h4ck3rm1k3/Cold-Saw/components/90/ReadyforBending.jpg

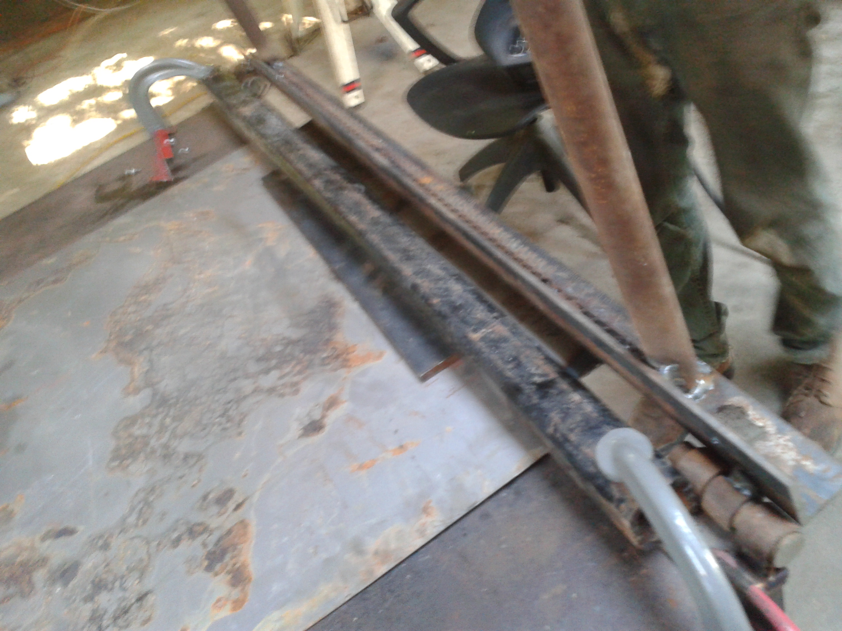
components/90/ReadyforBending.jpg
