h4ck3rm1k3/Cold-Saw/components/29/fabpics/BGSupportMark.JPG

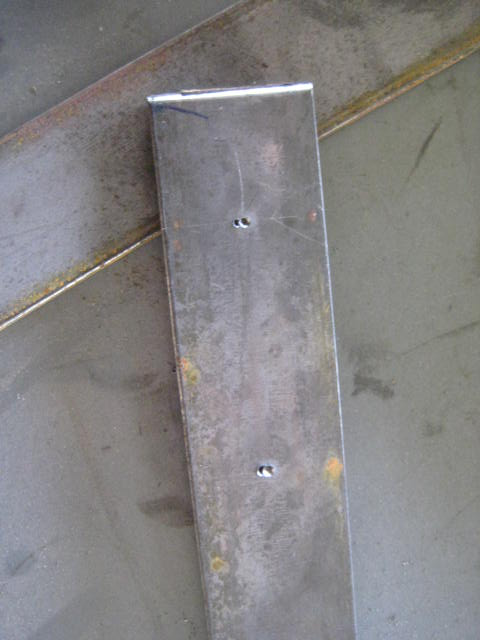
components/29/fabpics/BGSupportMark.JPG
