h4ck3rm1k3/Cold-Saw/components/90/NOTE.txt

the bend tool pictured is wrongly built, it should bend the piece
as the tool is raised upwards, not as it descends.
