h4ck3rm1k3/Cold-Saw/CalculationRationale/ViseElevationPartRationale.odt

The vise-supporting platform is large. The vise is fastened by 4 bolts. Reason: for irregular-shaped materials, the vise can be removed and the platform can be used as the work surface. Of course, elevating materials must be placed as to create a blade slot.
