h4ck3rm1k3/Cold-Saw/specs.ods

Weight | <135kg (<300lb)
Drive Type | Hydraulic
Transmission | Direct drive, key-keyway-holdingsetscrew coupling to pins-pinholes-holdingcollar
Speed | Adjustable, minimum range 30-90rpm
Torque | >5800kg-cm (>5000in-lbs)
Blade Mounting | Axial-radial shaft collar
Blade Pinhole Pattern | 2x8x45 (2 pinholes, each 8mm diameter, 45mm center-to-center from each other)
Stopper Type | Mechanical, Collar-based
Cut Angle Mechanism | Acme threaded rod and nut
Horizontal Cut Angle | +-45 degrees
Vise Max Opening | 100mm (4") with 2" deep clamp jaws
Vise Type | Autocentering
Submersible Pump Type/Flow | Brushless DC/Adjustable, approx. 4L/min (1Gal/min) at 12V
Automation Sensor/Processing/Relay | Infrared proximity/Arduino Uno Microcontroller/Opto 22 Relay
Coolant Transmission | Silicone Rubber Tube
