h4ck3rm1k3/Cold-Saw/CalculationRationale/SwivelMountDimensions/ColdSawSwivelAngle.png

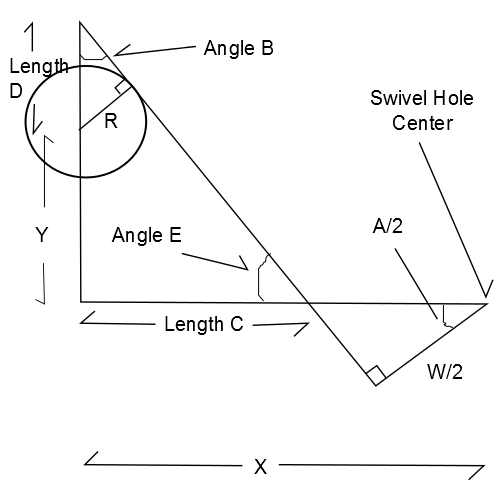
CalculationRationale/SwivelMountDimensions/ColdSawSwivelAngle.png
