h4ck3rm1k3/Cold-Saw/devtemp/Base/AngleIndicator/AngleIndicator.JPG

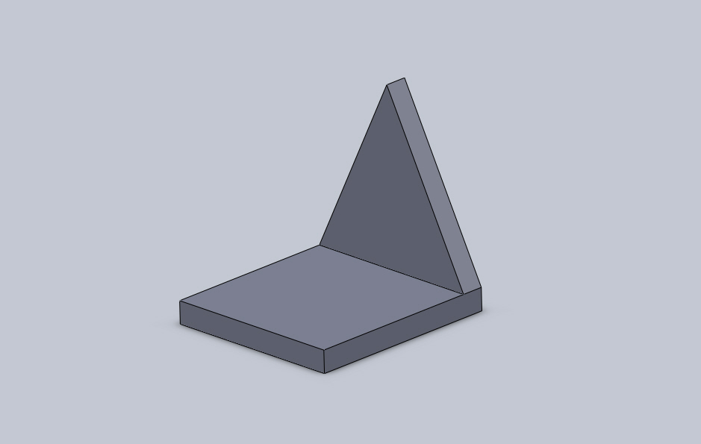
devtemp/Base/AngleIndicator/AngleIndicator.JPG
