h4ck3rm1k3/Cold-Saw/devtemp/Base/AngleIndicator/AngleIndicatorD.JPG

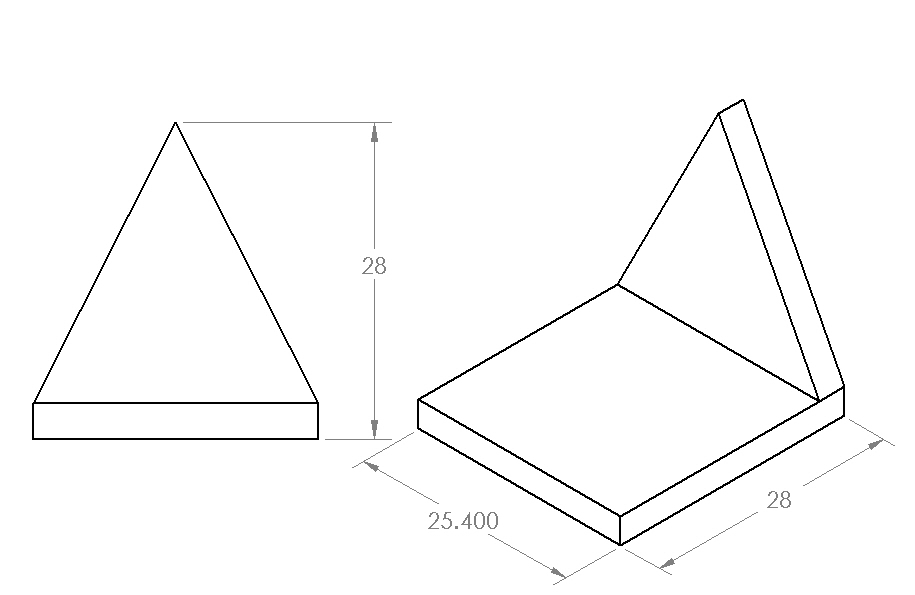
devtemp/Base/AngleIndicator/AngleIndicatorD.JPG
