h4ck3rm1k3/Cold-Saw/devtemp/Base/BaseFlat/BaseFlat.JPG

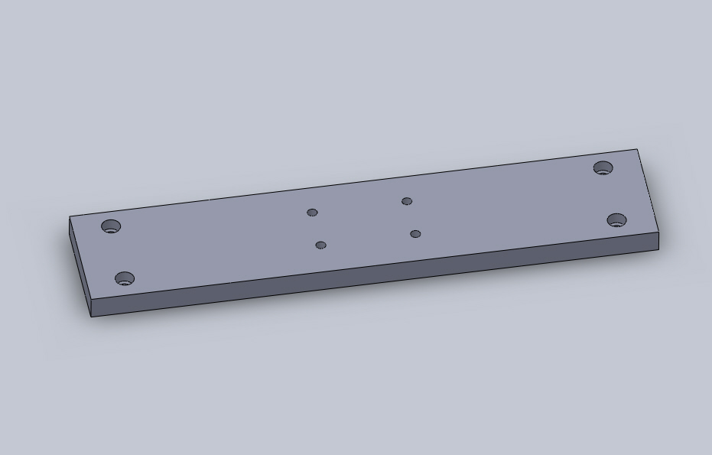
devtemp/Base/BaseFlat/BaseFlat.JPG
