h4ck3rm1k3/Cold-Saw/devtemp/Base/BaseFlat/BaseFlatD.JPG

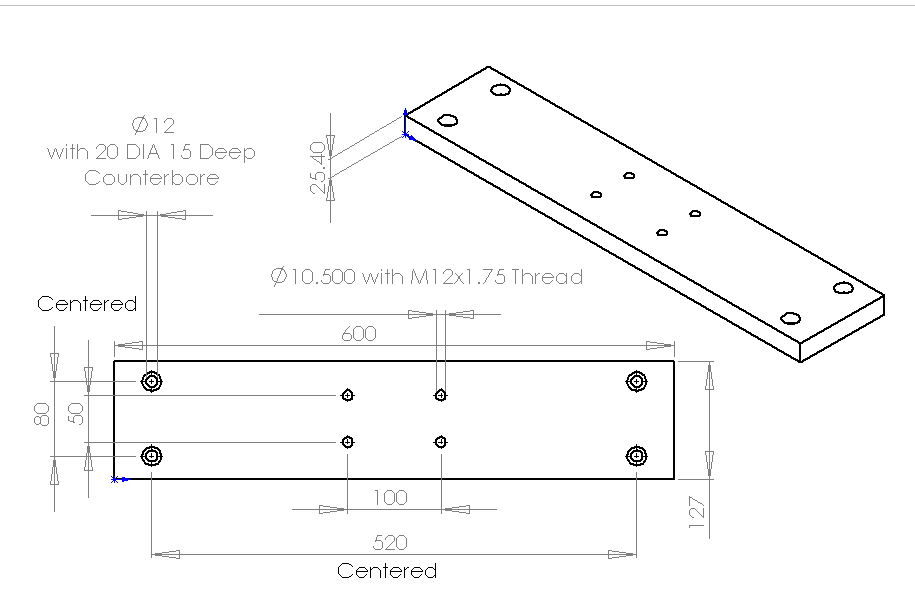
devtemp/Base/BaseFlat/BaseFlatD.JPG
