h4ck3rm1k3/Cold-Saw/devtemp/Base/BaseFlat/BaseFlatFab.JPG

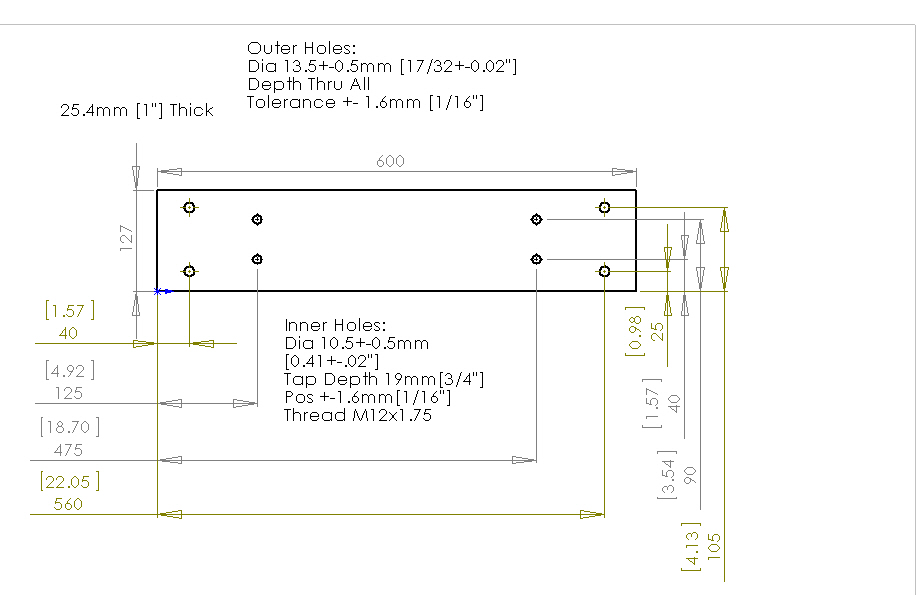
devtemp/Base/BaseFlat/BaseFlatFab.JPG
