h4ck3rm1k3/Cold-Saw/devtemp/Base/IndicatorFlat/IndicatorFlat.JPG

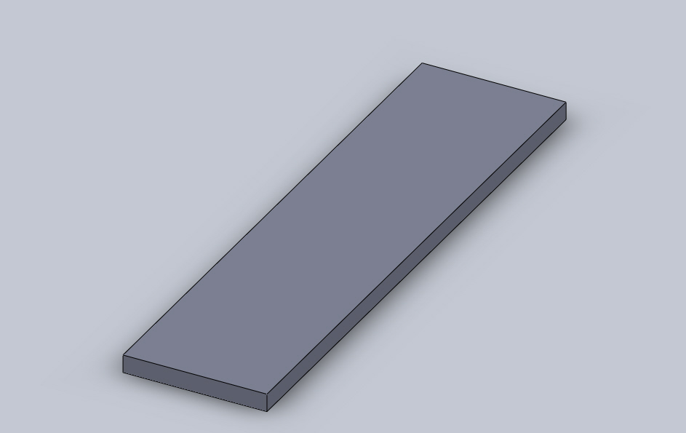
devtemp/Base/IndicatorFlat/IndicatorFlat.JPG
