h4ck3rm1k3/Cold-Saw/devtemp/Base/IndicatorFlat/IndicatorFlatD.JPG

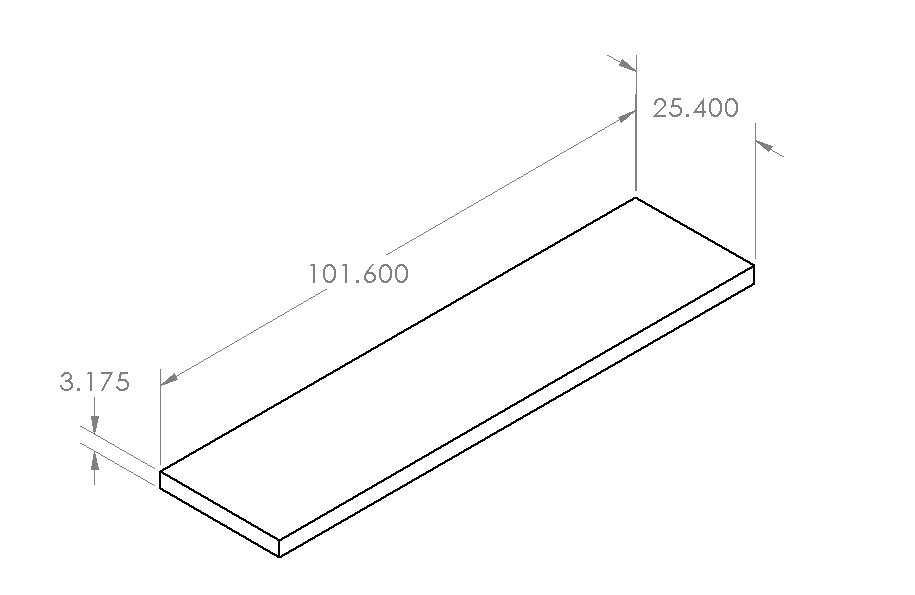
devtemp/Base/IndicatorFlat/IndicatorFlatD.JPG
