h4ck3rm1k3/Cold-Saw/devtemp/Base/ShortSpacer/ShortSpacer.JPG

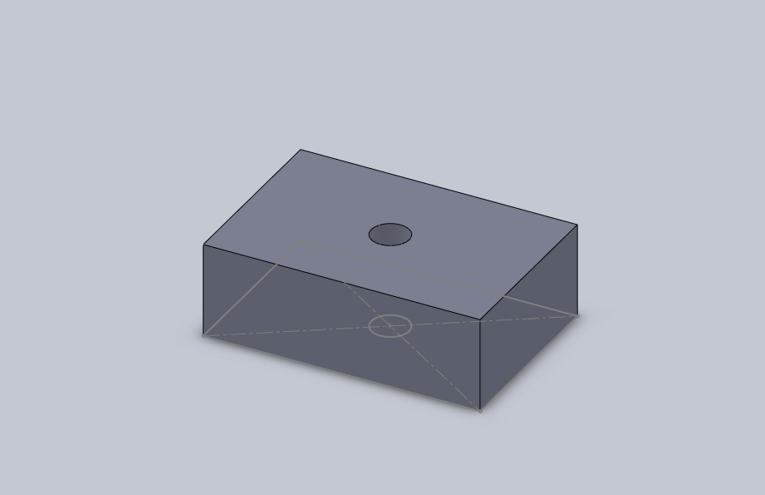
devtemp/Base/ShortSpacer/ShortSpacer.JPG
