h4ck3rm1k3/Cold-Saw/devtemp/Base/ShortSpacer/ShortSpacerD.JPG

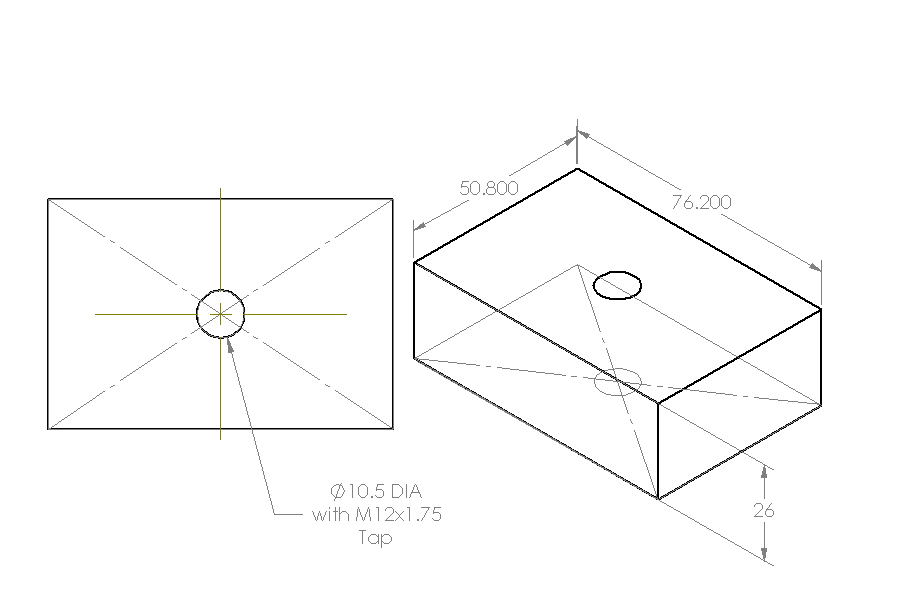
devtemp/Base/ShortSpacer/ShortSpacerD.JPG
