h4ck3rm1k3/Cold-Saw/devtemp/BladeGuard/GuardFlat/GuardFlat.JPG

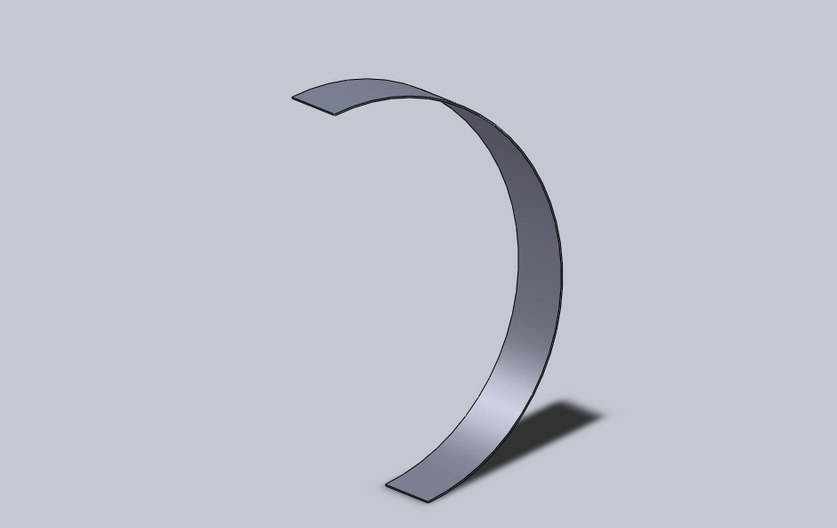
devtemp/BladeGuard/GuardFlat/GuardFlat.JPG
