h4ck3rm1k3/Cold-Saw/devtemp/Fasteners/CollarSetscrew/CollarSetscrew.JPG

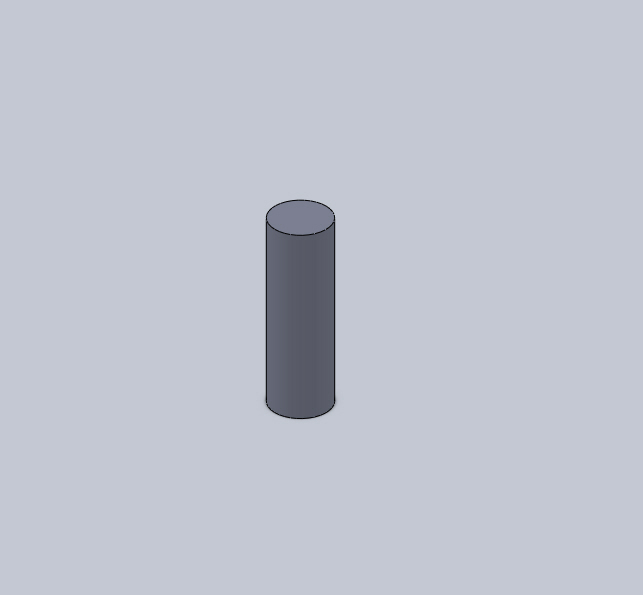
devtemp/Fasteners/CollarSetscrew/CollarSetscrew.JPG
