h4ck3rm1k3/Cold-Saw/devtemp/Fasteners/CouplingSetscrew/CouplingSetscrew.JPG

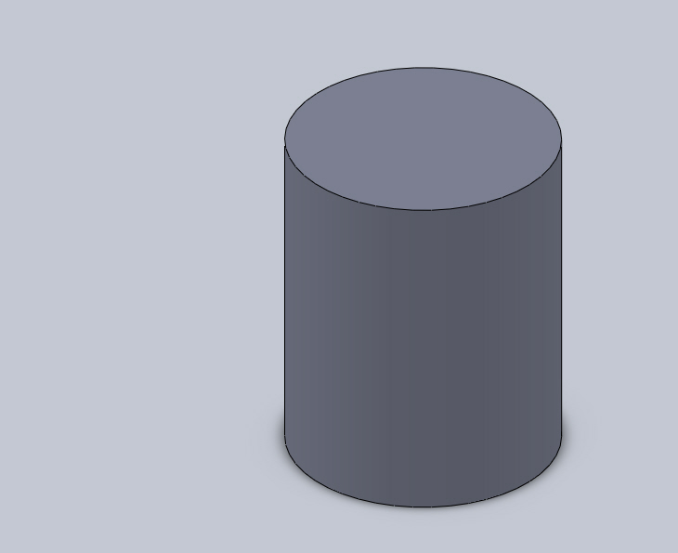
devtemp/Fasteners/CouplingSetscrew/CouplingSetscrew.JPG
