h4ck3rm1k3/Cold-Saw/devtemp/Fasteners/CouplingSetscrew/CouplingSetscrewD.JPG

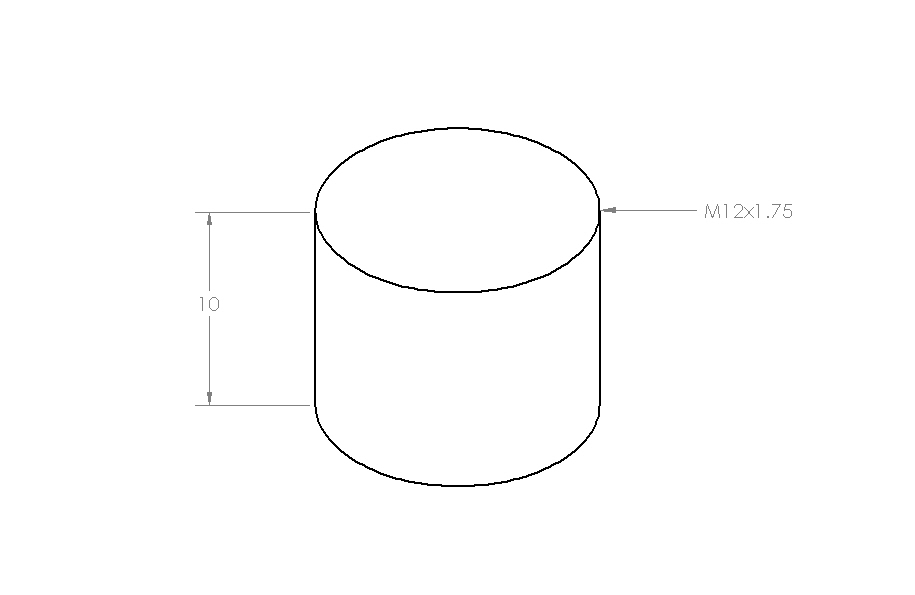
devtemp/Fasteners/CouplingSetscrew/CouplingSetscrewD.JPG
