h4ck3rm1k3/Cold-Saw/devtemp/Fasteners/ShortThreadedRod/ShortThreadedRod.JPG

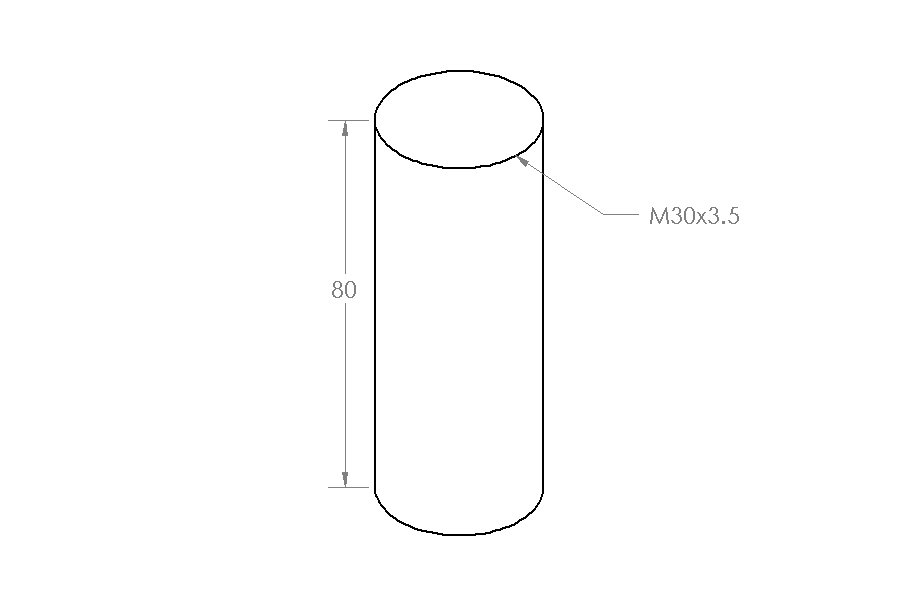
devtemp/Fasteners/ShortThreadedRod/ShortThreadedRod.JPG
