h4ck3rm1k3/Cold-Saw/devtemp/Fasteners/ThreadedRod/ThreadedRod.JPG

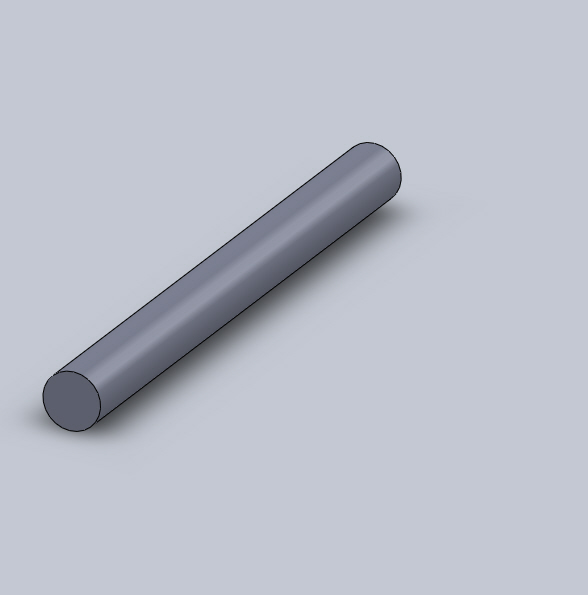
devtemp/Fasteners/ThreadedRod/ThreadedRod.JPG
