h4ck3rm1k3/Cold-Saw/devtemp/Fasteners/ThreadedRod/ThreadedRodD.JPG

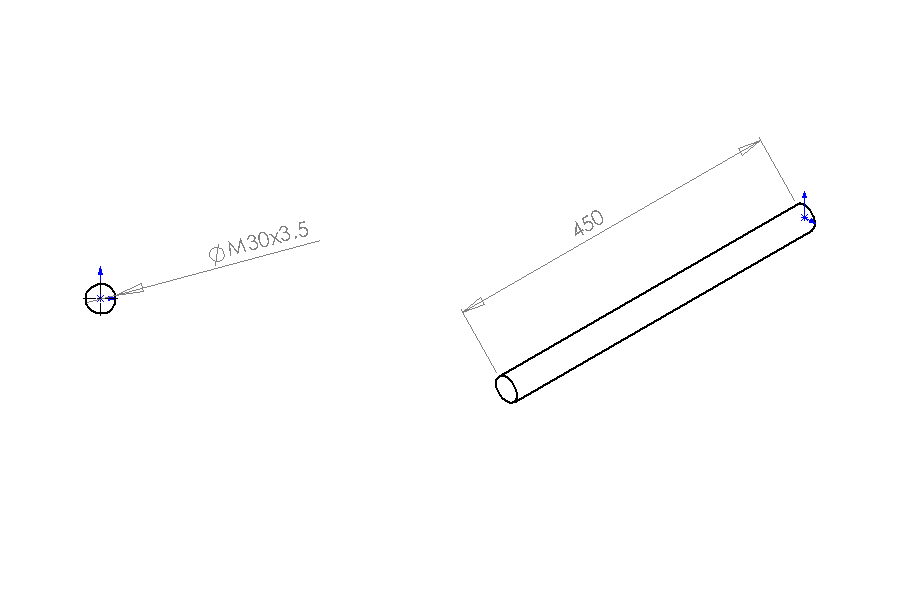
devtemp/Fasteners/ThreadedRod/ThreadedRodD.JPG
