h4ck3rm1k3/Cold-Saw/devtemp/Magnet/Magnet.JPG

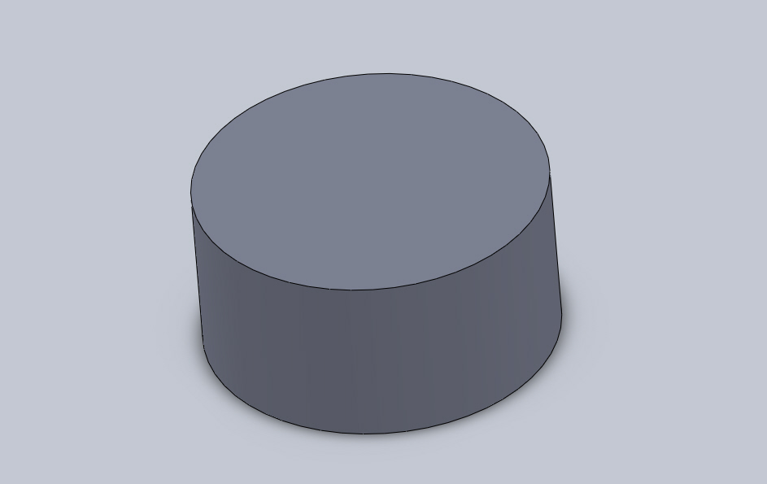
devtemp/Magnet/Magnet.JPG
