h4ck3rm1k3/Cold-Saw/devtemp/Magnet/MagnetD.JPG

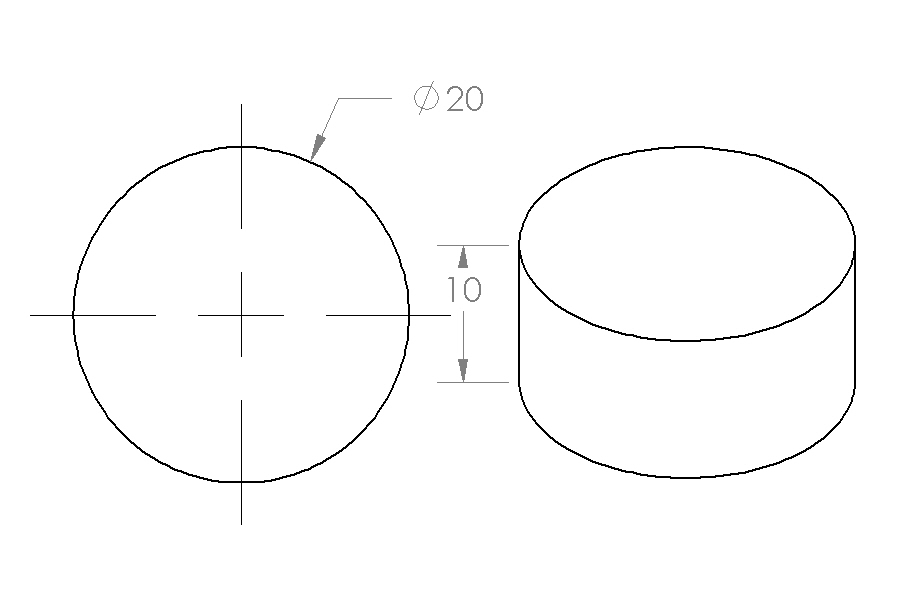
devtemp/Magnet/MagnetD.JPG
