h4ck3rm1k3/Cold-Saw/devtemp/Rotation/Pin/Pin.JPG

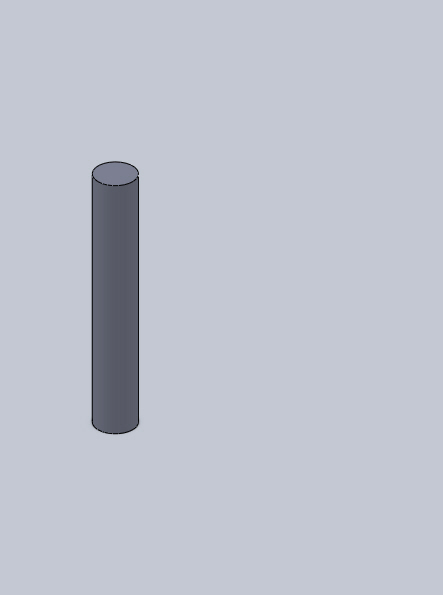
devtemp/Rotation/Pin/Pin.JPG
