h4ck3rm1k3/Cold-Saw/devtemp/Shaft Accessories/PinCollar/PinCollar.JPG

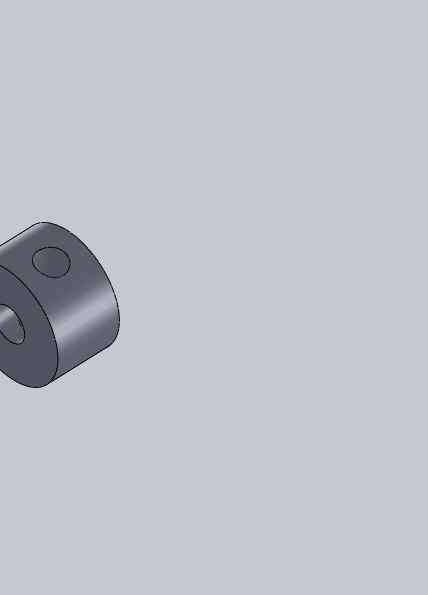
devtemp/Shaft Accessories/PinCollar/PinCollar.JPG
