h4ck3rm1k3/Cold-Saw/devtemp/Shaft Accessories/SupportThrustWasher/SupportThrustWasher.JPG

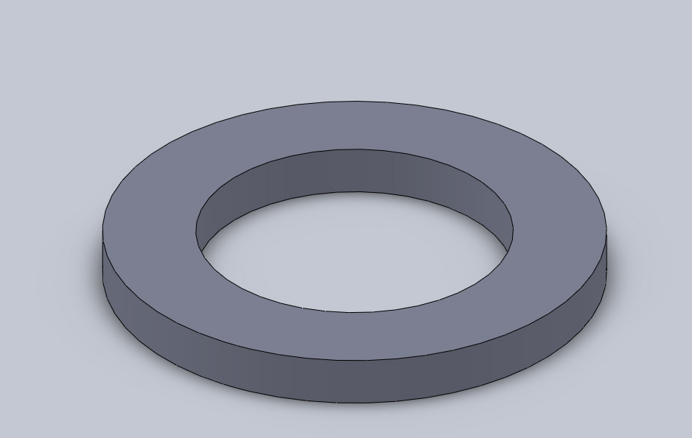
devtemp/Shaft Accessories/SupportThrustWasher/SupportThrustWasher.JPG
