h4ck3rm1k3/Cold-Saw/devtemp/Shaft Accessories/SupportThrustWasher/SupportThrustWasherD.JPG

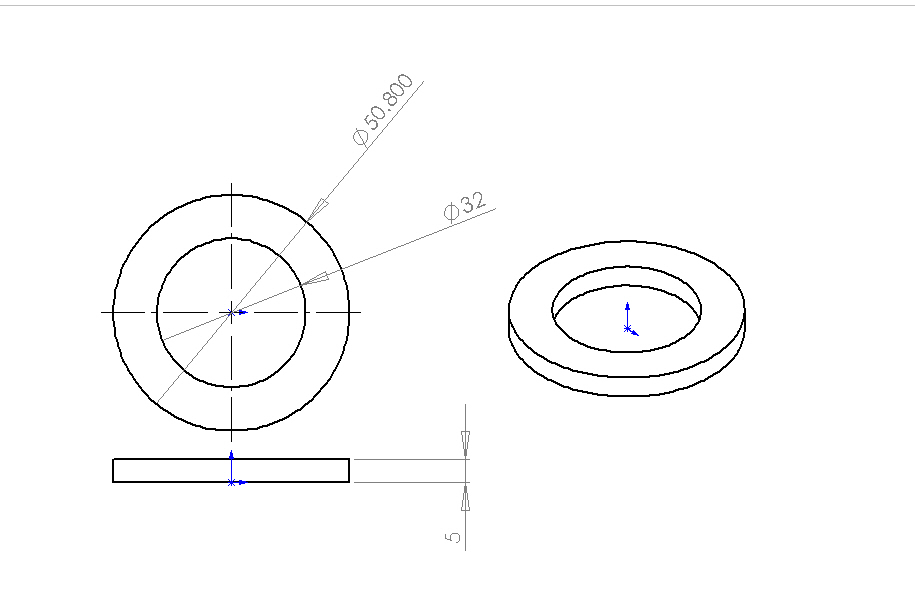
devtemp/Shaft Accessories/SupportThrustWasher/SupportThrustWasherD.JPG
