h4ck3rm1k3/Cold-Saw/devtemp/Support/BridgeFlat/BridgeFlat.JPG

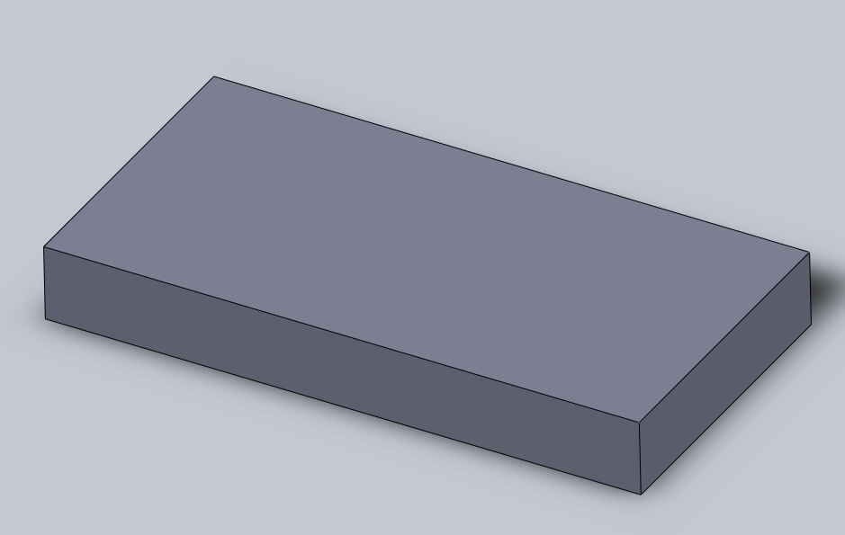
devtemp/Support/BridgeFlat/BridgeFlat.JPG
