h4ck3rm1k3/Cold-Saw/devtemp/Support/BridgeFlat/BridgeFlatD.JPG

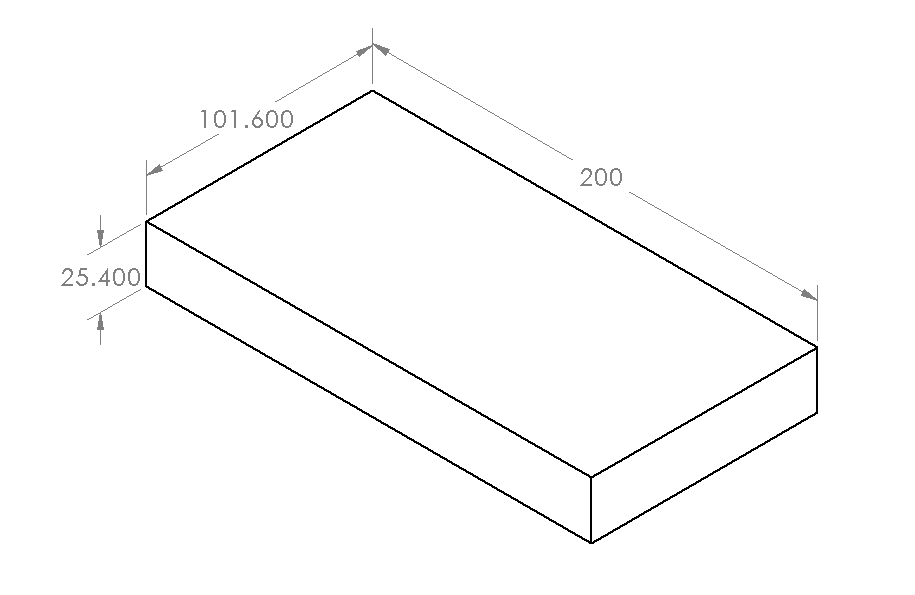
devtemp/Support/BridgeFlat/BridgeFlatD.JPG
