h4ck3rm1k3/Cold-Saw/devtemp/Swivel/ShaftBlock/ShaftBlock.JPG

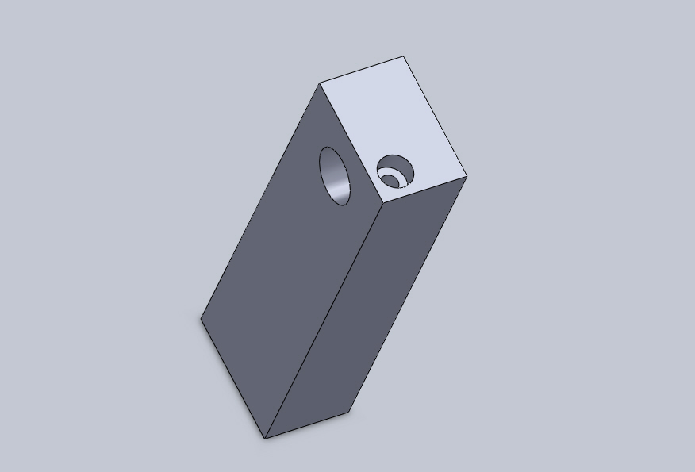
devtemp/Swivel/ShaftBlock/ShaftBlock.JPG
