h4ck3rm1k3/Cold-Saw/devtemp/Swivel/ShaftBlock/ShaftBlockD.JPG

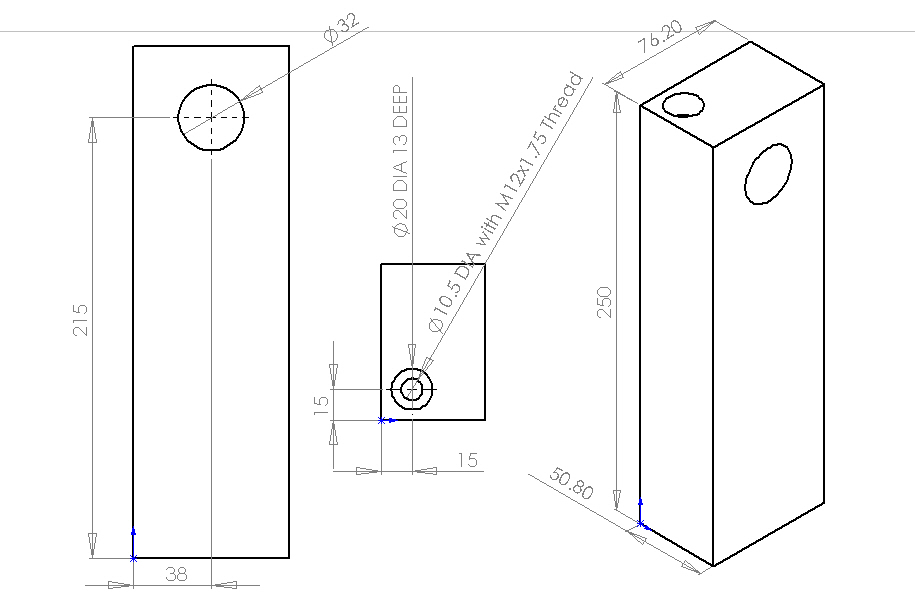
devtemp/Swivel/ShaftBlock/ShaftBlockD.JPG
