h4ck3rm1k3/Cold-Saw/devtemp/Swivel/ShaftBlock/ShaftBlockFab.JPG

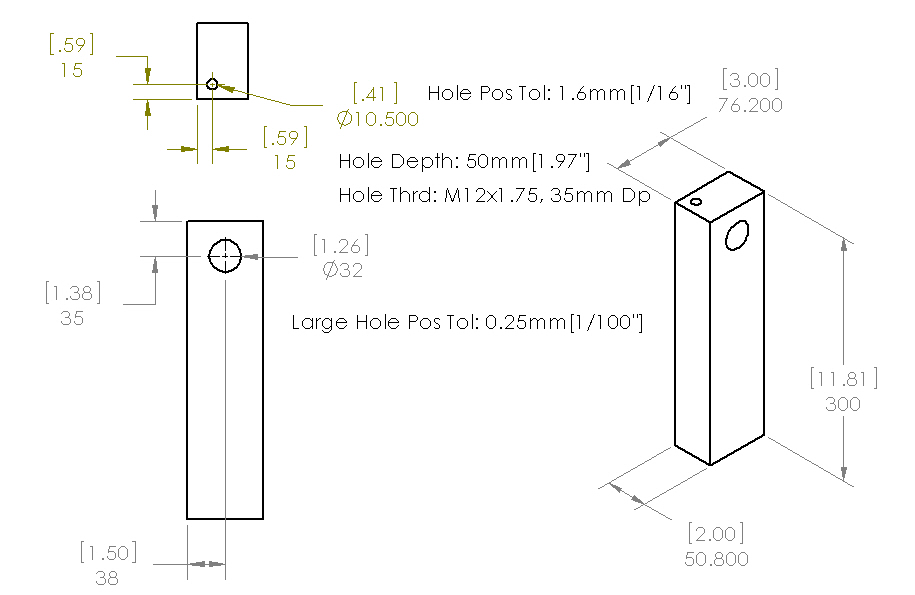
devtemp/Swivel/ShaftBlock/ShaftBlockFab.JPG
