h4ck3rm1k3/Cold-Saw/diagrampng.png

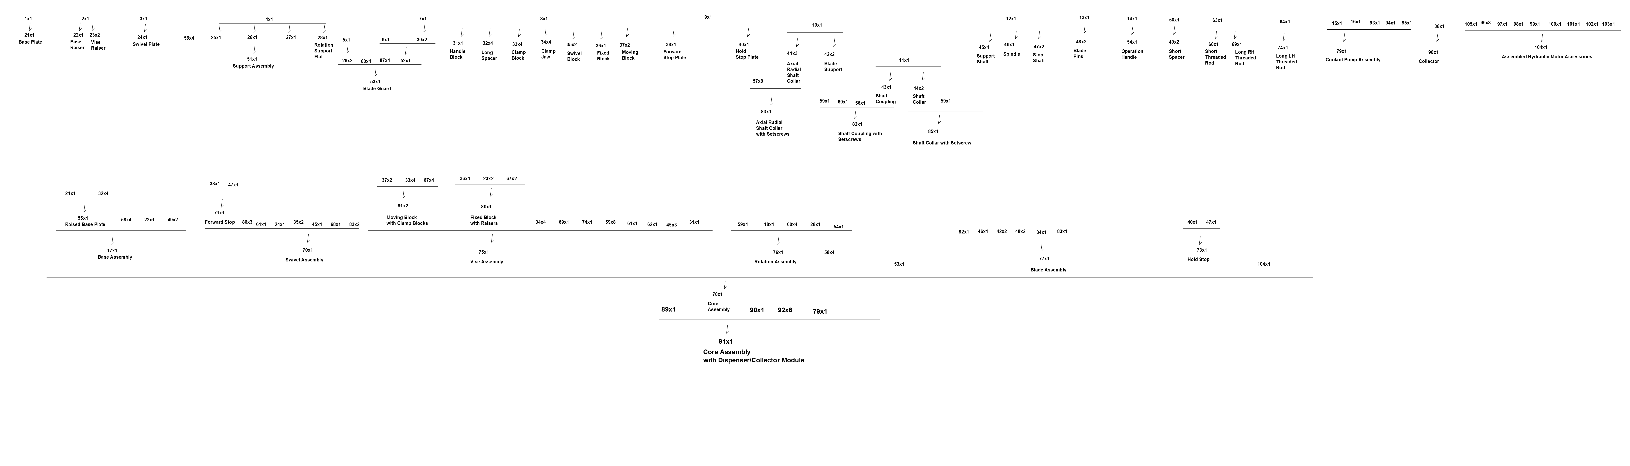
diagrampng.png
