h4ck3rm1k3/Cold-Saw/temppics/2012-08-12 17.03.41.jpg

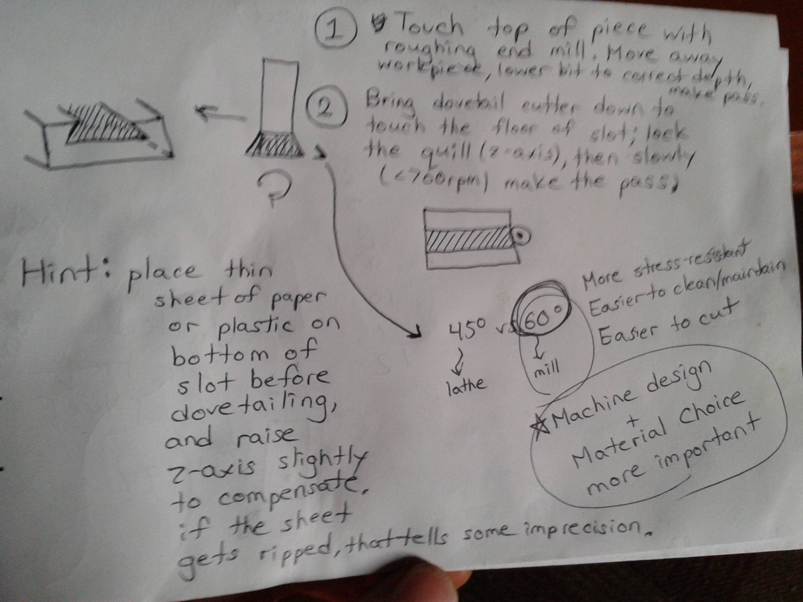
temppics/2012-08-12 17.03.41.jpg
