h4ck3rm1k3/Cold-Saw/temppics/2012-08-17 19.16.24.jpg

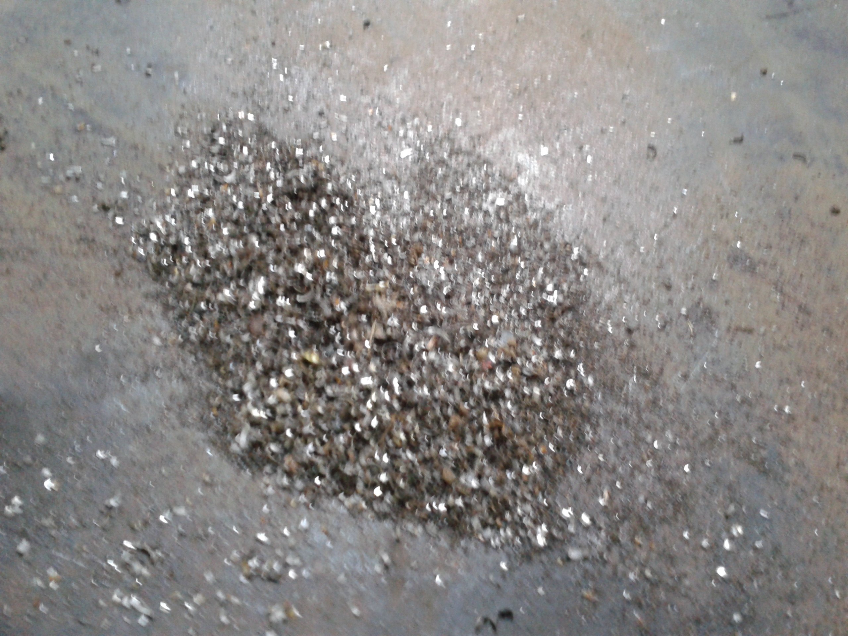
temppics/2012-08-17 19.16.24.jpg
