h4ck3rm1k3/Cold-Saw/CalculationRationale/BladeandorMaterialMove.odt

=Simply Move a Single Thing=

Just move one or the other. Moving both is unnecessarily complex for our functional objectives.

=Easy to Push Things Down=

Especially if the moving motion is manually performed, it's easier to push down on something because gravitational forces reinforce downward motion. So whatever moves should move down.

=Dangerous Fall Hazards=

Assume the material is selected to move toward the blade. If the material is moving down toward the blade, then the blade must be exposed at its top. It is much more likely to fall and get hurt by a blade if it is exposed on the top rather than on the bottom.

=Impractical Mounting Dimensions=

Assume the material is selected to move toward the blade, and that the material is placed into the clamp from above. When the blade cuts the material, the blade will have to cross a lot of the important frame locations for whatever is holding the material.

=Non-ergonomic Mounting Style=

Assume the material is selected to move toward the blade, and that the material is placed into the clamp from below. From below? Having to hold a heavy material in place while activating the clamp is difficult.

=Conclusion=

The blade moves downward toward the material.
