h4ck3rm1k3/Cold-Saw/index.ods

Categories
Rectangular Bar
Round Bar
Processed
Assembly
Fastener
Hydraulic
Coolant System
Other
Category | Reference Number | Quantity | Basic Specifications | Unit Cost | Total Cost | Source Link
Rectangular Bar | 1 | 1 | Steel 1” x 12” x 24” | 68.4 | 68.4
Rectangular Bar | 2 | 1 | Steel 1” x 3” x 36” | 30 | 30
Rectangular Bar | 3 | 1 | Steel 1” x 8” x 16” | 32 | 32
Rectangular Bar | 4 | 1 | Steel 1” x 4” x 35” | 32 | 32
Rectangular Bar | 5 | 1 | Steel 1/8” x 1” x 20” | 1 | 1
Rectangular Bar | 6 | 1 | Steel 1/16” x 3” x 25” | 2 | 2
Rectangular Bar | 7 | 1 | Steel 1/16” x 16” x 16” | 5 | 5
Rectangular Bar | 8 | 1 | Steel 2” x 3” x 107” | 441 | 441
Rectangular Bar | 9 | 1 | Steel 0.5” x 2” x 16” | 5 | 5
Round Steel | 10 | 1 | Steel 3” Dia x 6” Lg | 30 | 30
Round Bar | 11 | 1 | Steel DOM 2" OD 1.25 ID 12" Lg | 10 | 10
Round Bar | 12 | 1 | Steel 1-1/4" Dia 75" Lg | 8 | 8
Round Bar | 13 | 1 | Steel 5/16” Dia 1” Lg | 0.25 | 0.25
Round Bar | 14 | 1 | Steel Tube 1.25" Dia 1/8" Thk 29" | 5 | 5
Coolant System | 15 | 1 | Submersible Pump, 3.6L/min, 3m vertical lift | 17 | 17 | http://www.amazon.com/Brushless-Submersible-Water-Ideal-cooling/dp/B0051HI3OM?s=industrial
Coolant System | 16 | 1 | Silicone Rubber Tube, 1/4” ID, 10ft Lg | 18 | 18 | http://www.amazon.com/dp/B000FMWTRU/ref=biss_dp_t_asn
Assembly | 17 | 1 | Base Assembly |  | 0
Hydraulic | 18 | 1 | Hydraulic Motor | 250 | 250 | https://www.surpluscenter.com/item.asp?item=9-7469&catname=
 | 19 |  |  |  | 0
 | 20 |  |  |  | 0
Processed | 21 | 1 | Base Plate |  | 0
Processed | 22 | 1 | Base Raiser |  | 0
Processed | 23 | 2 | Vise Raiser |  | 0
Processed | 24 | 1 | Swivel Plate |  | 0
Processed | 25 | 1 | Short Support Flat |  | 0
Processed | 26 | 1 | Bridge Bar |  | 0
Processed | 27 | 1 | Long Support Flat |  | 0
Processed | 28 | 1 | Rotation Support Flat |  | 0
Processed | 29 | 2 | Blade Guard Support |  | 0
Processed | 30 | 2 | Blade Guard Side |  | 0
Processed | 31 | 1 | Handle Block, Steel 1" x 4" x 200mm |  | 0
Processed | 32 | 4 | Long Spacer |  | 0
Processed | 33 | 4 | Clamp Block |  | 0
Processed | 34 | 4 | Clamp Jaw |  | 0
Processed | 35 | 2 | Swivel Block |  | 0
Processed | 36 | 1 | Fixed Block |  | 0
Processed | 37 | 2 | Moving Block |  | 0
Processed | 38 | 1 | Forward Stop Plate |  | 0
 | 39 |  |  |  | 0
Processed | 40 | 1 | Hold Stop Plate |  | 0
Processed | 41 | 3 | Axial Radial Shaft Collar |  | 0
Processed | 42 | 2 | Blade Support |  | 0
Processed | 43 | 1 | Shaft Coupling |  | 0
Processed | 44 | 6 | Shaft Collar |  | 0
Processed | 45 | 4 | Support Shaft |  | 0
Processed | 46 | 1 | Spindle |  | 0
Processed | 47 | 3 | Stop Shaft |  | 0
Processed | 48 | 2 | Blade Pins |  | 0
Processed | 49 | 2 | Short Spacer |  | 0
Rectangular Bar | 50 | 1 | Steel 1.25” x 2” x 12” |  | 0
Assembly | 51 | 1 | Support Assembly |  | 0
Assembly | 52 | 1 | Blade Guard Shield |  | 0
Assembly | 53 | 1 | Blade Guard |  | 0
Assembly | 54 | 1 | Operation Handle |  | 0
Assembly | 55 | 1 | Raised Base Plate |  | 0
Fastener | 56 | 7 | M12x1.75 10mm Setscrew | 0.3 | 2.1
Fastener | 57 | 26 | M12x1.75 25mm Setscrew | 0.3 | 7.8
Fastener | 58 | 10 | Socket Head Cap M12x1.75 50mm | 1.8 | 18
Fastener | 59 | 9 | Socket Head Cap M12x1.75 70mm | 2 | 18
Fastener | 60 | 7 | M12x1.75 Nut | 0.1315 | 0.9205
Fastener | 61 | 2 | Acme 1-1/4”-5 Right-hand Thread Nut | 10 | 20
Fastener | 62 | 1 | Acme 1-1/4”-5 Left-hand Thread Nut | 10 | 10
Fastener | 63 | 1 | 1-1/4”-5 Right-hand Thread 3' Lg | 60 | 60
Fastener | 64 | 1 | 1-1/4”-5 Left-hand Thread 3' Lg | 60 | 60
 | 65 |  |  |  | 0
 | 66 |  |  |  | 0
Fastener | 67 | 6 | Brass 1.5” OD 1.25” ID 3” Lg | 12 | 72
Fastener | 68 | 1 | 1-1/4”-5 Right-hand Thread 80mm Lg |  | 0
Fastener | 69 | 1 | 1-1/4”-5 Right-hand Thread 250mm Lg |  | 0
Assembly | 70 | 1 | Swivel Assembly |  | 0
Assembly | 71 | 1 | Forward Stop |  | 0
Assembly | 72 | 1 | Backward Stop |  | 0
Assembly | 73 | 1 | Hold Stop |  | 0
Fastener | 74 | 1 | 1-1/4”-5 Left-hand Thread 250mm Lg with Flat |  | 0
Assembly | 75 | 1 | Vise Assembly |  | 0
Assembly | 76 | 1 | Rotation Assembly |  | 0
Assembly | 77 | 1 | Blade Assembly |  | 0
Assembly | 78 | 1 | Core Assembly |  | 0
Assembly | 79 | 1 | Coolant Pump Assembly |  | 0
Assembly | 80 | 1 | Fixed Block with Raisers |  | 0
Assembly | 81 | 2 | Moving Block with Clamp Blocks |  | 0
Assembly | 82 | 1 | Shaft Coupling with Setscrews |  | 0
Assembly | 83 | 3 | Axial Radial Shaft Collar with Setscrews |  | 0
Other | 84 | 1 | Cold Saw Blade 350mm Dia | 150 | 150
Assembly | 85 | 1 | Shaft Collar with Setscrew |  | 0
Fastener | 86 | 6 | Washer 34mm ID 60mm OD | 0.1 | 0.6
Fastener | 87 | 4 | Washer 14mm ID 25mm OD | 0.1 | 0.4
Rectangular Bar | 88 | 1 | Steel 1/16” x 32” x 24” | 10 | 10
Rectangular Bar | 89 | 1 | Steel 1/16” x 5” x 20” | 5 | 5
Processed | 90 | 1 | Collector |  | 0
Assembly | 91 | 1 | Core Assembly with Dispenser/Collector Module |  | 0
Other | 92 | 6 | Magnet | 0.5 | 3
Coolant System | 93 | 1 | 5 gallon bucket | 5 | 5
Coolant System | 94 | 1 | 1” Hose Clamp | 1 | 1
Coolant System | 95 | 1 | 1” C Clamp | 1 | 1
Hydraulic | 96 | 3 | 1/2” NPT Quick Coupling Pair
Hydraulic | 97 | 1 | 1/4” NPT Quick Coupling Pair |  | 0
Hydraulic | 98 | 1 | SAE10M to 1/2”NPTM
Hydraulic | 99 | 1 | SAE4M to 1/4”NPTM
Hydraulic | 100 | 1 | 12” Long 1/2”NPTM Hose
Hydraulic | 101 | 1 | Tee 1/2”NPTF
Hydraulic | 102 | 1 | 1/2”NPTM to 1/4”NPTF
Hydraulic | 103 | 1 | 1/2”NPTM to 1/2”NPTM
Assembly | 104 | 1 | Hydraulic Motor Accessories
Hydraulic | 105 | 1 | Teflon Tape
TOTAL | XXX |  |  |  | 1399.4705
