h4ck3rm1k3/Cold-Saw/simplecostbreakdown.ods

Item | Cost
Steel | 684.65
Fasteners | 267.72
Hydraulic Motor | 250
Cold Saw Blade | 150
Hydraulic Hoses and Fittings | 100
Electronics | 120
Coolant Hardware | 50
Build Consumables | 10
Total | 1632.37
