h4ck3rm1k3/Cold-Saw/CalculationRationale/IndustryAnalysis/IndustryAnalysis.ods

https://docs.google.com/spreadsheet/ccc?key=0AlpsBarfpPkzdFdaMWlNSUF0V3Y5VDBuNWx5cG9Ec0E
Brand | Model | Basic Specifications | Basic Design | Features | Advantages | Drawbacks | Cost | Weight | Dimensions (Lxwxh) | Source
Grizzly | G0665 | 1.25hp, 50rpm, 10" blade dia, 1.25" arbor dia, 3.5" vise opening , -45 to +45 cut angle |  | Quick Release Vise, Blade Coolant System, Angle Locking, Auto-retract Blade Guard, Spring Return, Safety Switch | Monolithic cast iron design | Unnecessary geometry | 995 | 302 |  | http://www.grizzly.com/products/G0665
 |  |  |  |  |  |  |  |  |  | http://www.scotchman.com/cold-saws/manual-and-semi-automatic/cpo275/
 |  |  |  |  |  |  |  |  |  | http://www.doringer.com/d300.htm
