h4ck3rm1k3/Cold-Saw/components/17/17model.JPG

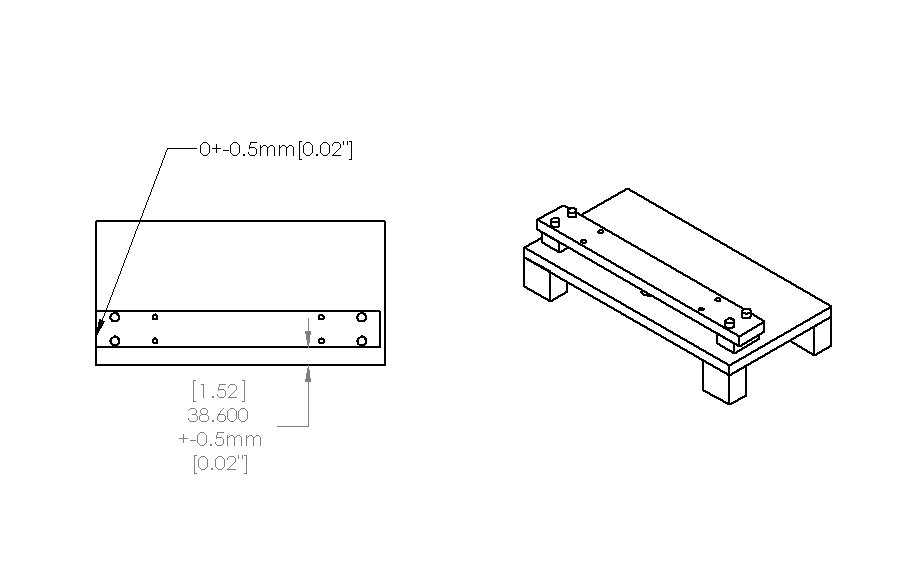
components/17/17model.JPG
