h4ck3rm1k3/Cold-Saw/components/18/HydraulicMotor.JPG

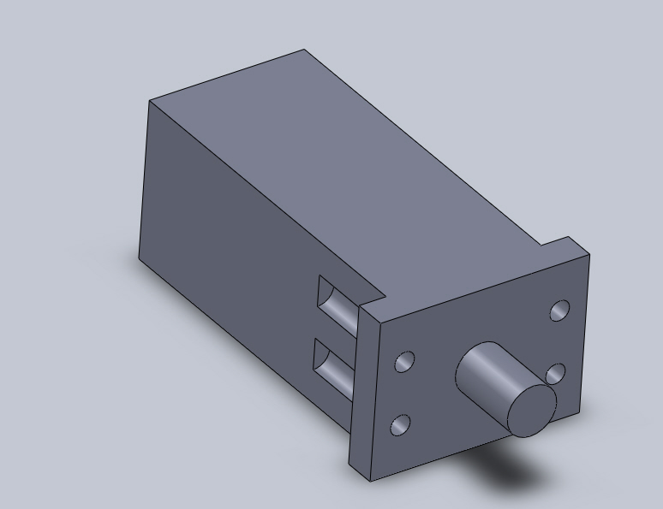
components/18/HydraulicMotor.JPG
