h4ck3rm1k3/Cold-Saw/components/21/Baseplate.JPG

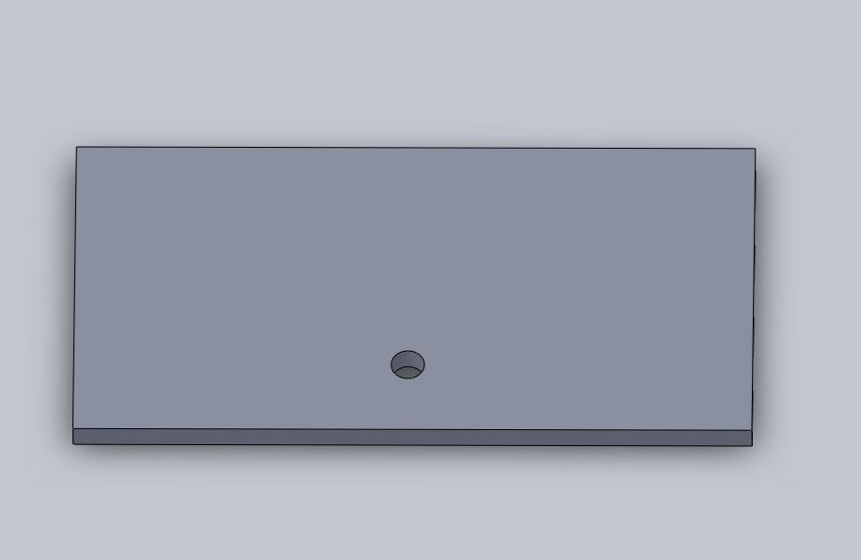
components/21/Baseplate.JPG
