h4ck3rm1k3/Cold-Saw/components/21/BaseplateD.JPG

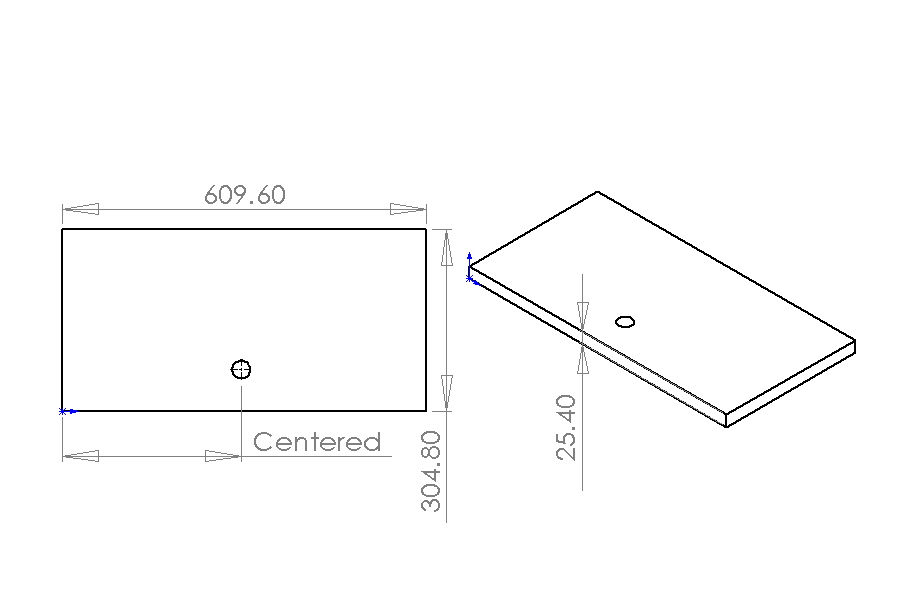
components/21/BaseplateD.JPG
