h4ck3rm1k3/Cold-Saw/components/21/BaseplateFab.JPG

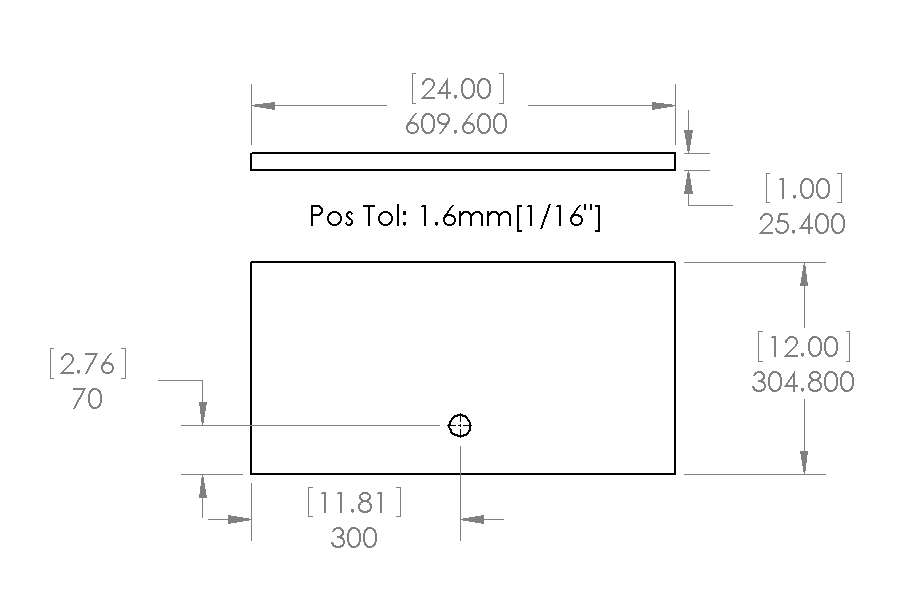
components/21/BaseplateFab.JPG
