h4ck3rm1k3/Cold-Saw/components/23/Raiser.JPG

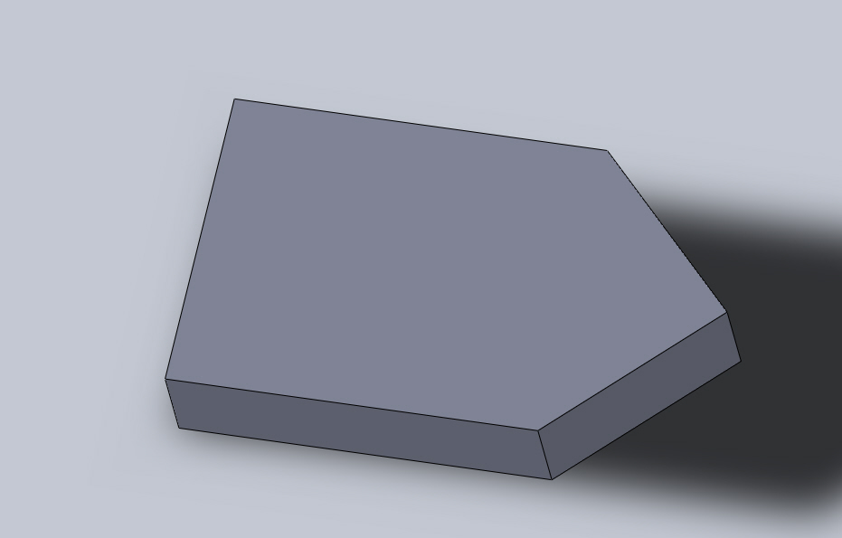
components/23/Raiser.JPG
