h4ck3rm1k3/Cold-Saw/components/23/RaiserD.JPG

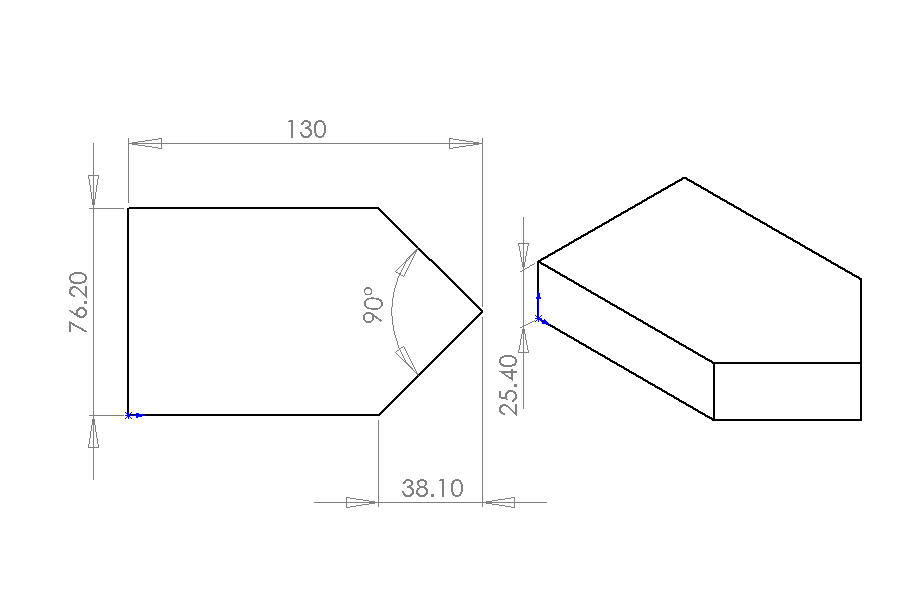
components/23/RaiserD.JPG
