h4ck3rm1k3/Cold-Saw/components/23/RaisersIronworked.JPG

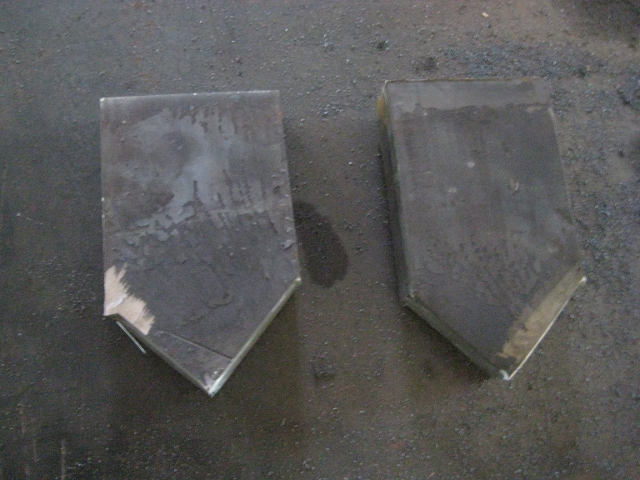
components/23/RaisersIronworked.JPG
