h4ck3rm1k3/Cold-Saw/components/23/SpeedSquaringRaiser.JPG

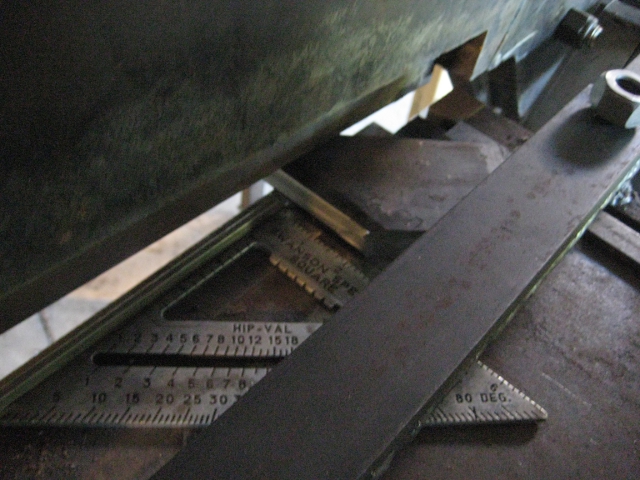
components/23/SpeedSquaringRaiser.JPG
