h4ck3rm1k3/Cold-Saw/components/24/SwivelPlate.JPG

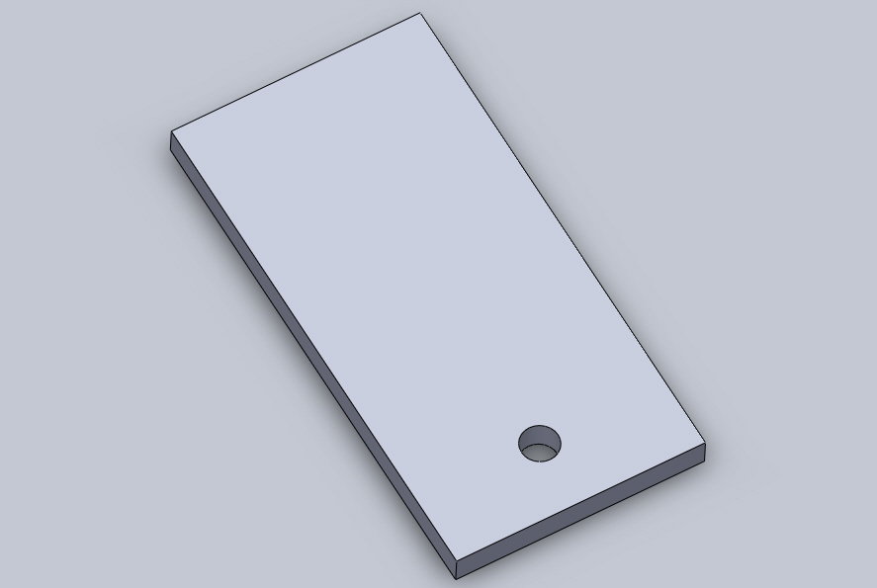
components/24/SwivelPlate.JPG
