h4ck3rm1k3/Cold-Saw/components/25/ShortSupportFlat.JPG

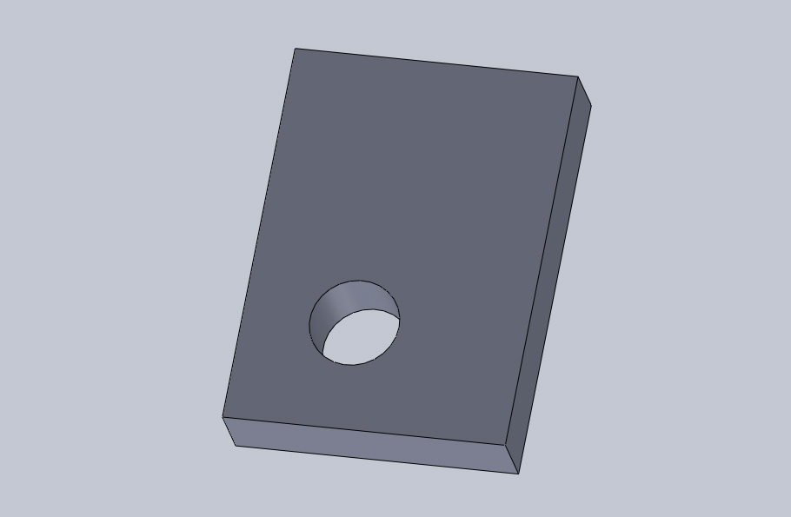
components/25/ShortSupportFlat.JPG
