h4ck3rm1k3/Cold-Saw/components/25/ShortSupportFlatD.JPG

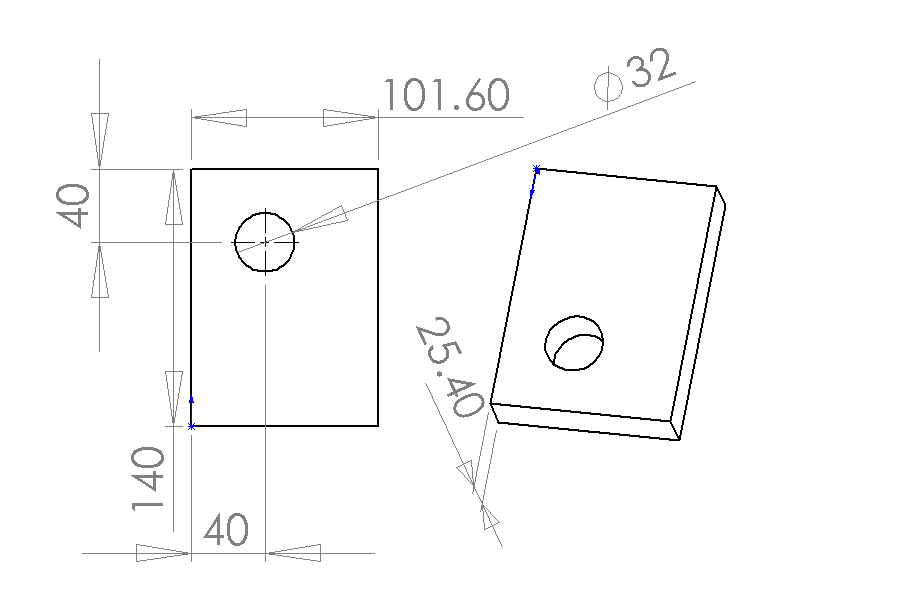
components/25/ShortSupportFlatD.JPG
