h4ck3rm1k3/Cold-Saw/components/27/LongSupportFlat.JPG

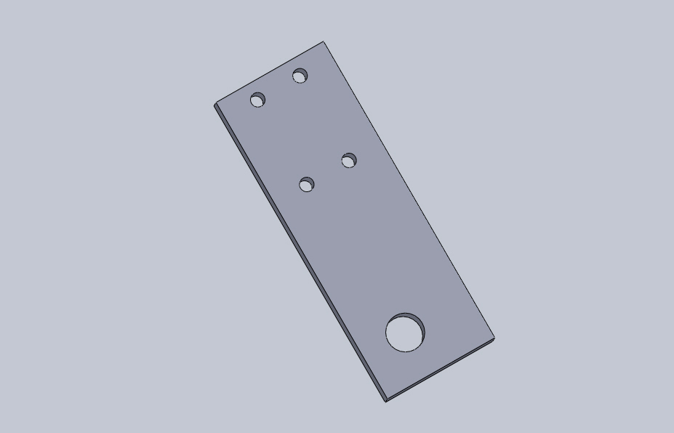
components/27/LongSupportFlat.JPG
