h4ck3rm1k3/Cold-Saw/components/27/LongSupportFlatD.JPG

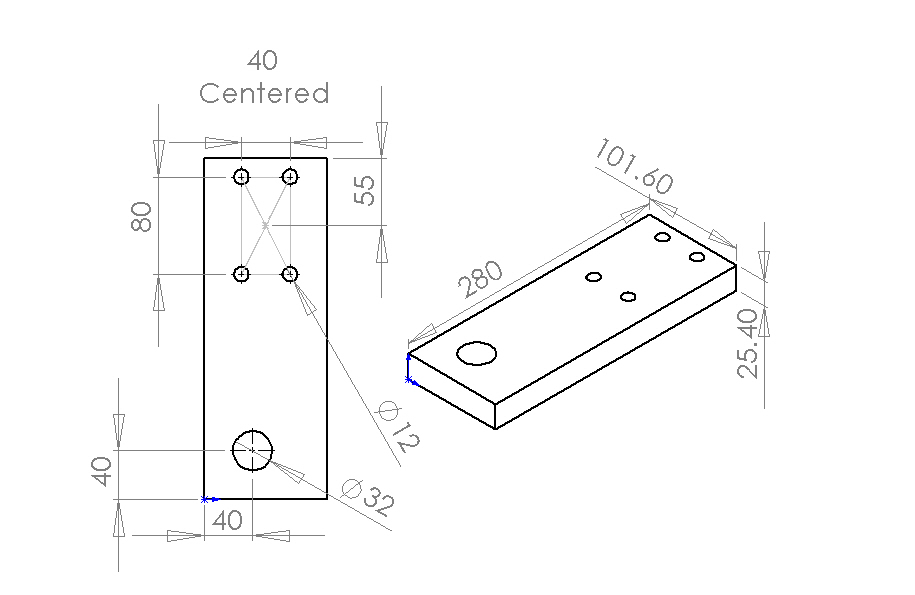
components/27/LongSupportFlatD.JPG
