h4ck3rm1k3/Cold-Saw/components/27/LongSupportFlatFab.JPG

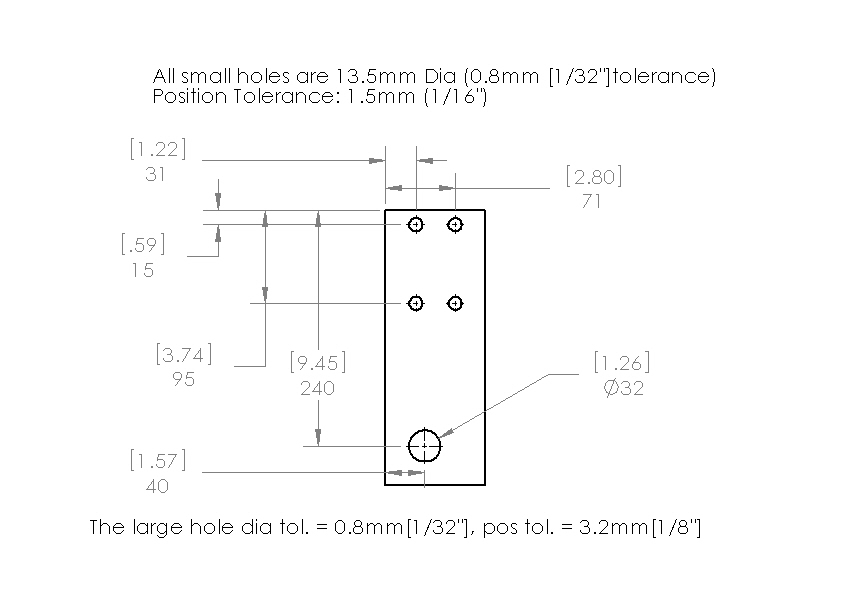
components/27/LongSupportFlatFab.JPG
