h4ck3rm1k3/Cold-Saw/components/28/2-22finished.jpg

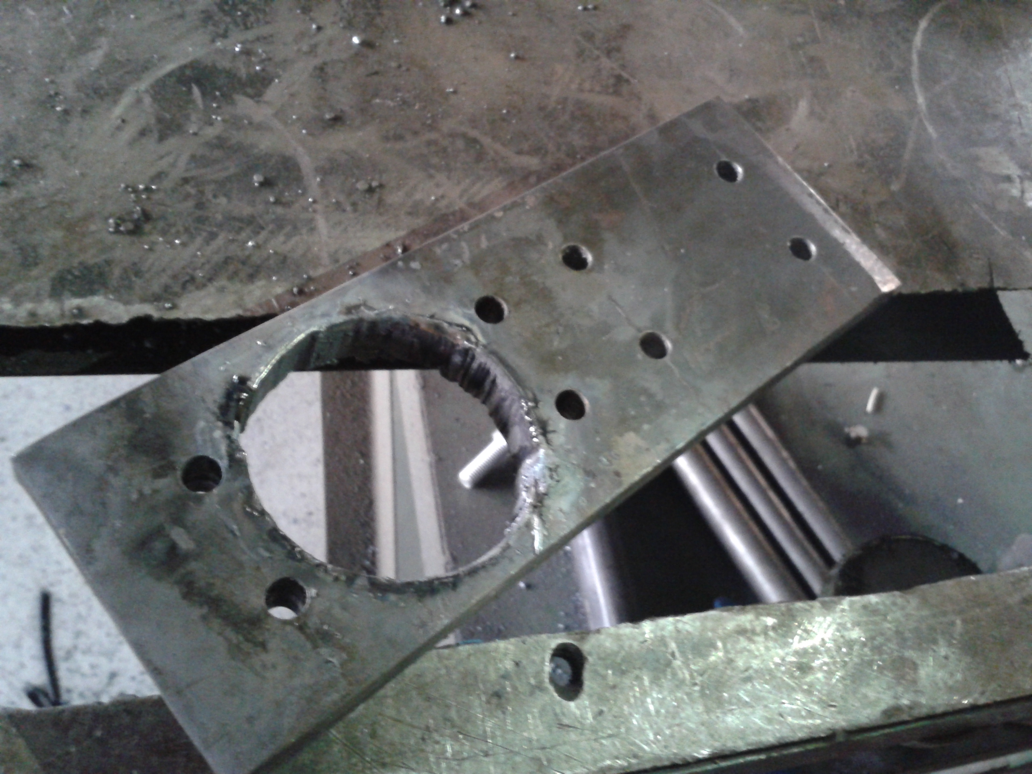
components/28/2-22finished.jpg
