h4ck3rm1k3/Cold-Saw/components/28/RotationSupportFlat.JPG

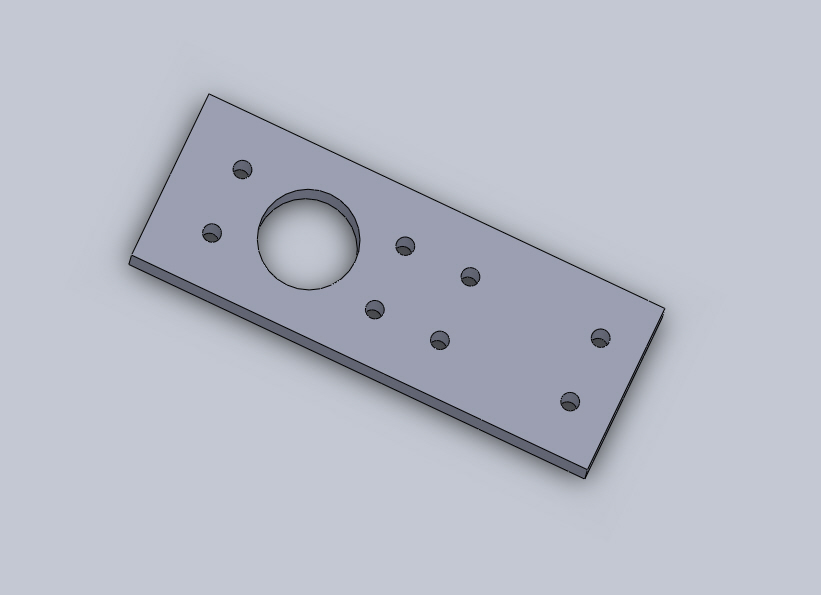
components/28/RotationSupportFlat.JPG
