h4ck3rm1k3/Cold-Saw/components/28/RotationSupportFlatD.JPG

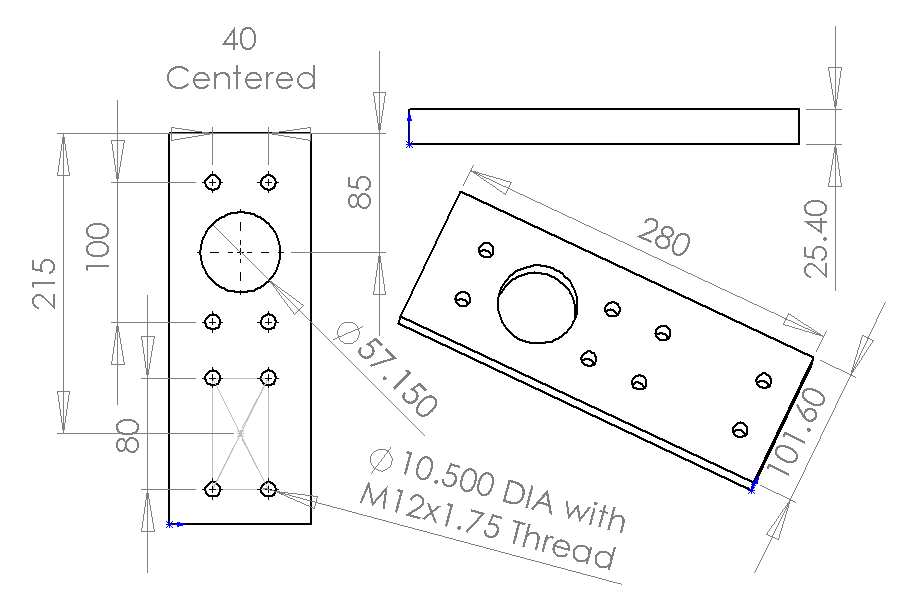
components/28/RotationSupportFlatD.JPG
