h4ck3rm1k3/Cold-Saw/components/28/RotationSupportFlatFab.JPG

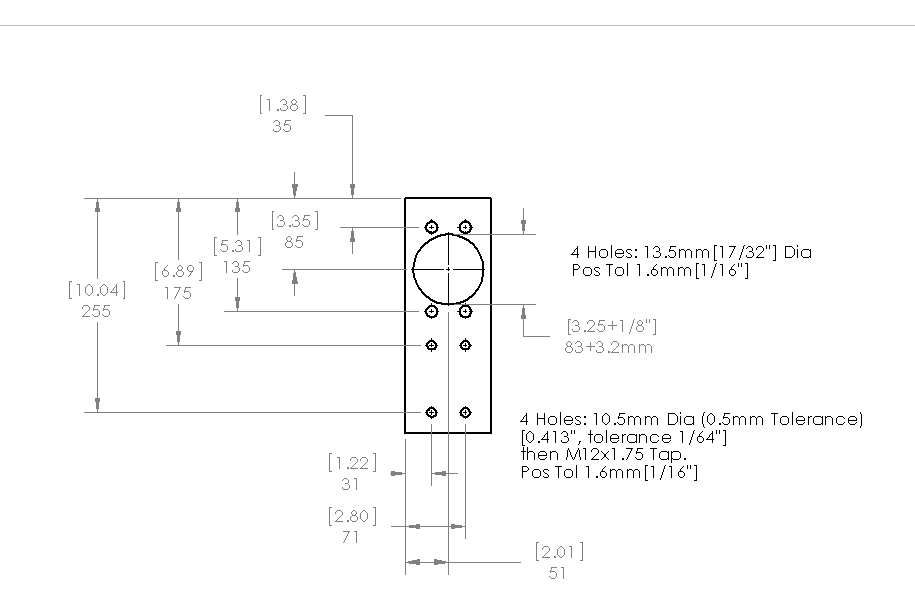
components/28/RotationSupportFlatFab.JPG
