h4ck3rm1k3/Cold-Saw/components/29/GuardSupport.JPG

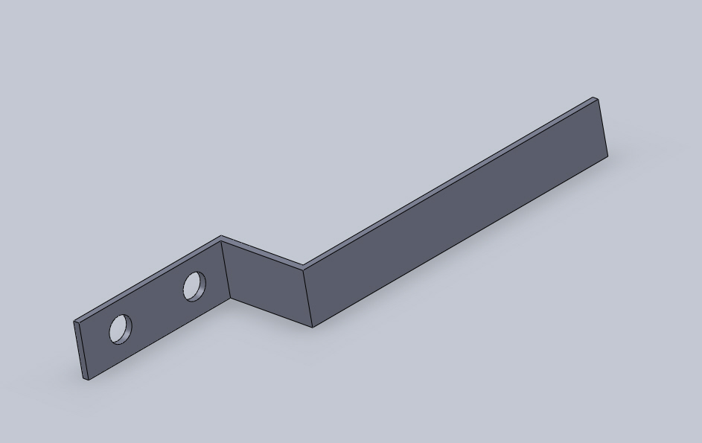
components/29/GuardSupport.JPG
