h4ck3rm1k3/Cold-Saw/components/30/2-13finished.jpg

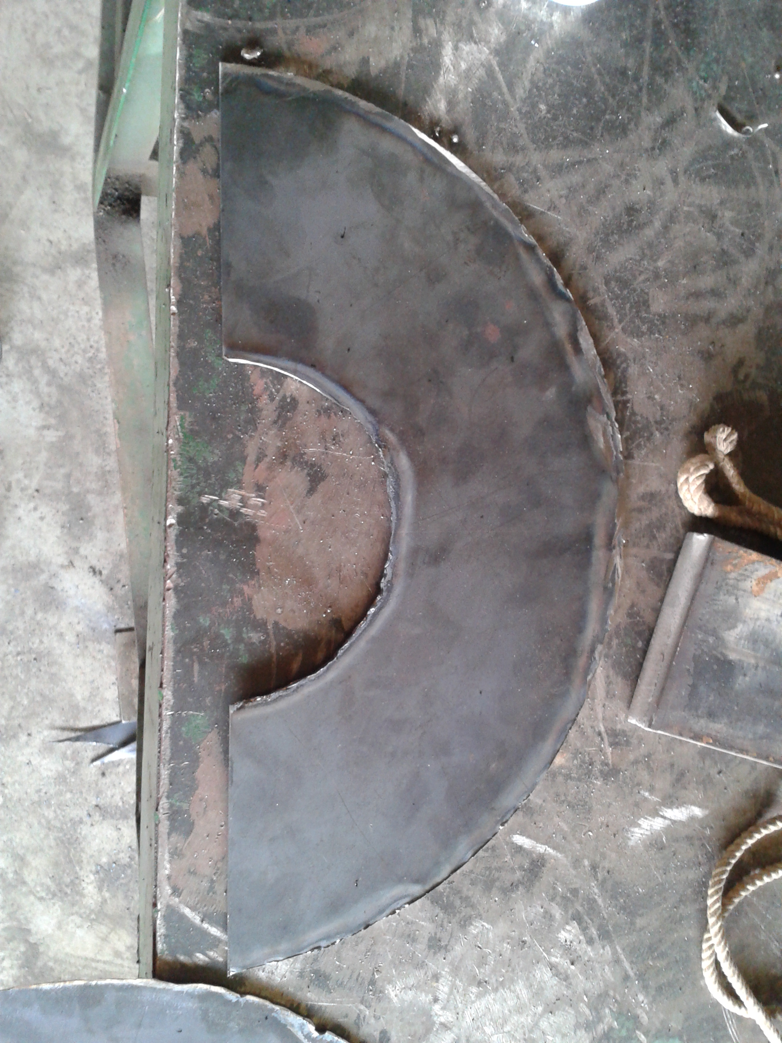
components/30/2-13finished.jpg
