h4ck3rm1k3/Cold-Saw/components/30/GuardSide.JPG

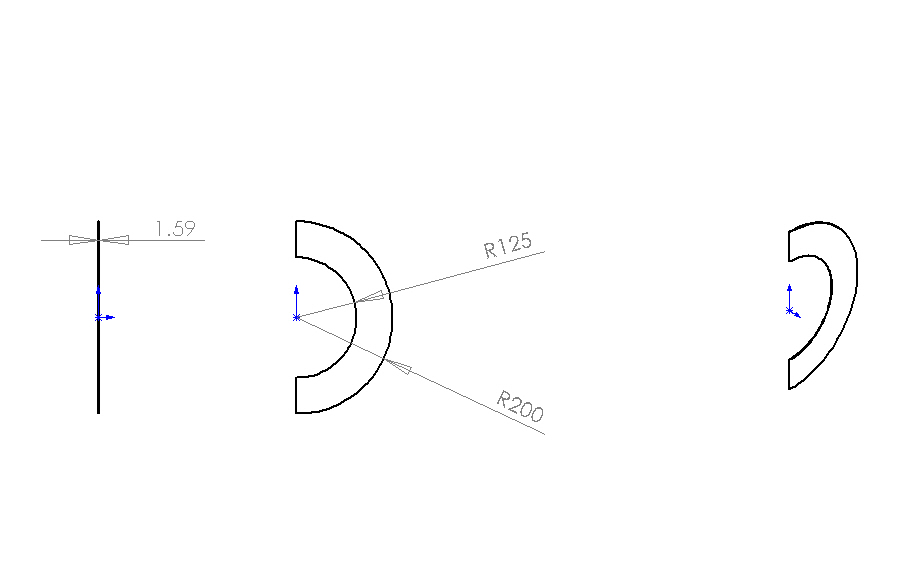
components/30/GuardSide.JPG
