h4ck3rm1k3/Cold-Saw/components/31/HandleBlock.JPG

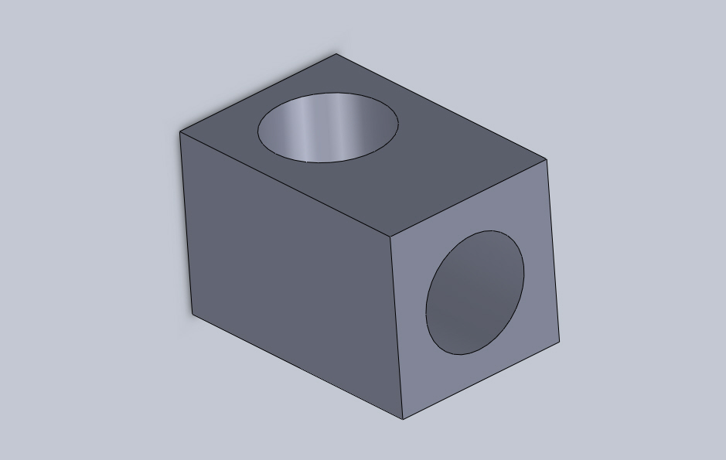
components/31/HandleBlock.JPG
