h4ck3rm1k3/Cold-Saw/components/31/HandleBlockD.JPG

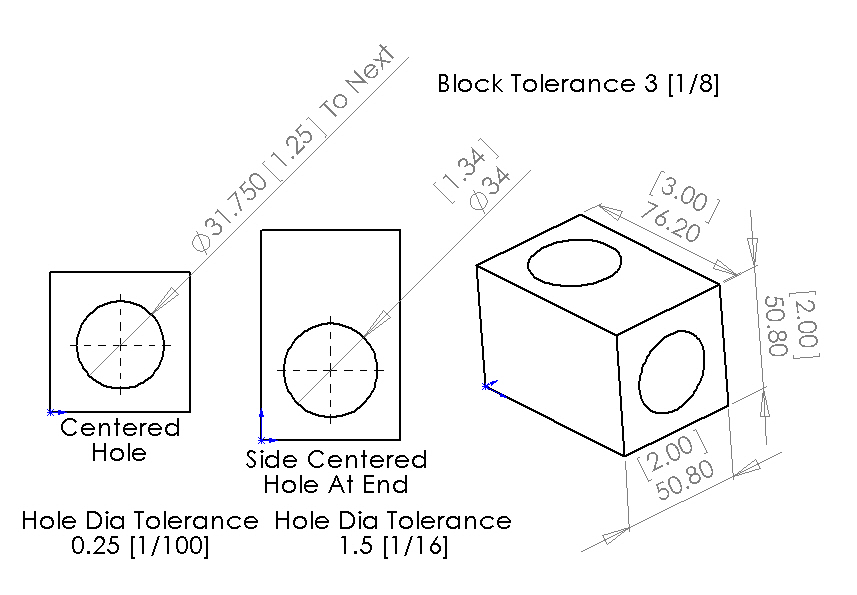
components/31/HandleBlockD.JPG
