h4ck3rm1k3/Cold-Saw/components/32/LongSpacer.JPG

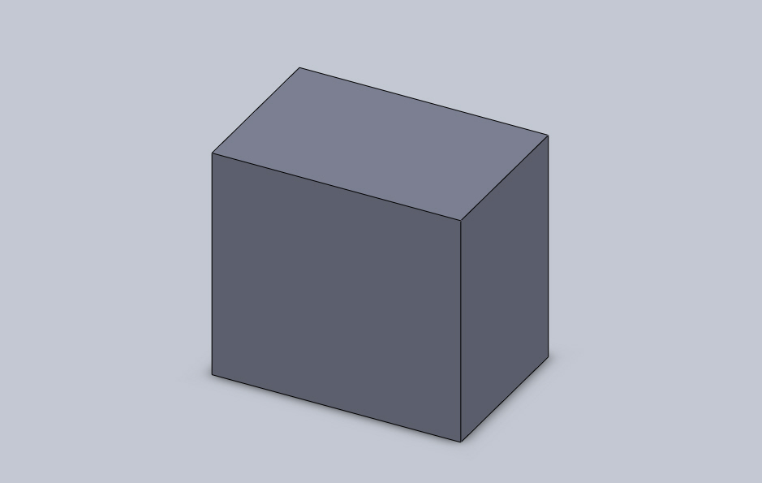
components/32/LongSpacer.JPG
