h4ck3rm1k3/Cold-Saw/components/32/LongSpacerD.JPG

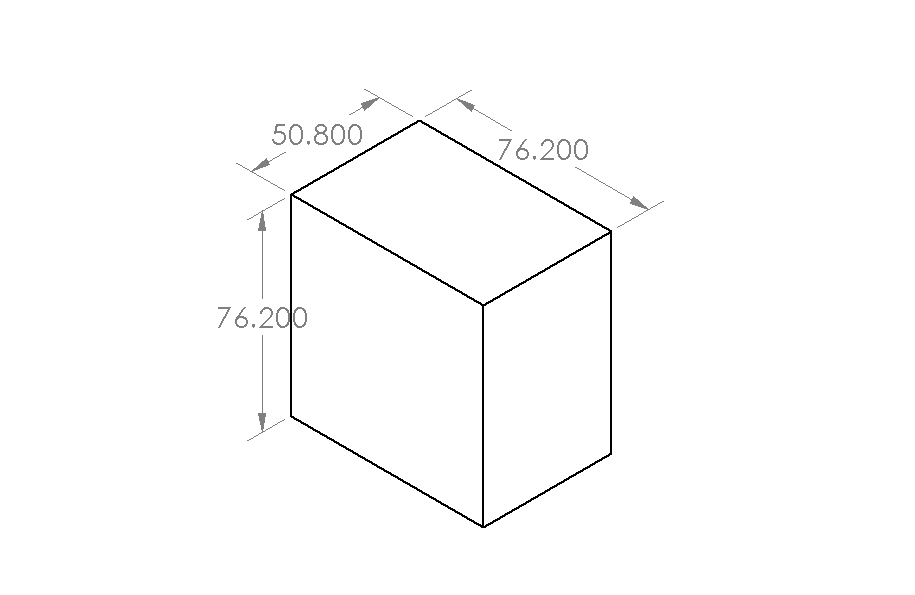
components/32/LongSpacerD.JPG
