h4ck3rm1k3/Cold-Saw/components/33/ClampBlock.JPG

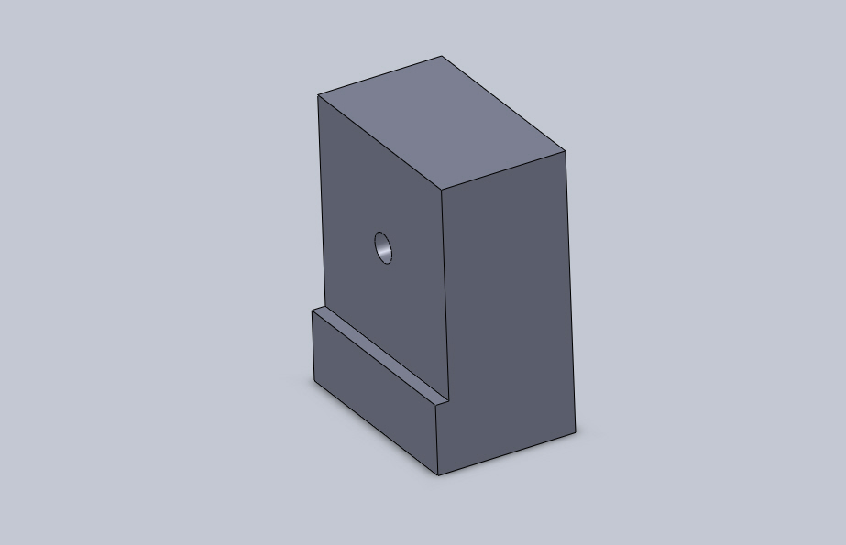
components/33/ClampBlock.JPG
