h4ck3rm1k3/Cold-Saw/components/33/ClampBlockFab.JPG

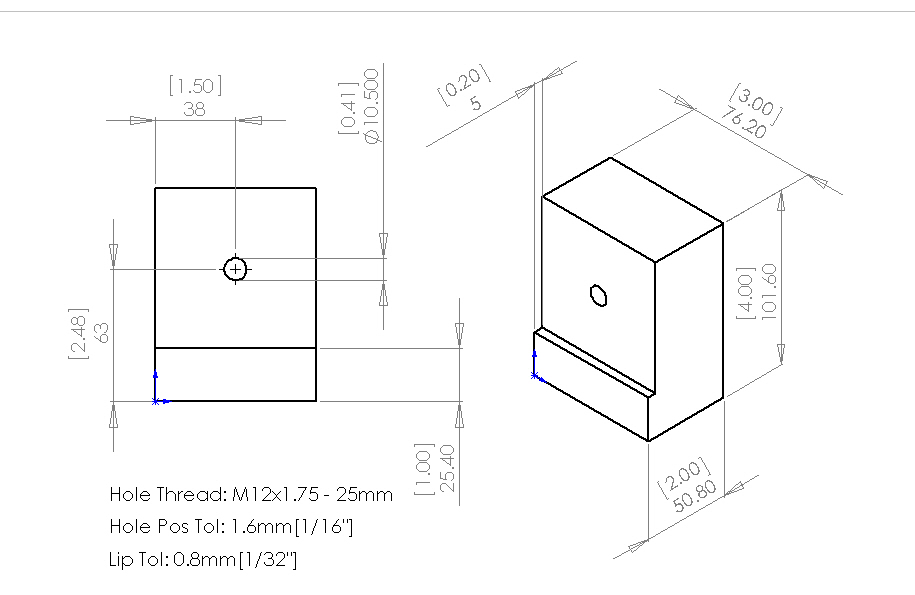
components/33/ClampBlockFab.JPG
