h4ck3rm1k3/Cold-Saw/components/33/finished.jpg

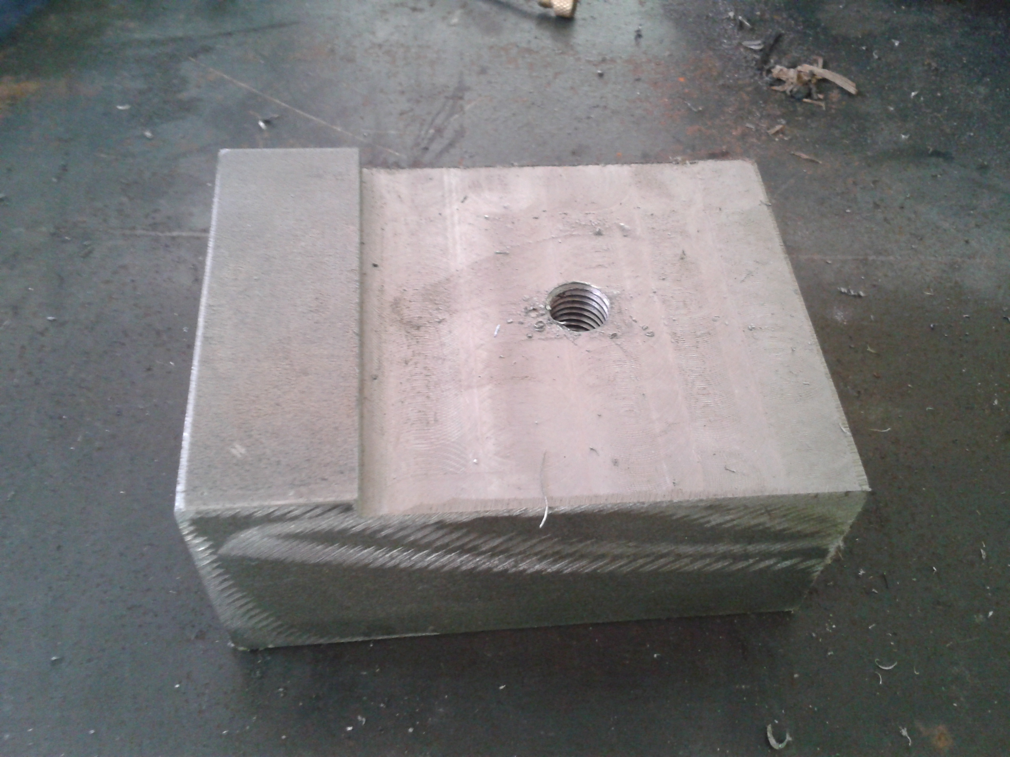
components/33/finished.jpg
