h4ck3rm1k3/Cold-Saw/components/34/2-23drilled.jpg

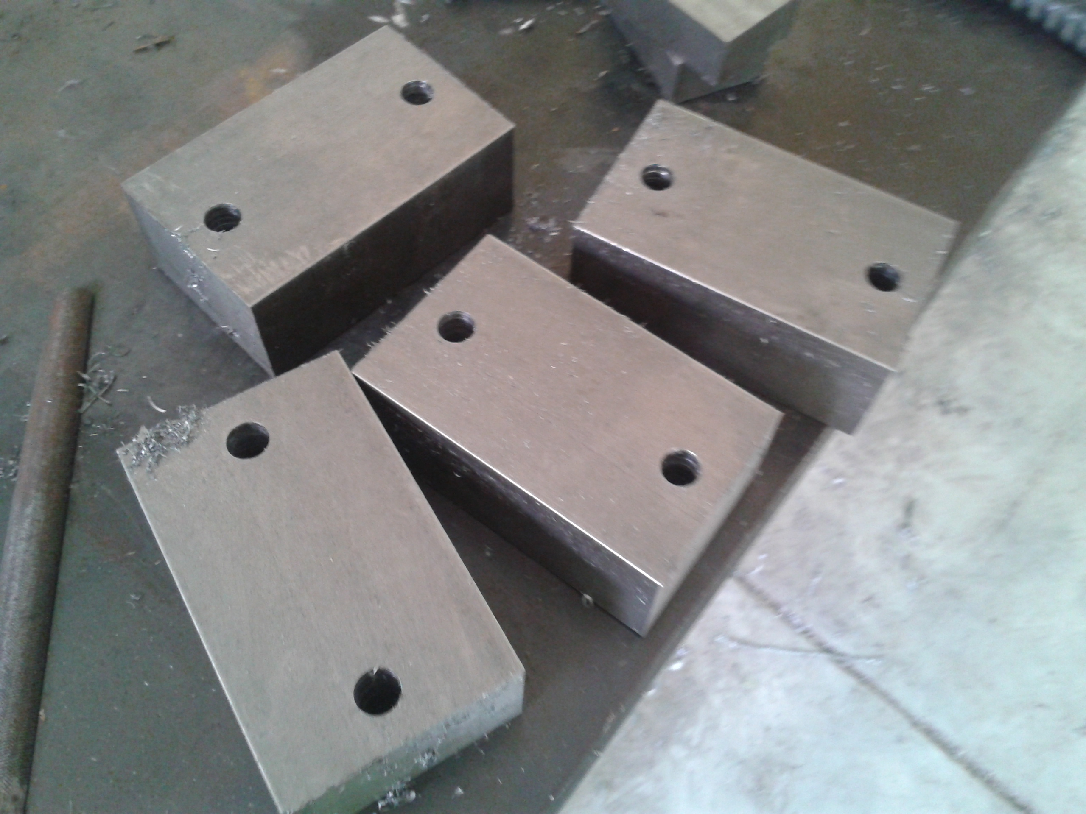
components/34/2-23drilled.jpg
