h4ck3rm1k3/Cold-Saw/components/34/ClampJawD.JPG

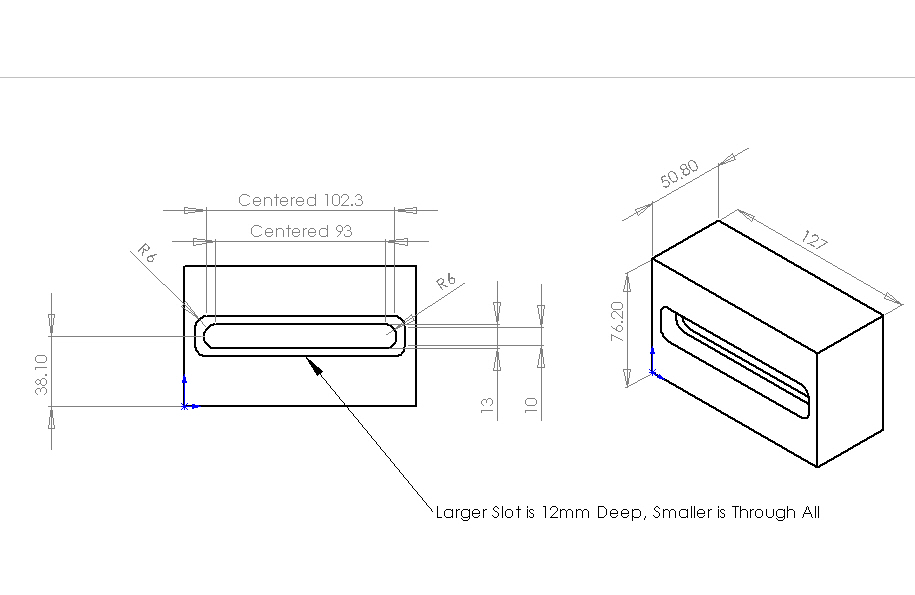
components/34/ClampJawD.JPG
