h4ck3rm1k3/Cold-Saw/components/35/ShaftBlock2Fab.JPG

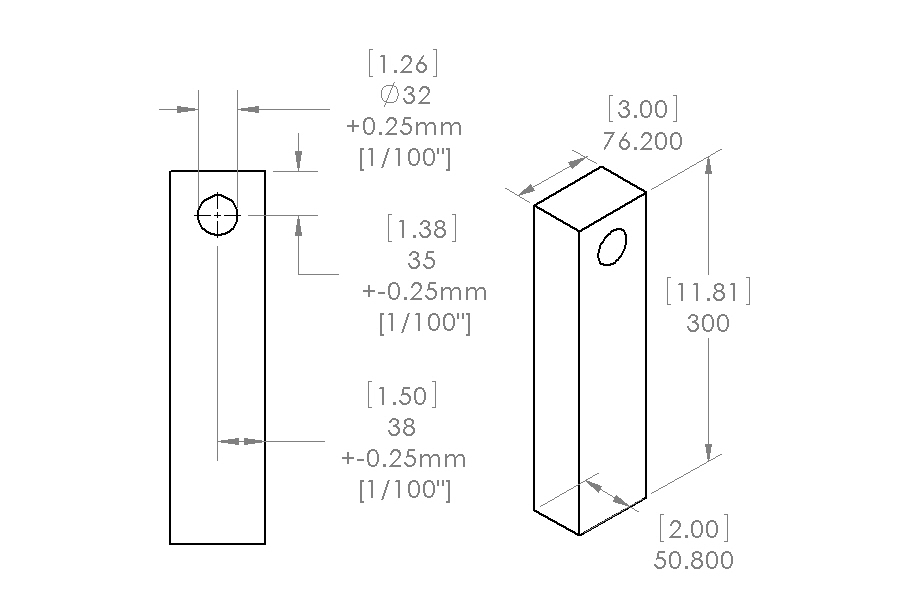
components/35/ShaftBlock2Fab.JPG
