h4ck3rm1k3/Cold-Saw/components/36/36model.JPG

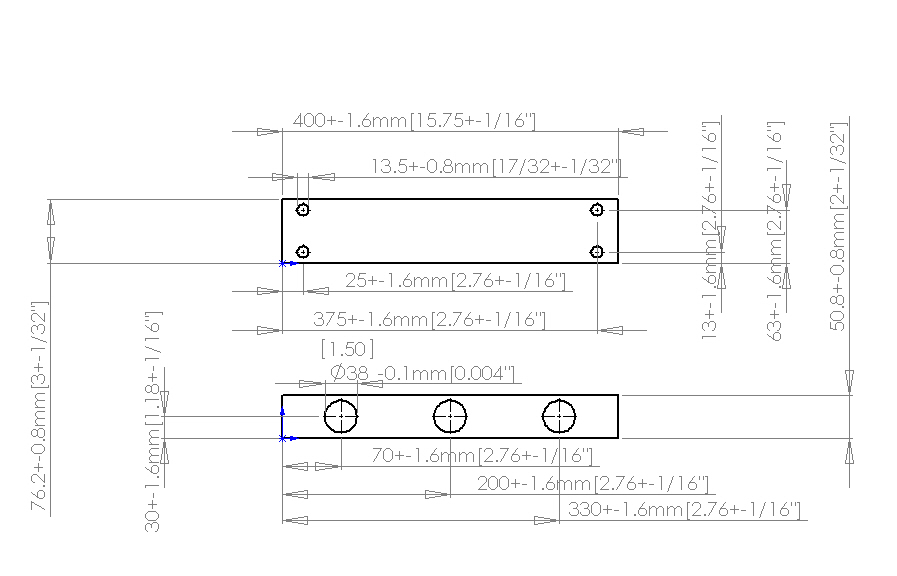
components/36/36model.JPG
