h4ck3rm1k3/Cold-Saw/components/36/fabpics/HammerinShafts.jpg

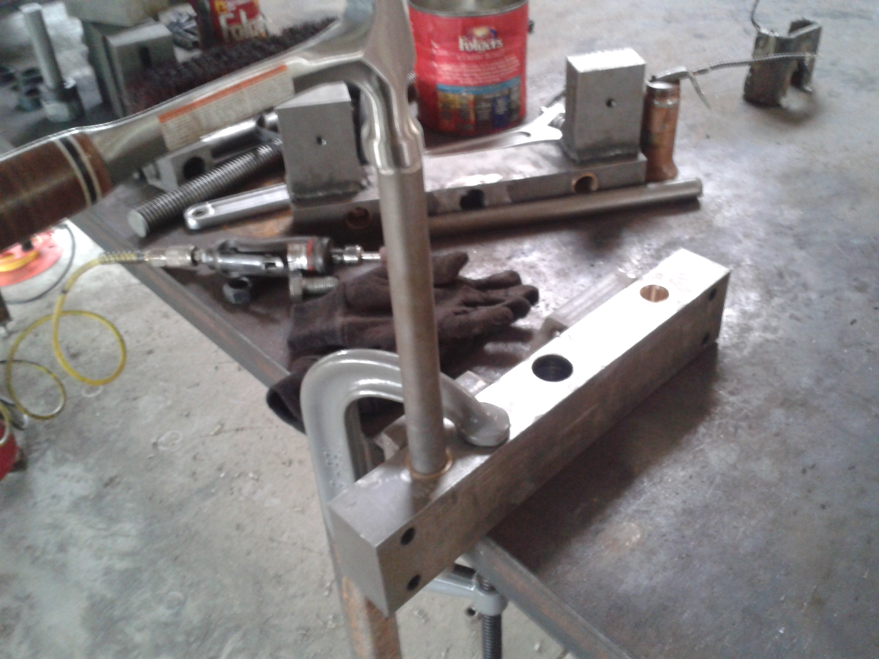
components/36/fabpics/HammerinShafts.jpg
