h4ck3rm1k3/Cold-Saw/components/36/fabpics/UnbeveledShaftEnds.jpg

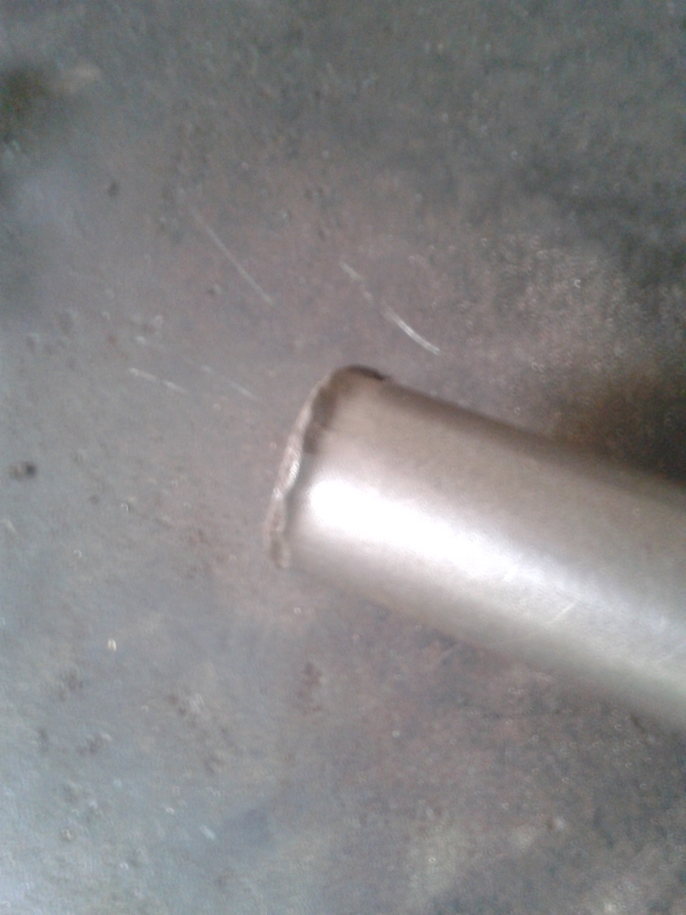
components/36/fabpics/UnbeveledShaftEnds.jpg
