h4ck3rm1k3/Cold-Saw/components/36/FixedBlockD.JPG

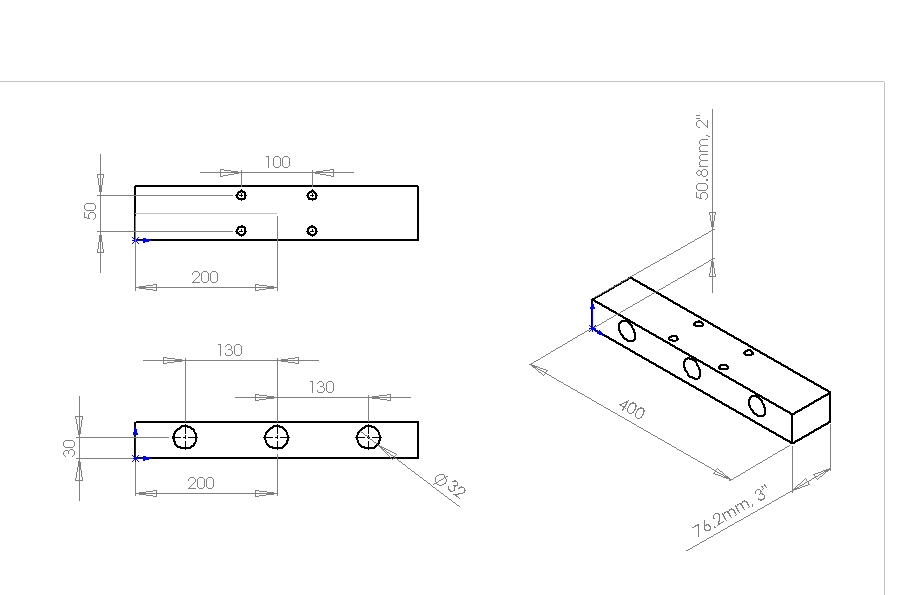
components/36/FixedBlockD.JPG
