h4ck3rm1k3/Cold-Saw/components/37/MovingBlock.JPG

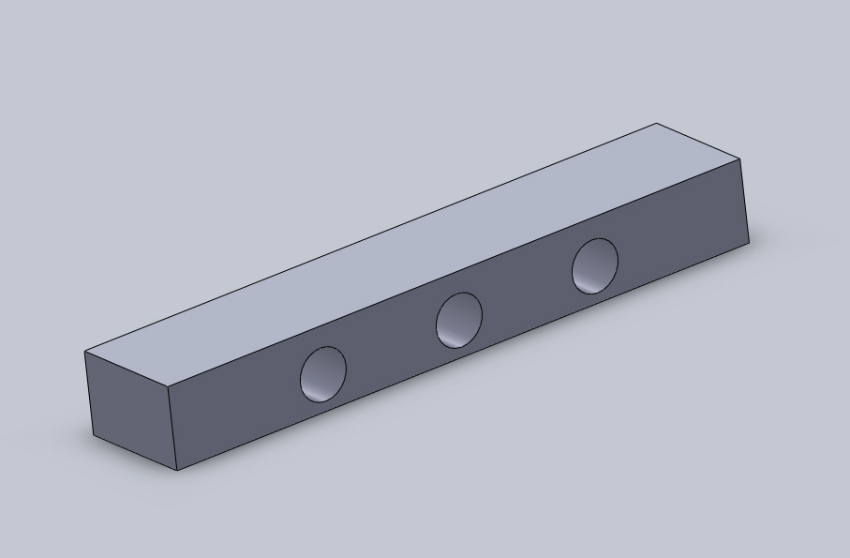
components/37/MovingBlock.JPG
