h4ck3rm1k3/Cold-Saw/components/37/MovingBlockD.JPG

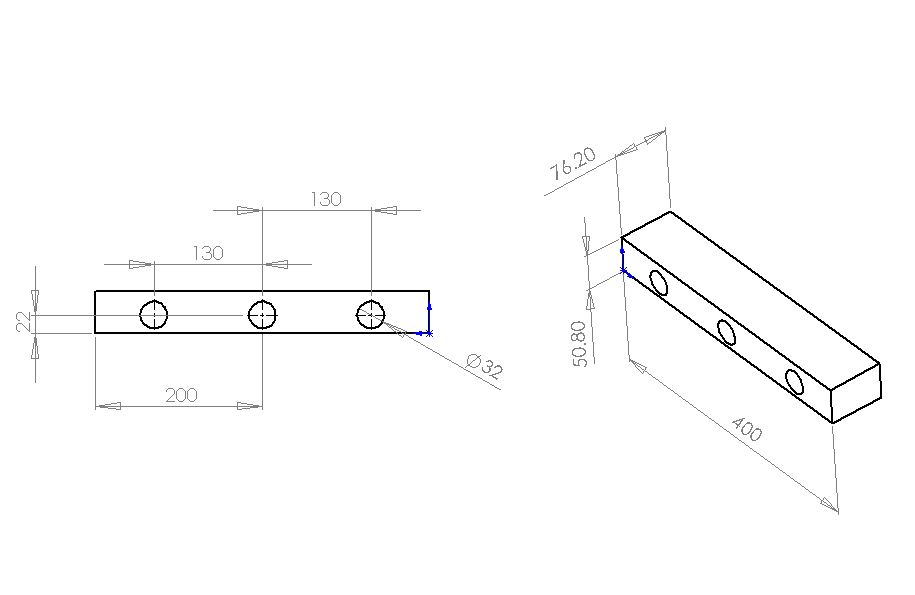
components/37/MovingBlockD.JPG
