h4ck3rm1k3/Cold-Saw/components/37/MovingBlockFab.JPG

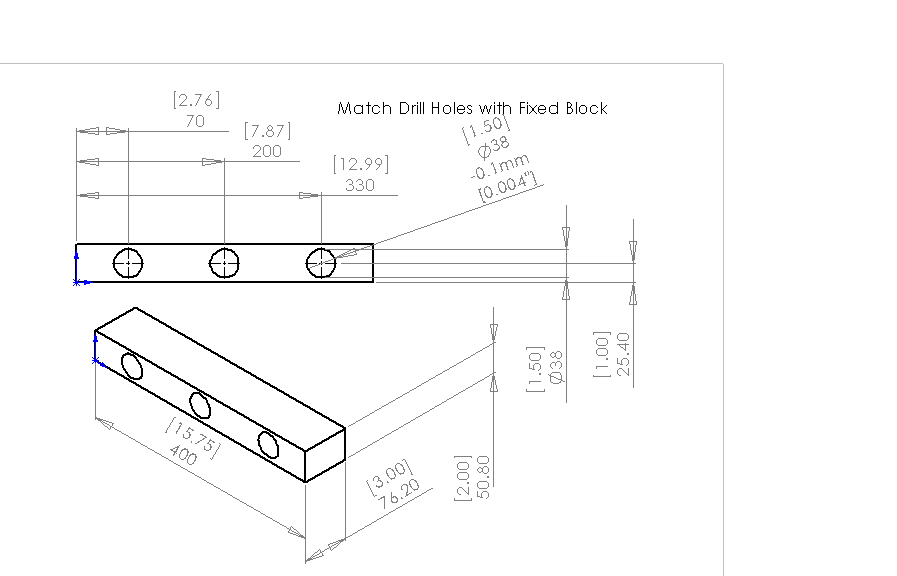
components/37/MovingBlockFab.JPG
