h4ck3rm1k3/Cold-Saw/components/38/StopFlatFab.JPG

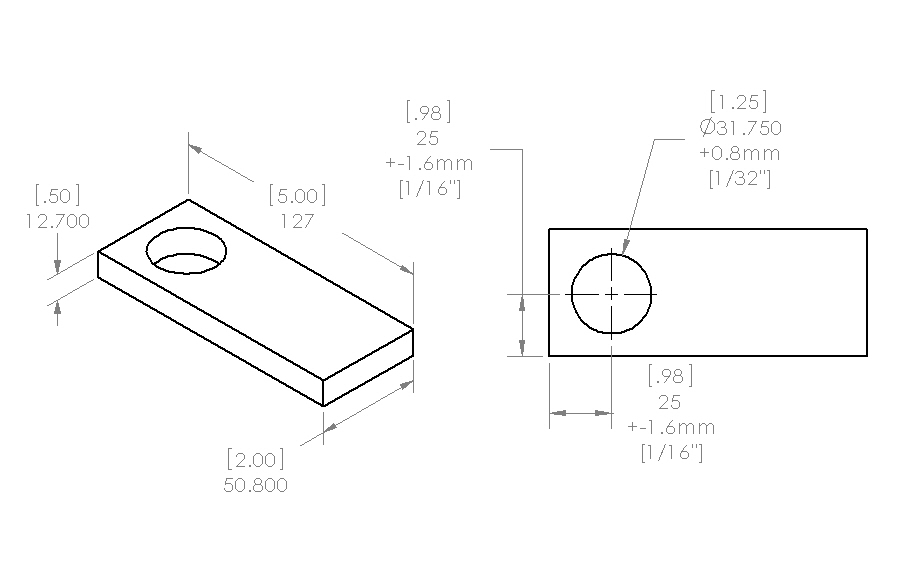
components/38/StopFlatFab.JPG
