h4ck3rm1k3/Cold-Saw/components/41/2-28finished.jpg

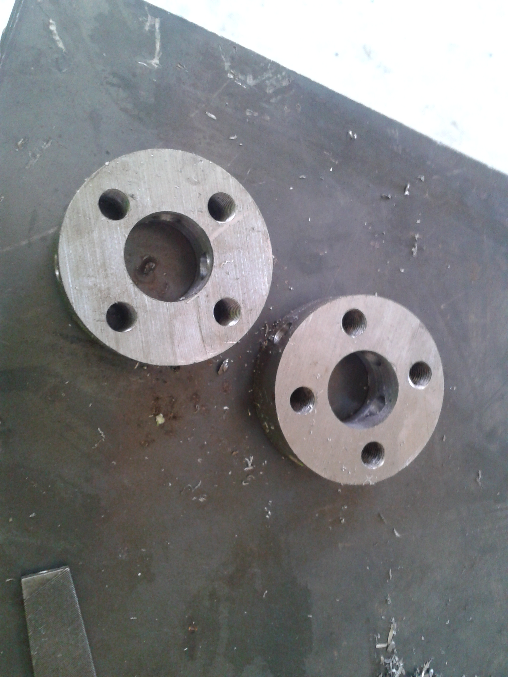
components/41/2-28finished.jpg
