h4ck3rm1k3/Cold-Saw/components/41/DriveCollar.JPG

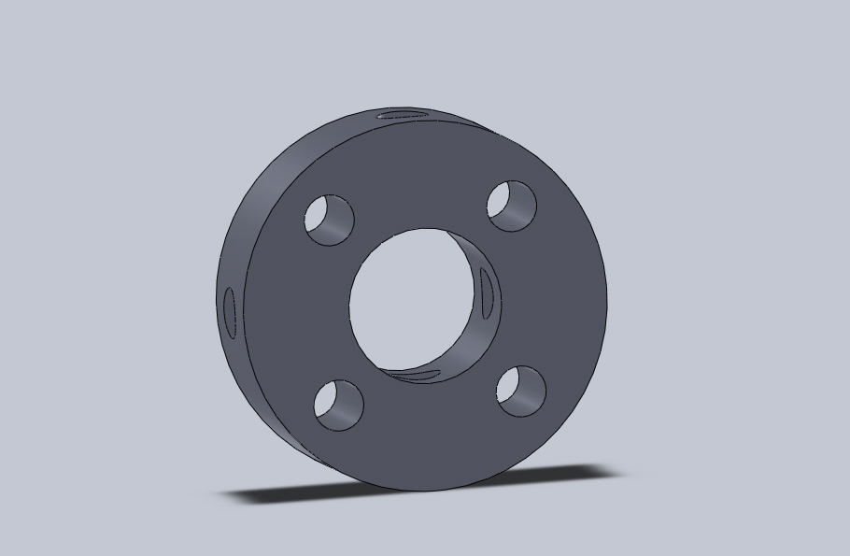
components/41/DriveCollar.JPG
