h4ck3rm1k3/Cold-Saw/components/41/DriveCollarD.JPG

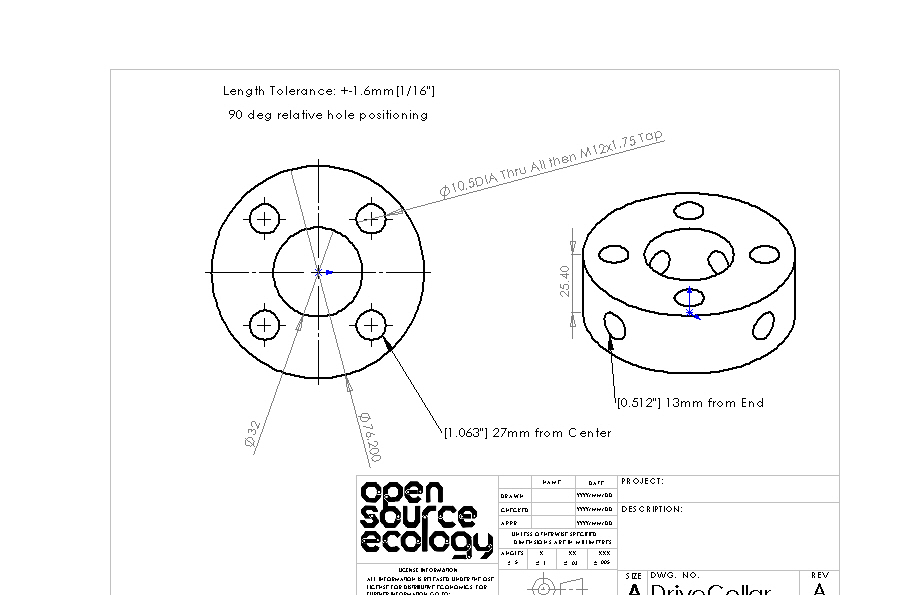
components/41/DriveCollarD.JPG
