h4ck3rm1k3/Cold-Saw/components/42/MountDisc.JPG

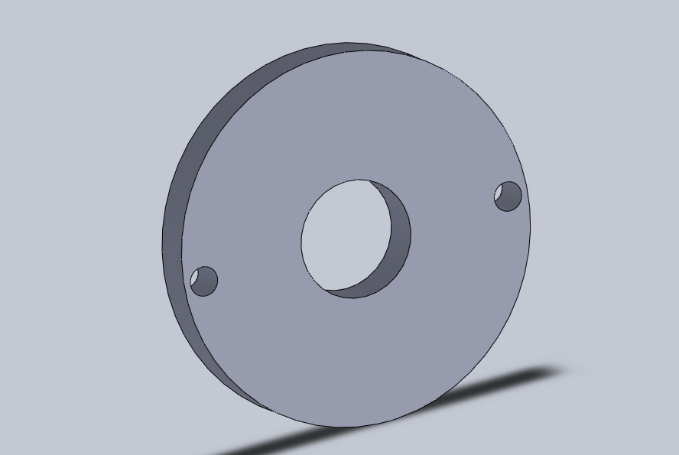
components/42/MountDisc.JPG
