h4ck3rm1k3/Cold-Saw/components/43/ShaftCoupling.JPG

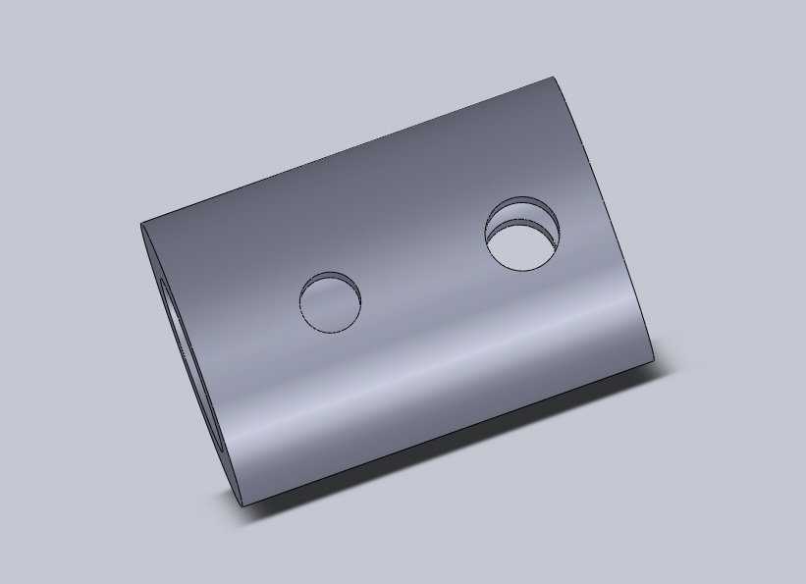
components/43/ShaftCoupling.JPG
