h4ck3rm1k3/Cold-Saw/components/44/MediumShaftCollarD.JPG

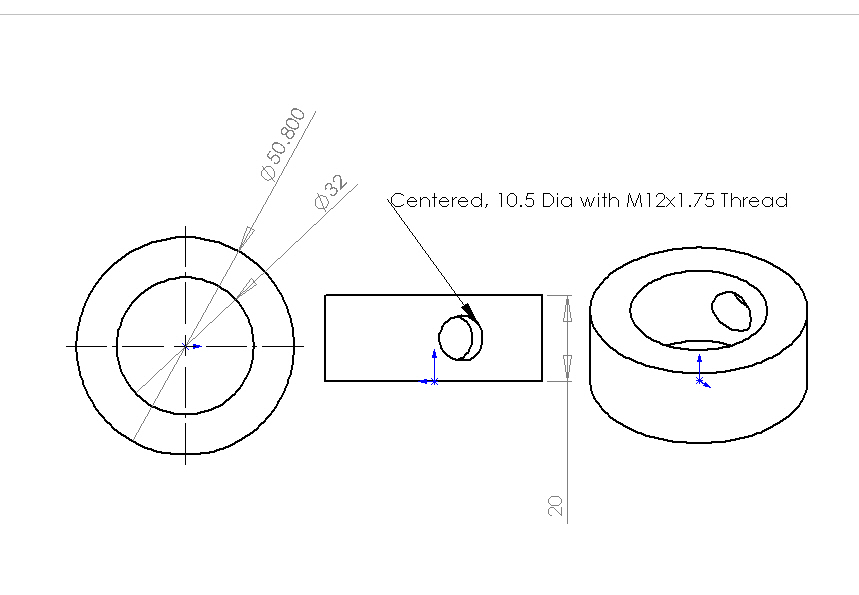
components/44/MediumShaftCollarD.JPG
