h4ck3rm1k3/Cold-Saw/components/45/SupportShaft.JPG

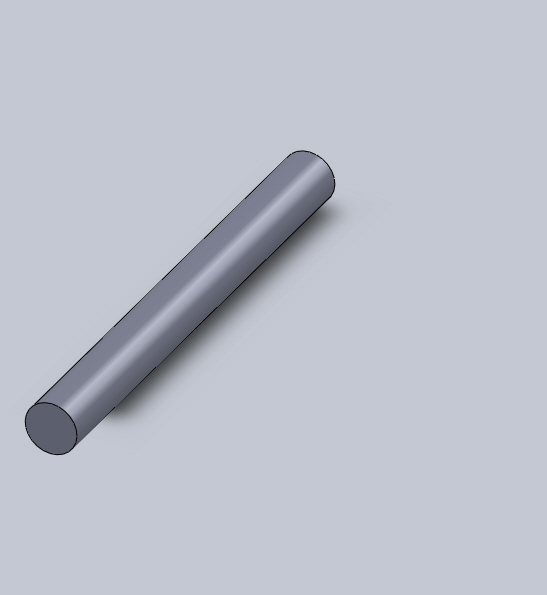
components/45/SupportShaft.JPG
