h4ck3rm1k3/Cold-Saw/components/46/Spindle.JPG

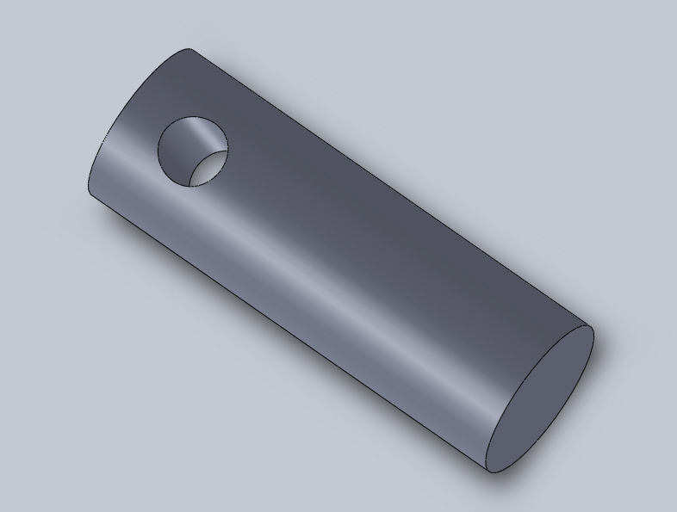
components/46/Spindle.JPG
