h4ck3rm1k3/Cold-Saw/components/46/SpindleD.JPG

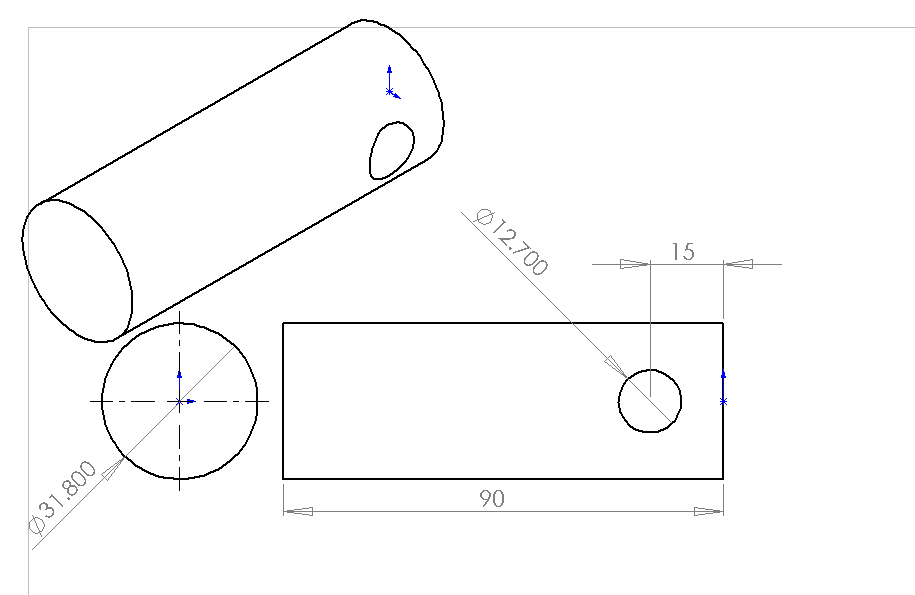
components/46/SpindleD.JPG
