h4ck3rm1k3/Cold-Saw/components/47/StopShaft.JPG

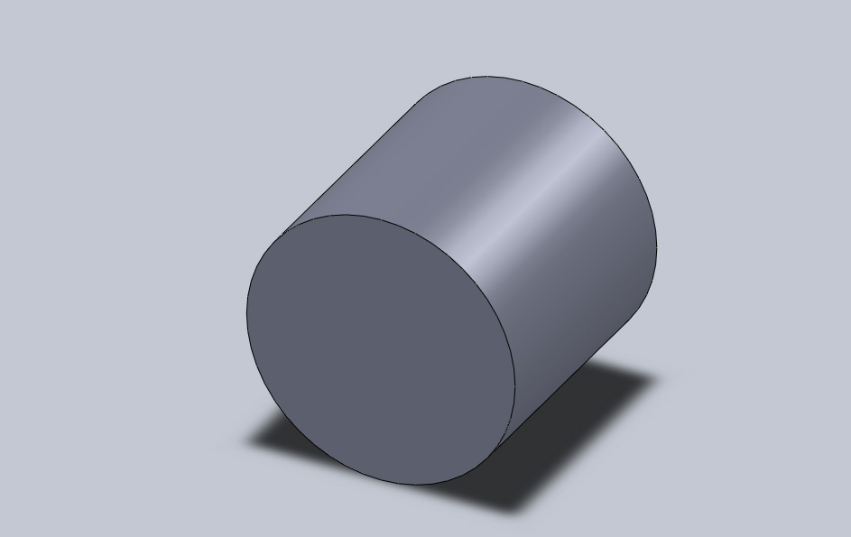
components/47/StopShaft.JPG
