h4ck3rm1k3/Cold-Saw/components/47/StopShaftD.JPG

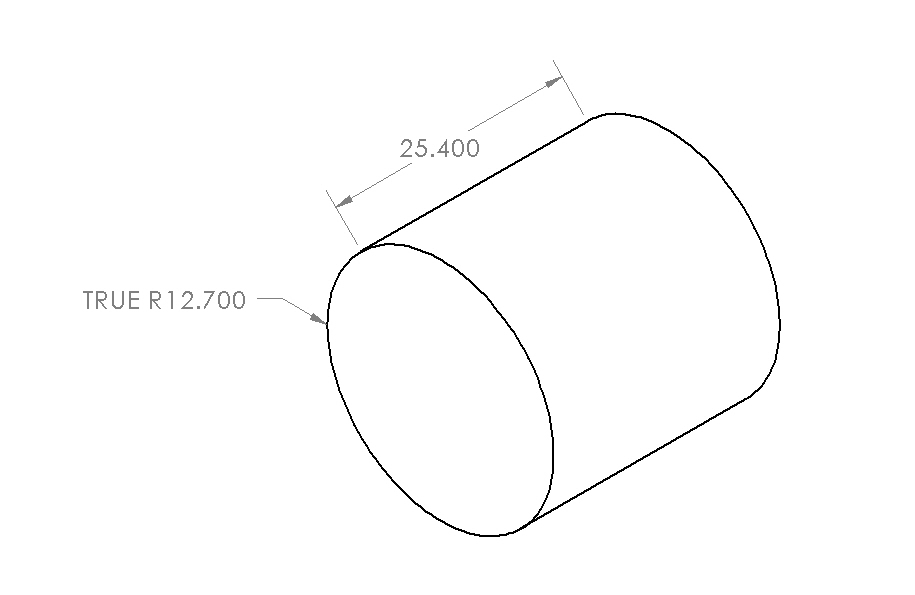
components/47/StopShaftD.JPG
