h4ck3rm1k3/Cold-Saw/components/48/48model.JPG

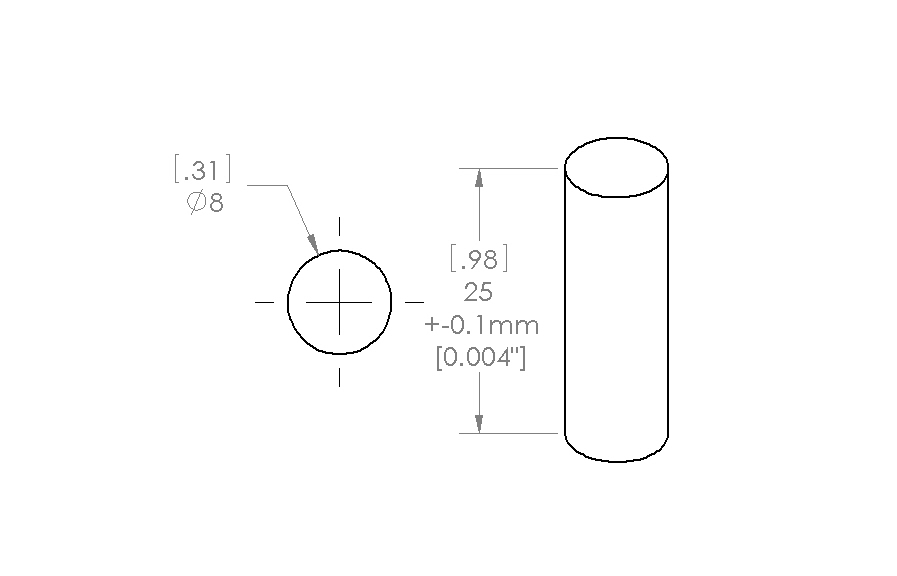
components/48/48model.JPG
