h4ck3rm1k3/Cold-Saw/components/49/49model.JPG

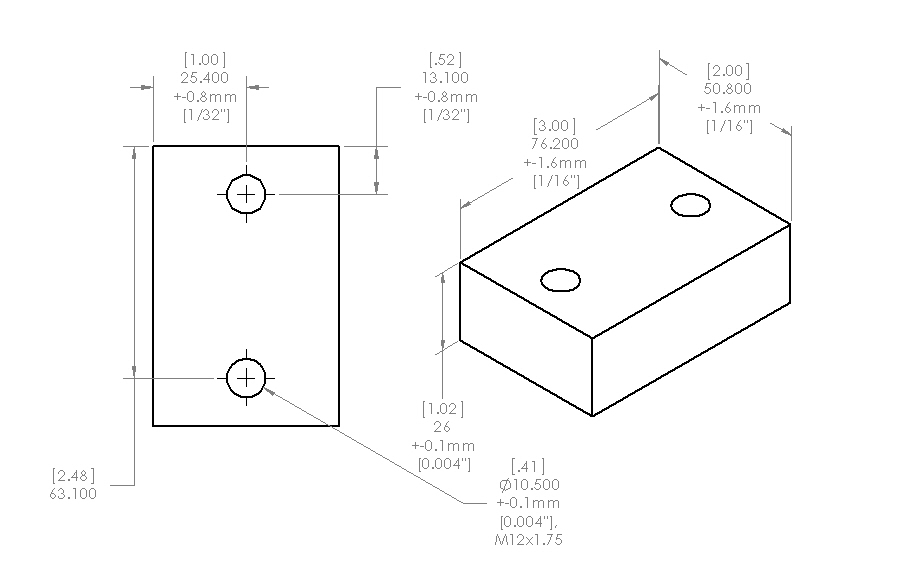
components/49/49model.JPG
