h4ck3rm1k3/Cold-Saw/components/51/51model.JPG

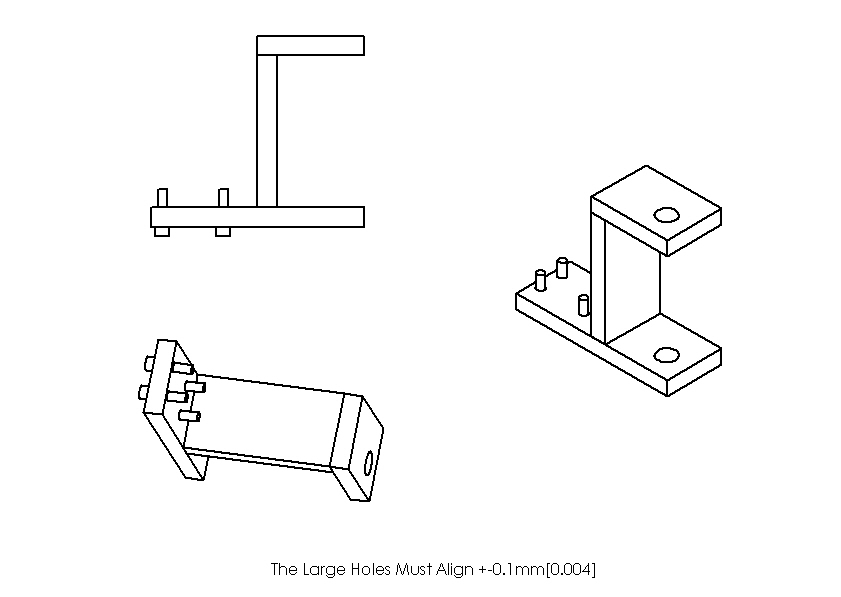
components/51/51model.JPG
