h4ck3rm1k3/Cold-Saw/components/51/weldposition1.jpg

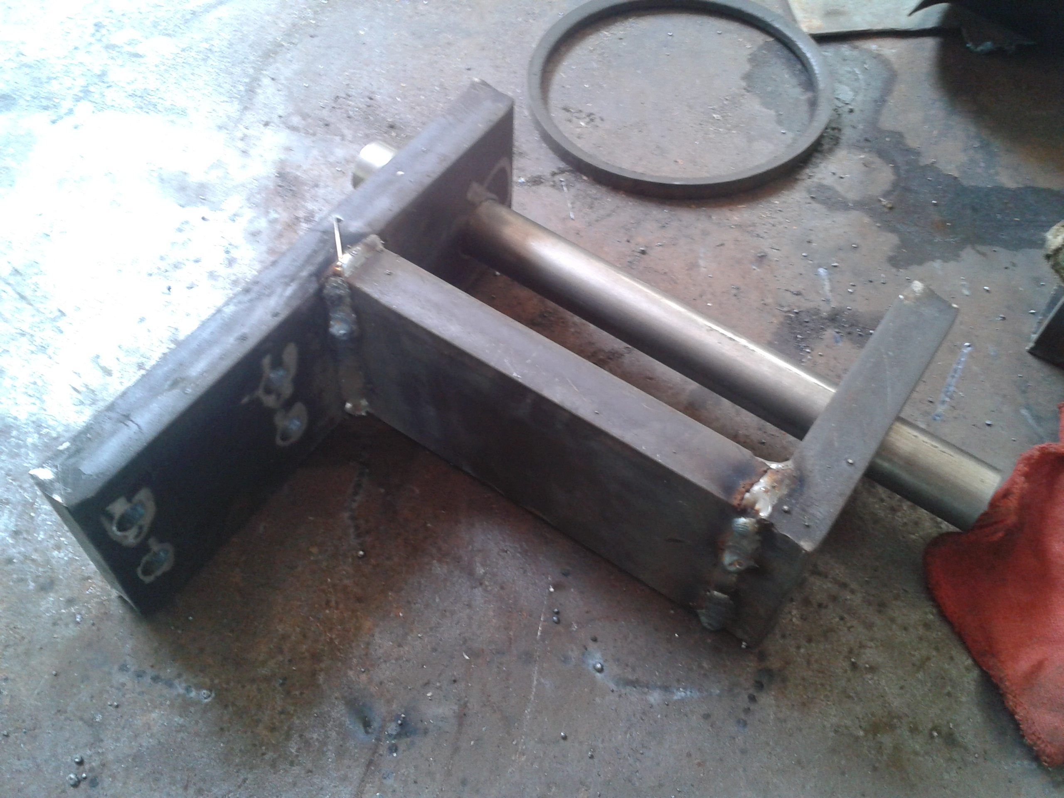
components/51/weldposition1.jpg
