h4ck3rm1k3/Cold-Saw/components/53/53model.JPG

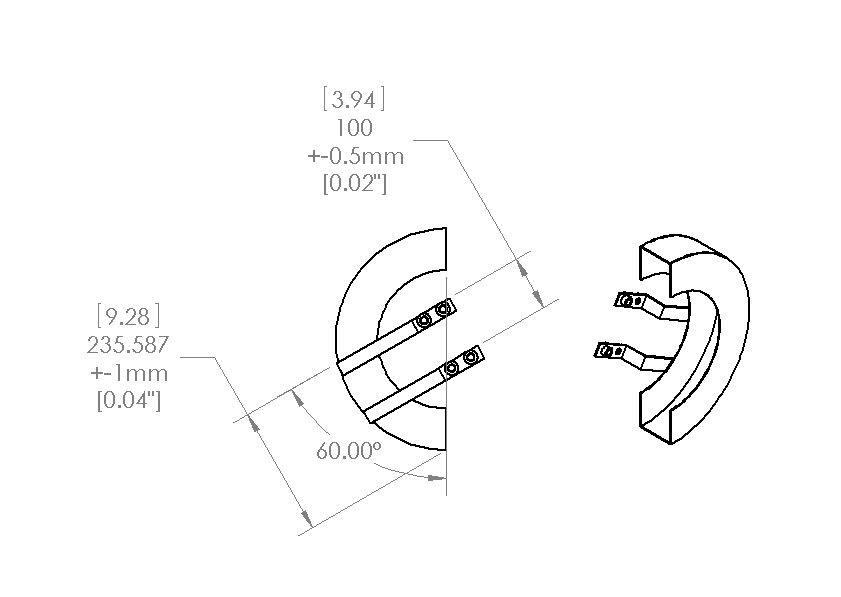
components/53/53model.JPG
