h4ck3rm1k3/Cold-Saw/components/54/54model.JPG

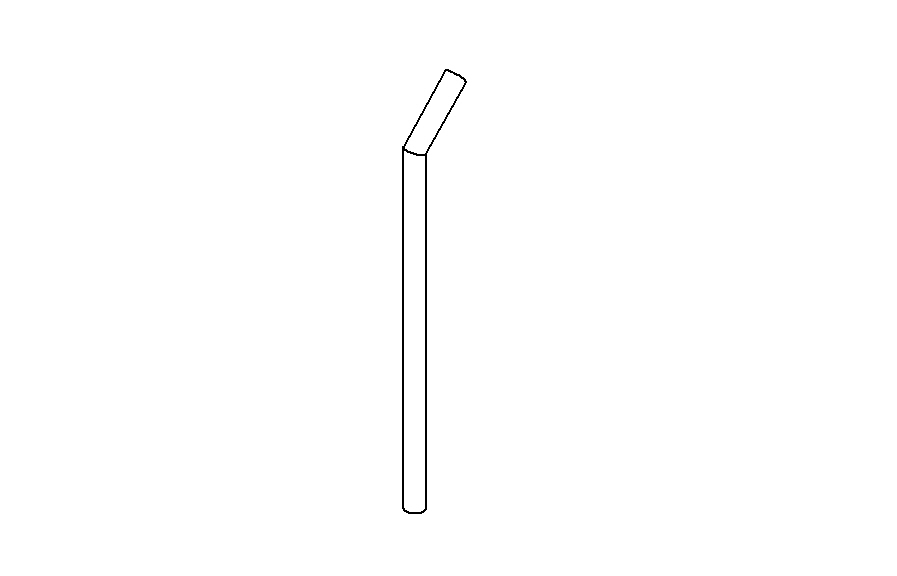
components/54/54model.JPG
