h4ck3rm1k3/Cold-Saw/components/55/55model.JPG

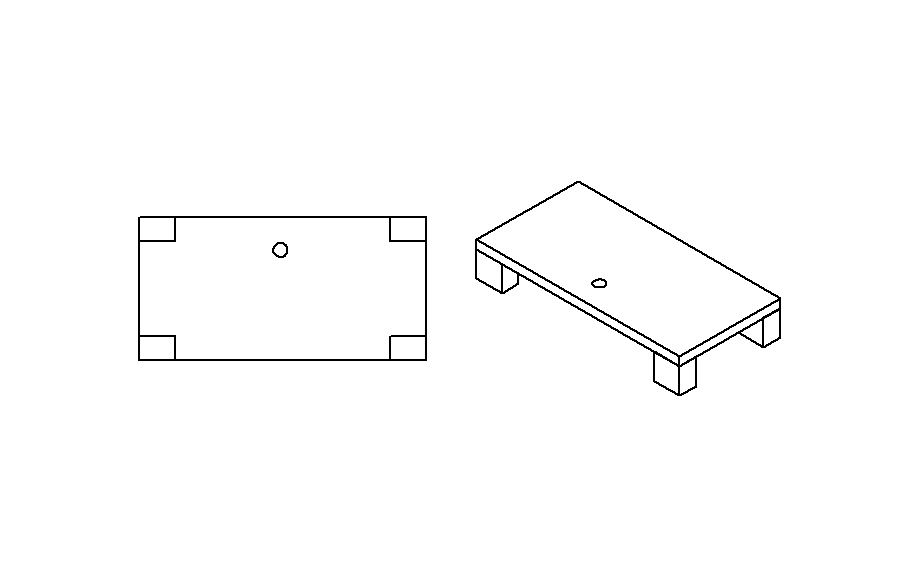
components/55/55model.JPG
