h4ck3rm1k3/Cold-Saw/components/55/weldposition.jpg

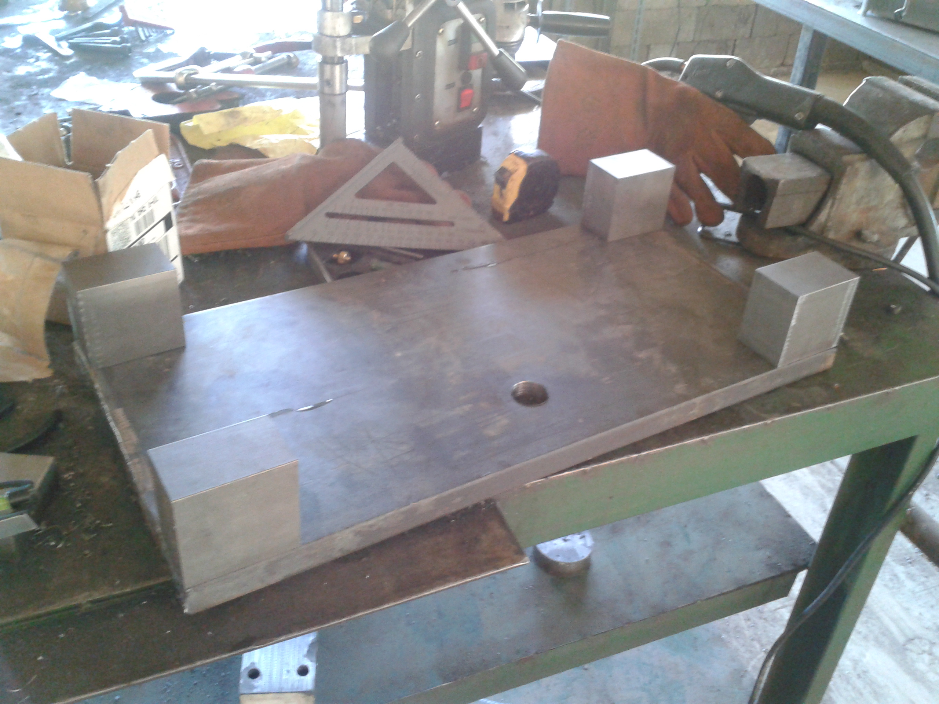
components/55/weldposition.jpg
