h4ck3rm1k3/Cold-Saw/components/58/LongScrew.JPG

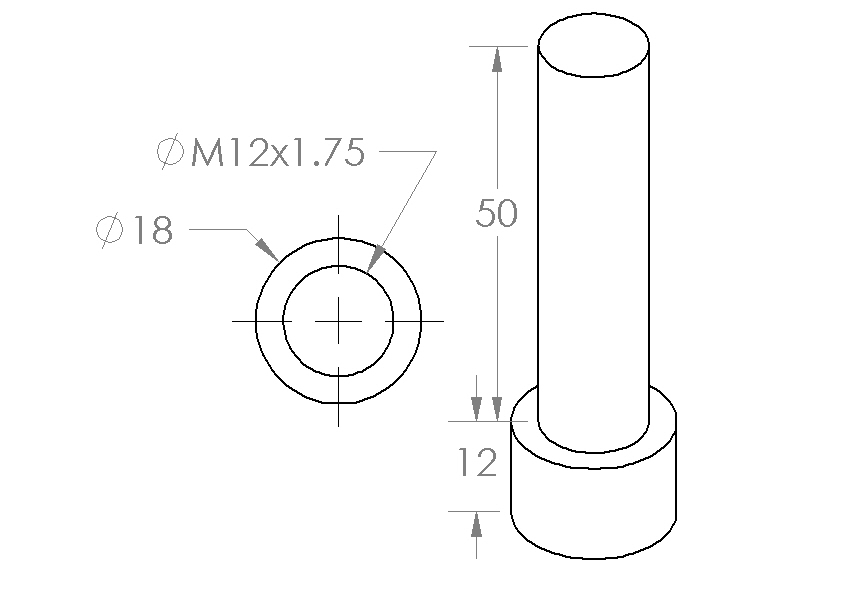
components/58/LongScrew.JPG
