h4ck3rm1k3/Cold-Saw/components/58/LongScrewD.JPG

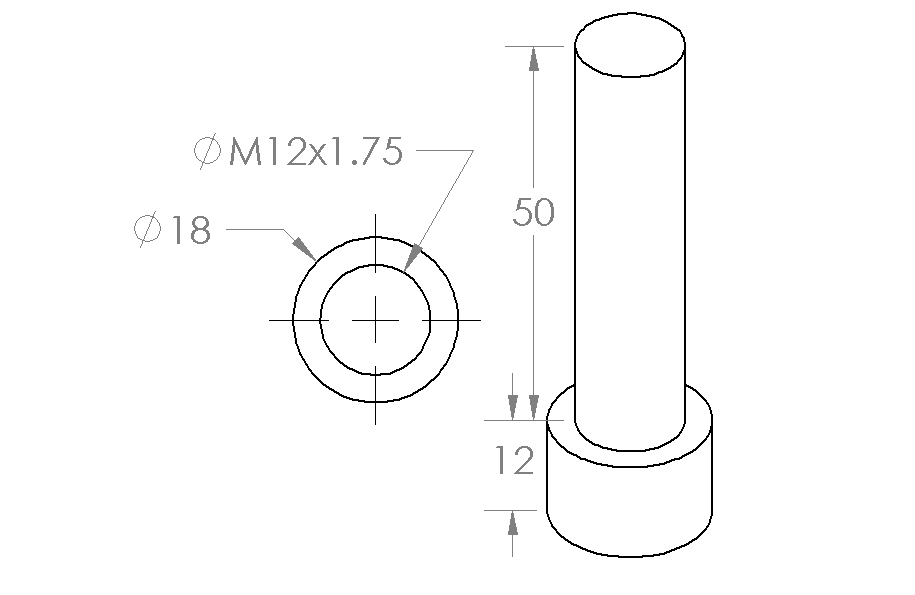
components/58/LongScrewD.JPG
