h4ck3rm1k3/Cold-Saw/components/59/Long2Screw.JPG

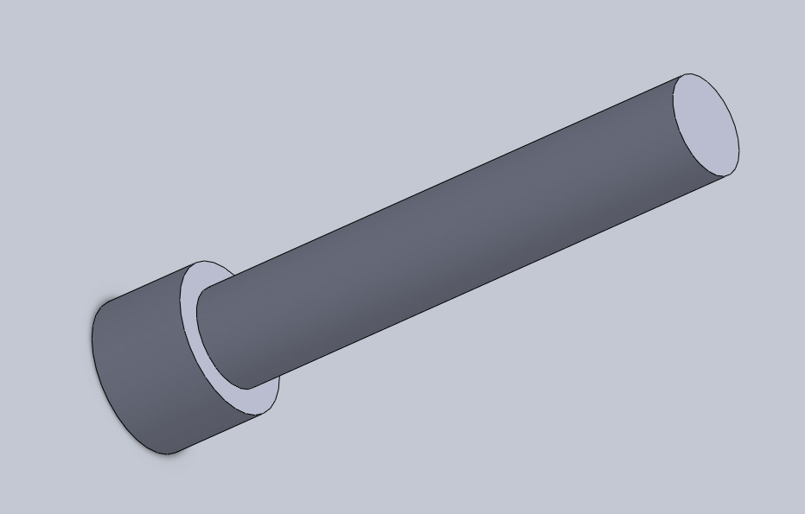
components/59/Long2Screw.JPG
