h4ck3rm1k3/Cold-Saw/components/61/LargeNut.JPG

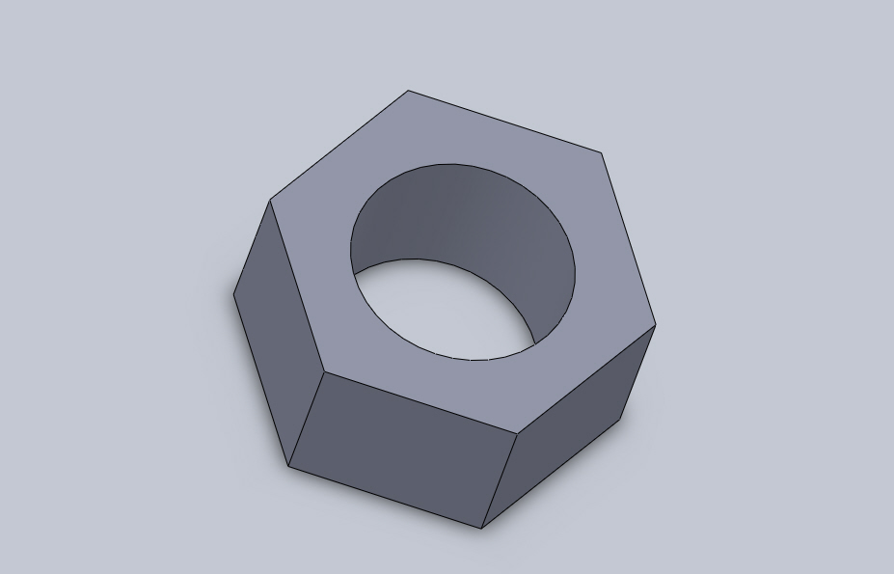
components/61/LargeNut.JPG
