h4ck3rm1k3/Cold-Saw/components/61/LargeNutD.JPG

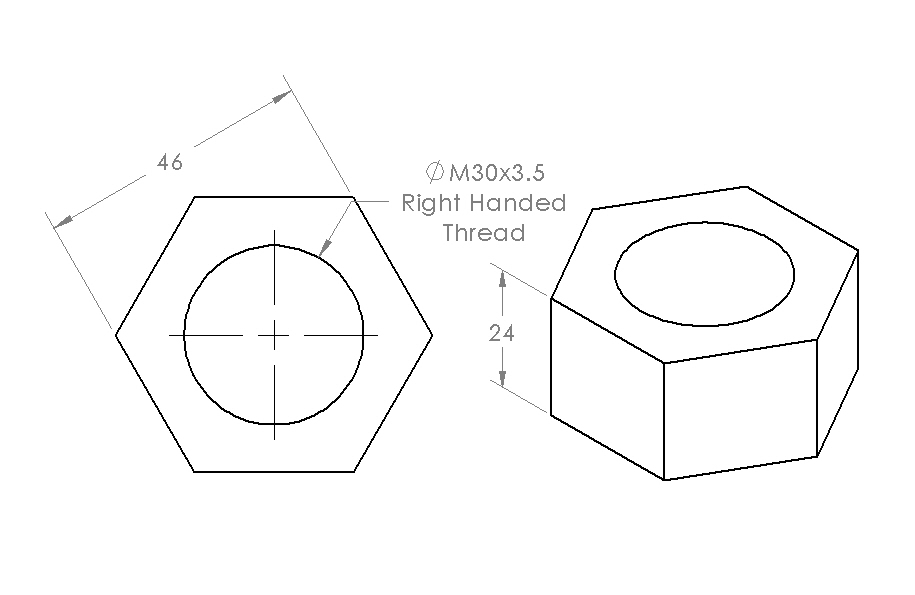
components/61/LargeNutD.JPG
