h4ck3rm1k3/Cold-Saw/components/62/LargeLHNutD.JPG

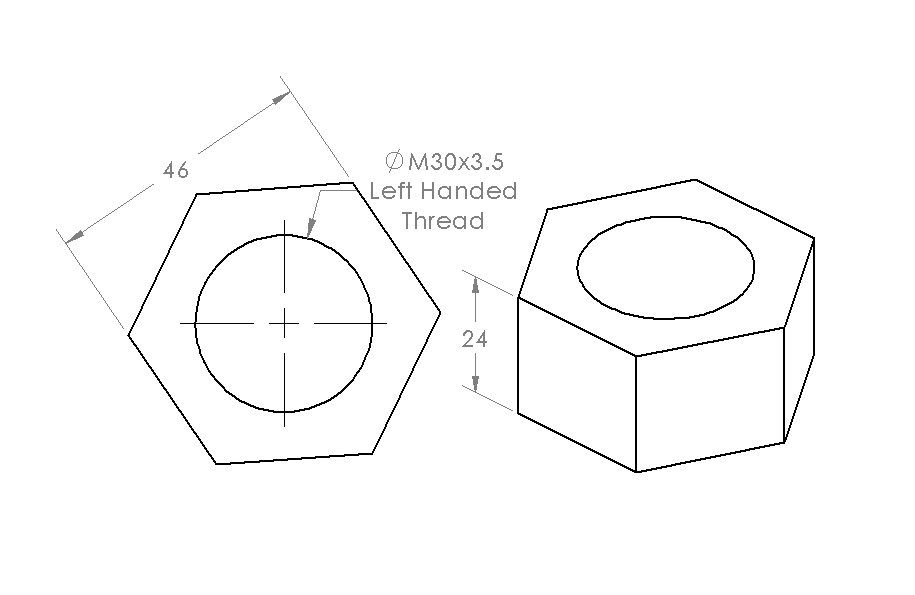
components/62/LargeLHNutD.JPG
