h4ck3rm1k3/Cold-Saw/components/67/67model.JPG

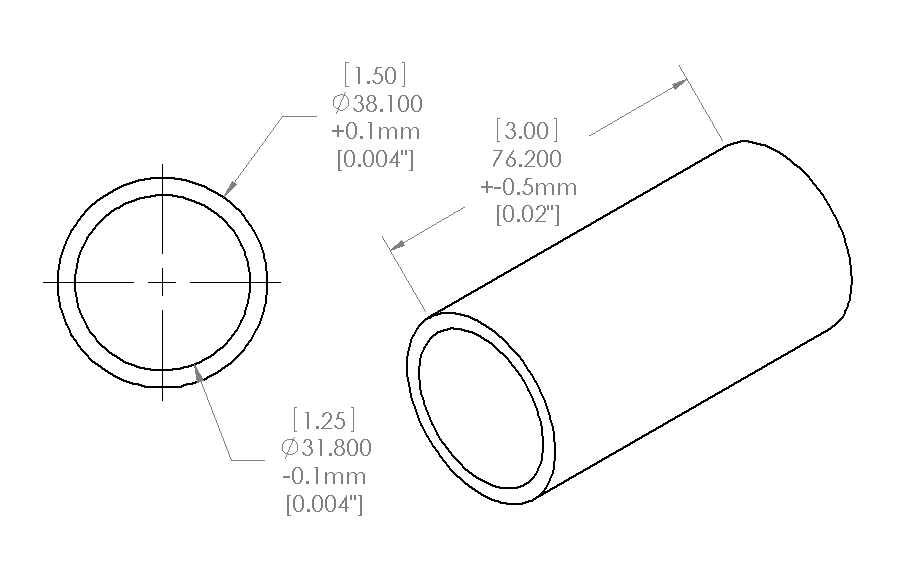
components/67/67model.JPG
