h4ck3rm1k3/Cold-Saw/components/68/68model.JPG

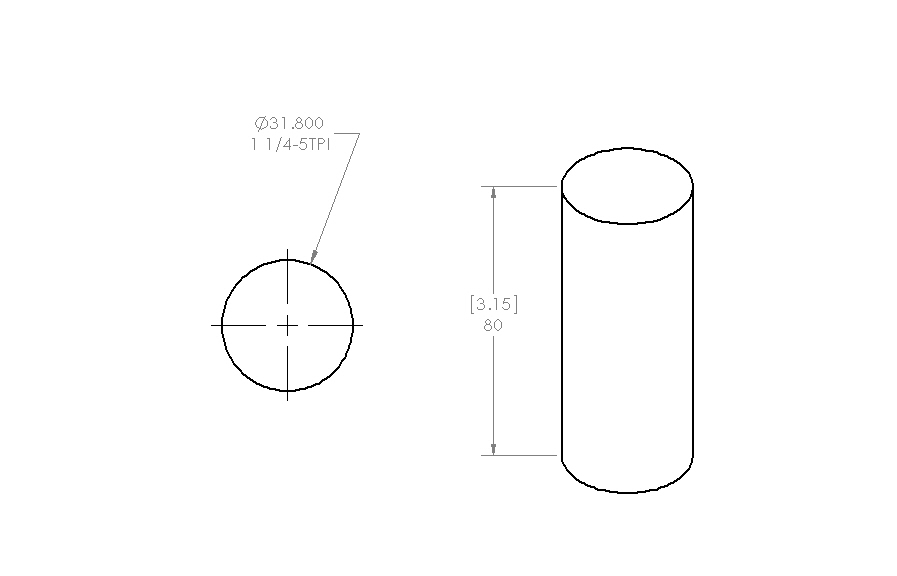
components/68/68model.JPG
