h4ck3rm1k3/Cold-Saw/components/69/69model.JPG

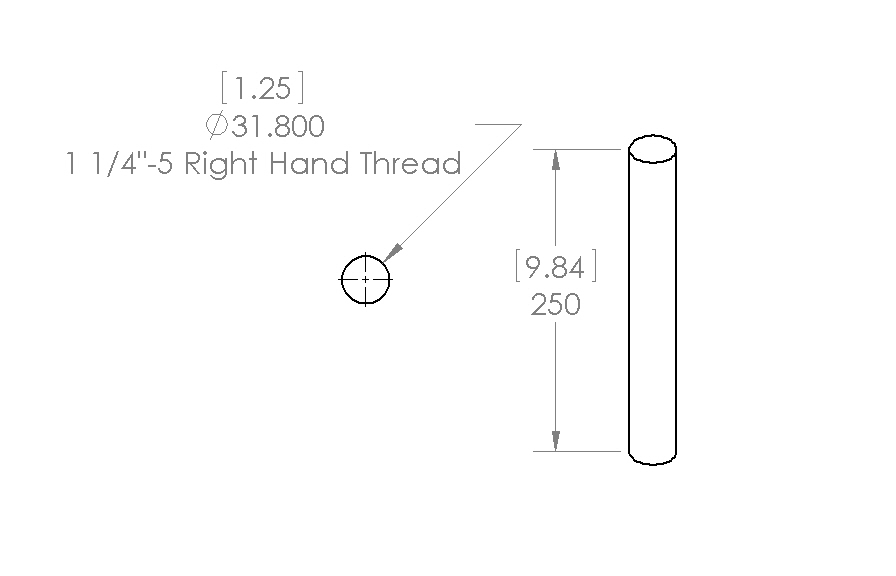
components/69/69model.JPG
