h4ck3rm1k3/Cold-Saw/components/70/70model.JPG

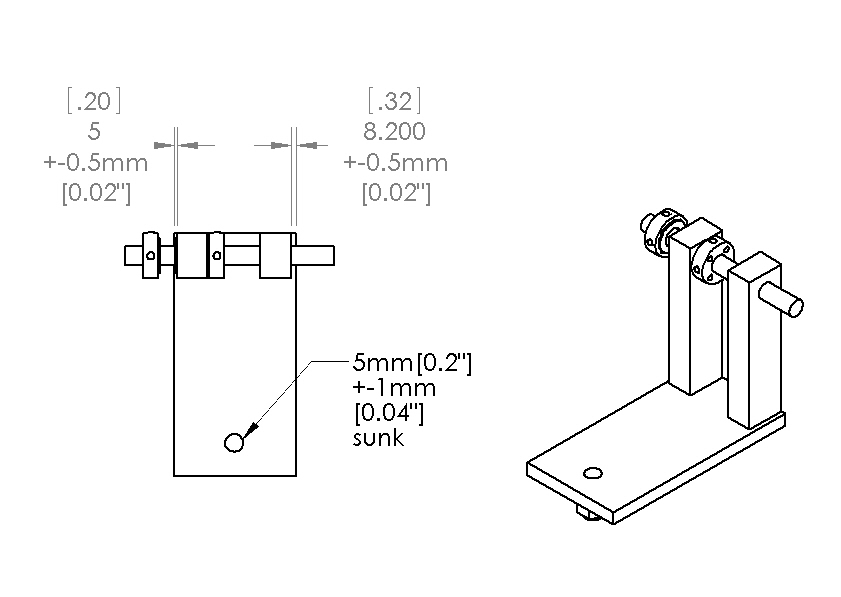
components/70/70model.JPG
