h4ck3rm1k3/Cold-Saw/components/74/74model.JPG

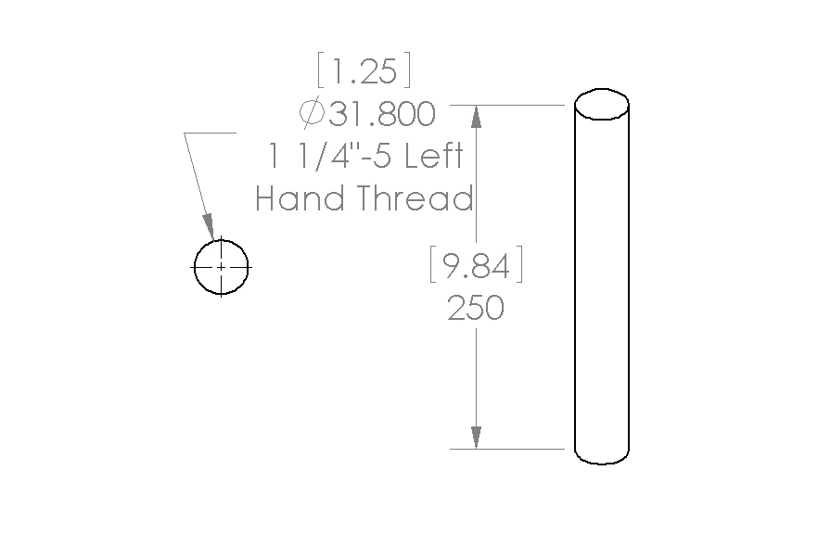
components/74/74model.JPG
