h4ck3rm1k3/Cold-Saw/components/75/75model.JPG

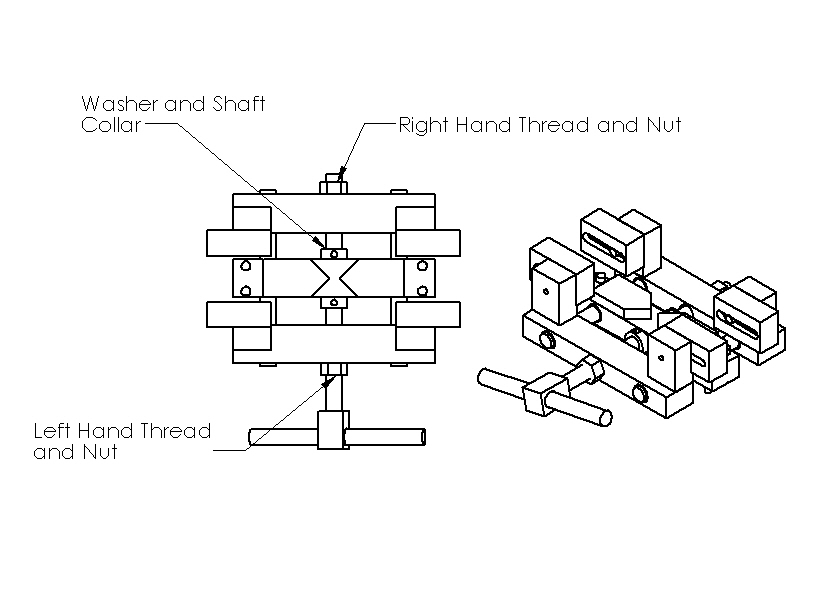
components/75/75model.JPG
