h4ck3rm1k3/Cold-Saw/components/77/77model.JPG

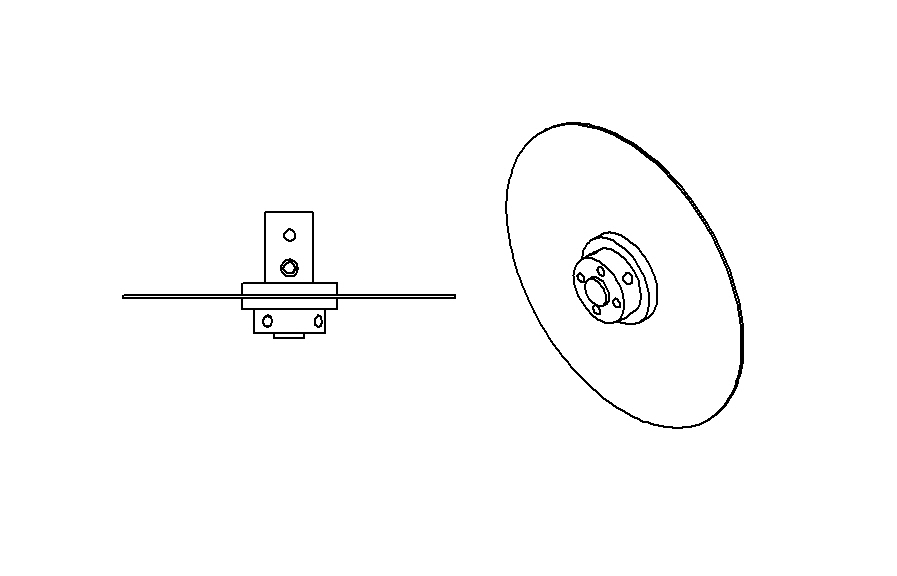
components/77/77model.JPG
