h4ck3rm1k3/Cold-Saw/components/78/78model.JPG

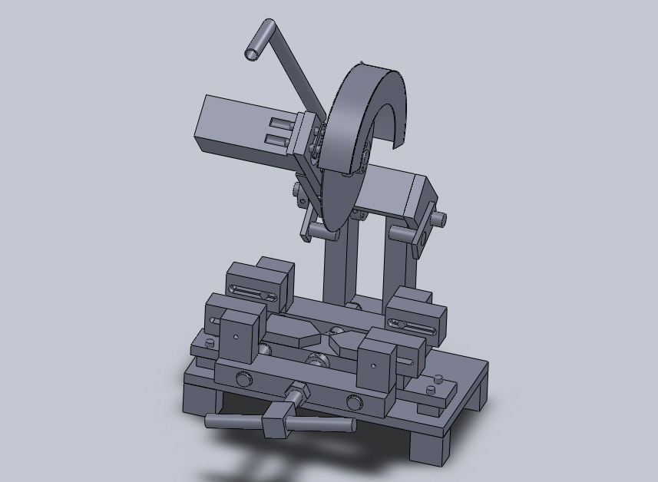
components/78/78model.JPG
