h4ck3rm1k3/Cold-Saw/components/79/submersible pump.jpg

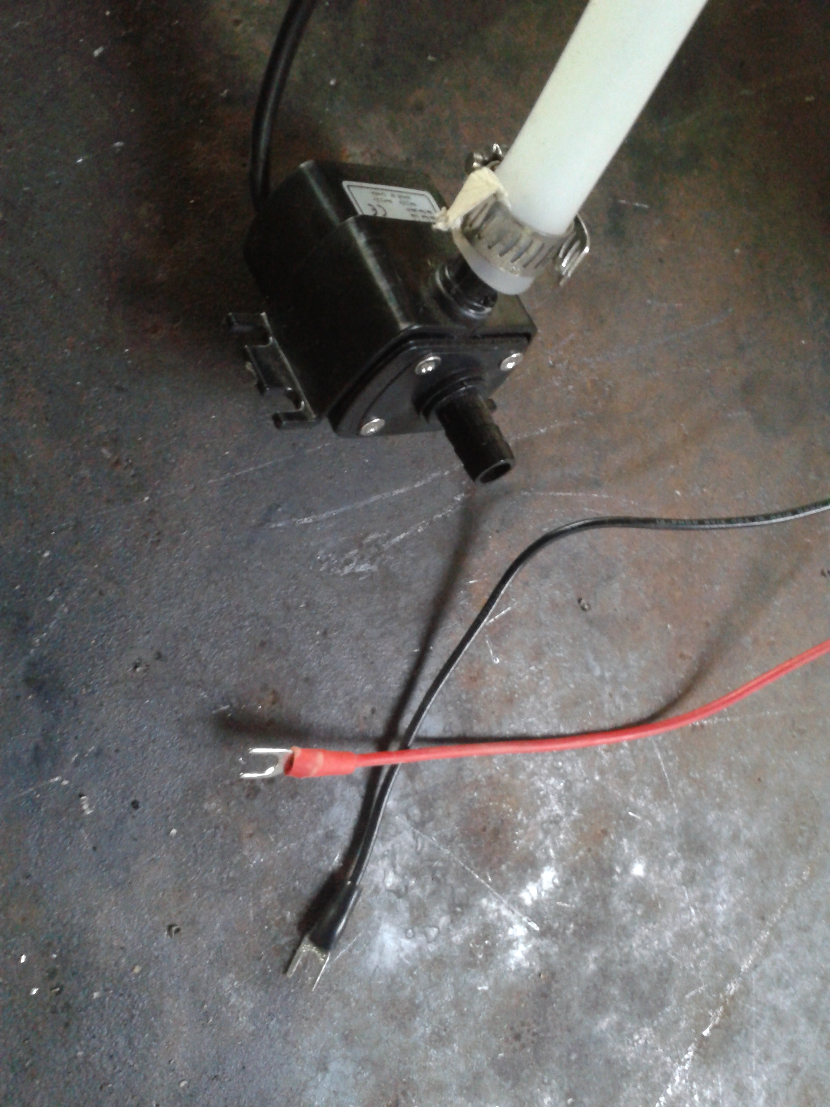
components/79/submersible pump.jpg
