h4ck3rm1k3/Cold-Saw/components/80/80model.JPG

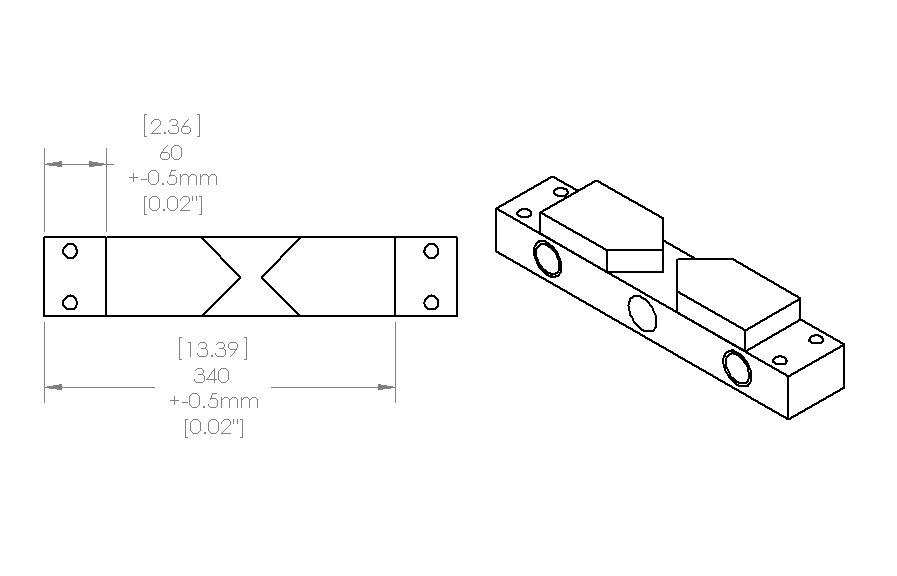
components/80/80model.JPG
