h4ck3rm1k3/Cold-Saw/components/81/81model.JPG

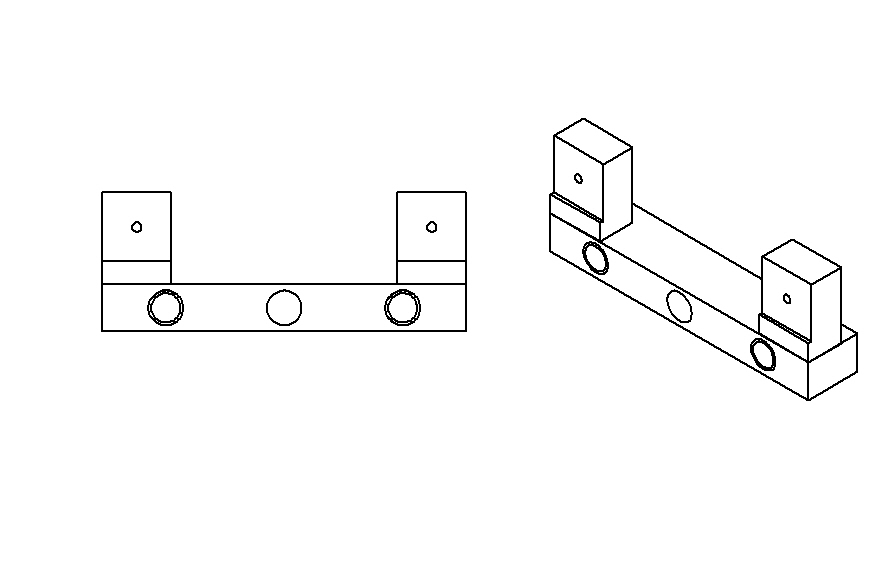
components/81/81model.JPG
