h4ck3rm1k3/Cold-Saw/components/84/84model.JPG

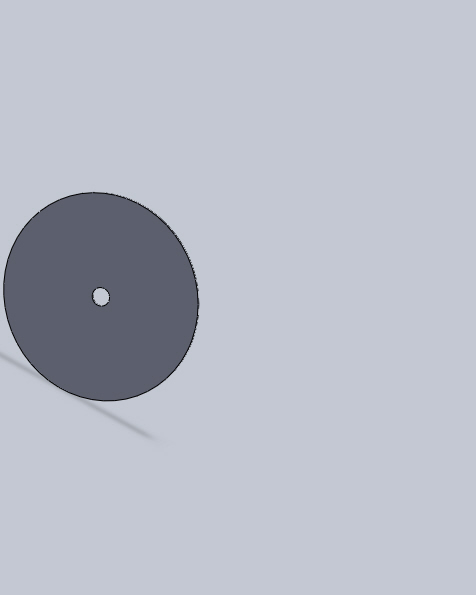
components/84/84model.JPG
