h4ck3rm1k3/Cold-Saw/components/84/Blade.jpg

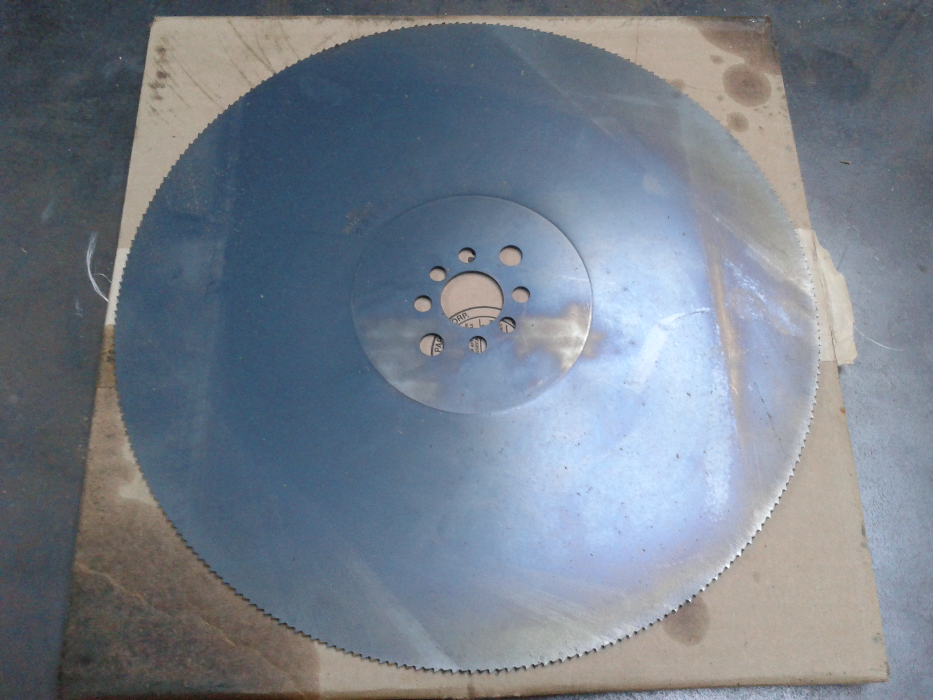
components/84/Blade.jpg
