h4ck3rm1k3/Cold-Saw/components/90/90model.JPG

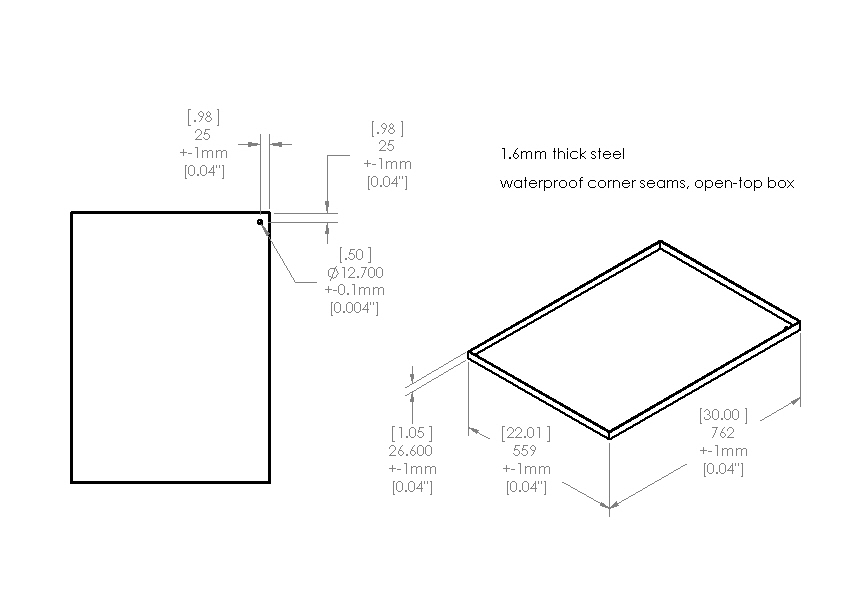
components/90/90model.JPG
