h4ck3rm1k3/Cold-Saw/components/90/PositioninBendTool.jpg

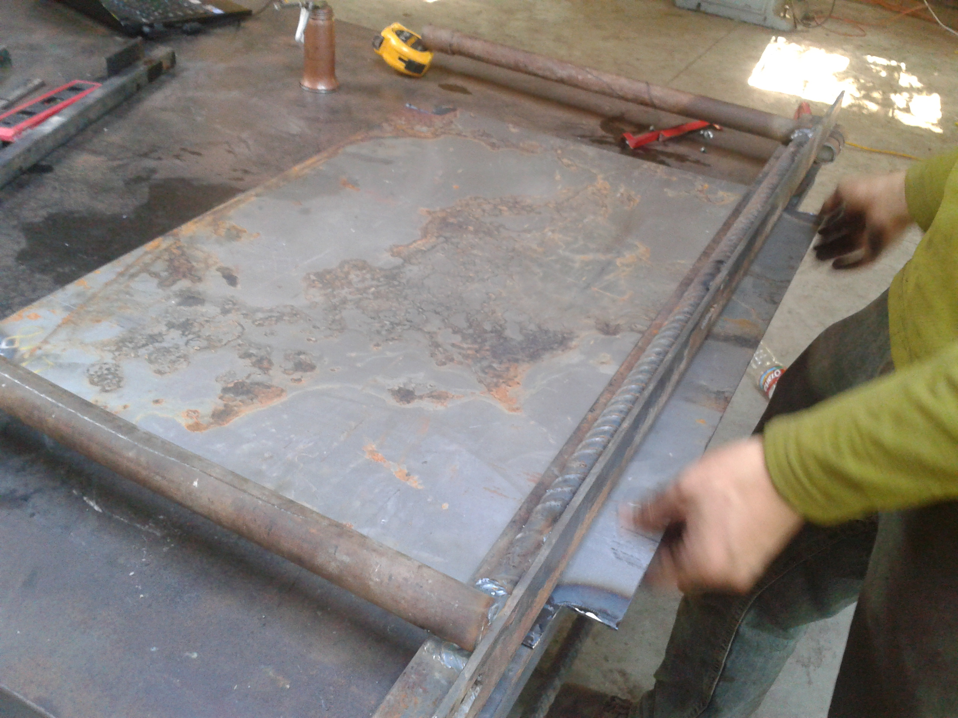
components/90/PositioninBendTool.jpg
