h4ck3rm1k3/Cold-Saw/components/90/TorchedCorners.jpg

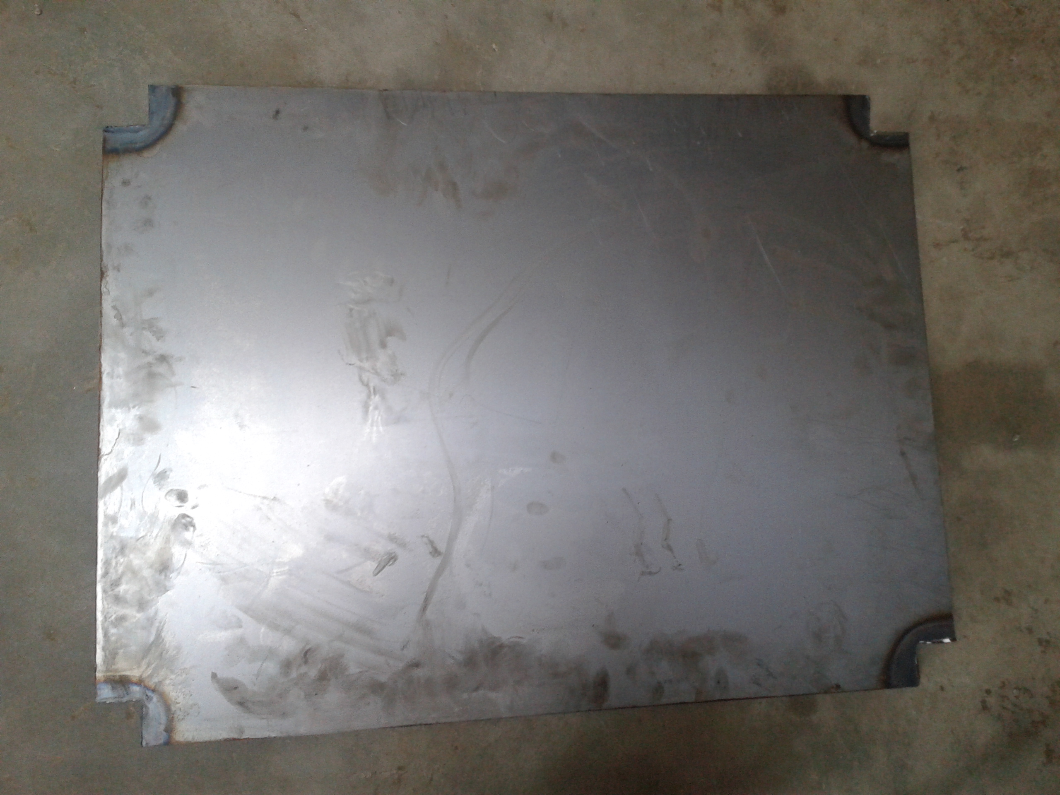
components/90/TorchedCorners.jpg
