h4ck3rm1k3/Cold-Saw/components/91/91model.JPG

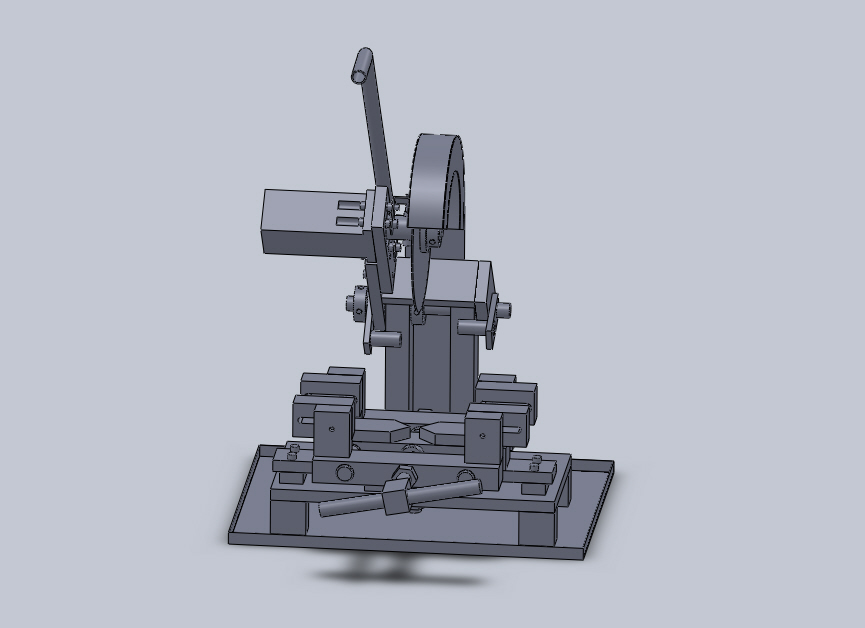
components/91/91model.JPG
