h4ck3rm1k3/Cold-Saw/components/91/labeled91model.png

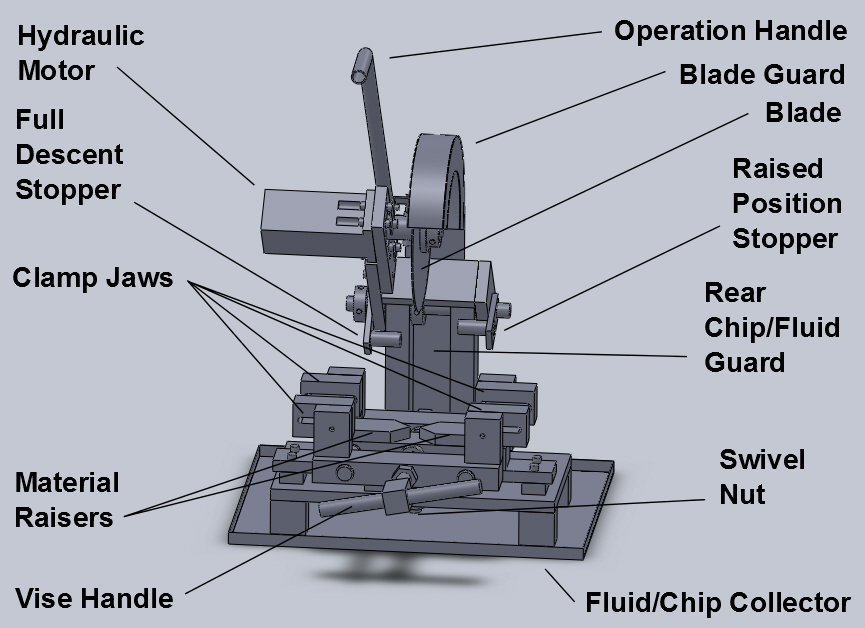
components/91/labeled91model.png
