h4ck3rm1k3/Cold-Saw/components/104/hydraulicdiagram.png

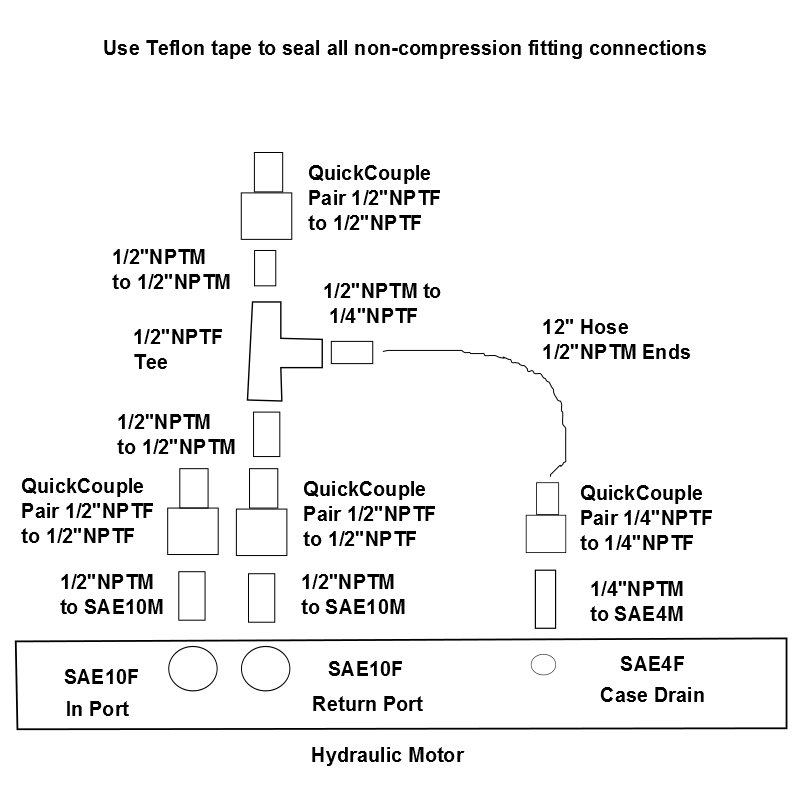
components/104/hydraulicdiagram.png
