h4ck3rm1k3/Cold-Saw/components/17/17model.SLDASM

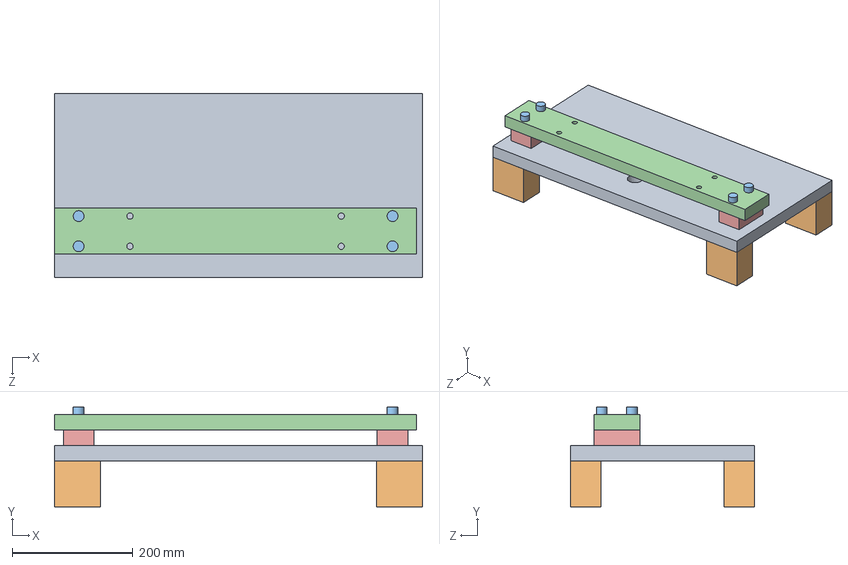
[picture p136: CAD file, 2012-08-11]
components/17/17model.SLDASM
609.6 x 165.0 x 304.8 mm
Baseplate
LongSpacer x 4
LongScrew x 4
2-2model
49model x 2
