h4ck3rm1k3/Cold-Saw/components/51/51model.SLDASM

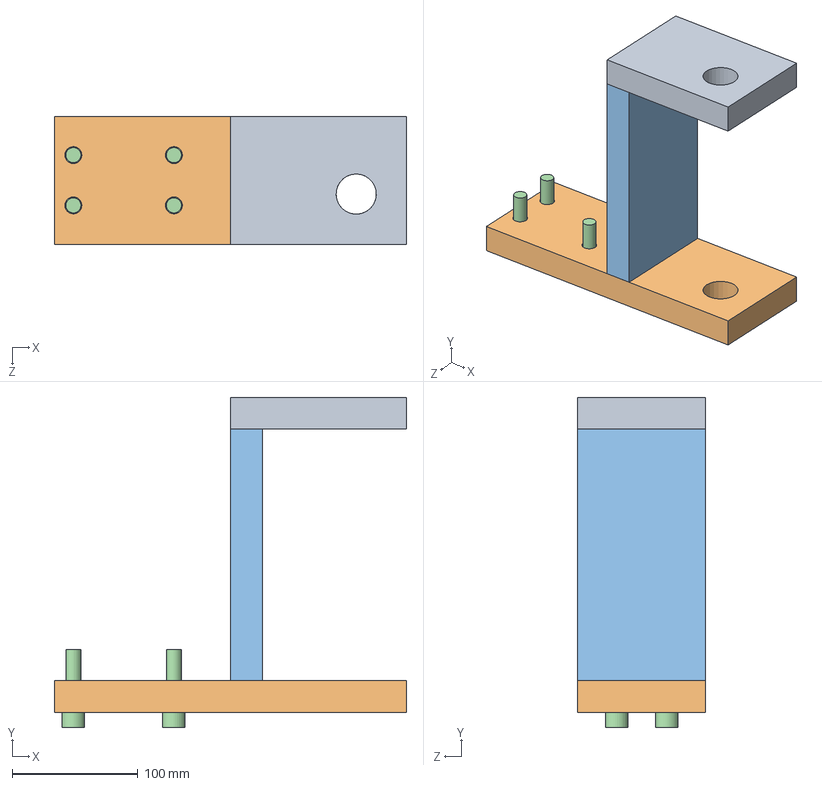
[picture p137: CAD file, 2012-08-11]
components/51/51model.SLDASM
280.0 x 262.8 x 101.6 mm
ShortSupportFlat
LongSupportFlat
26model
LongScrew x 4
