h4ck3rm1k3/Cold-Saw/components/52/GuardFlat/52model.SLDASM

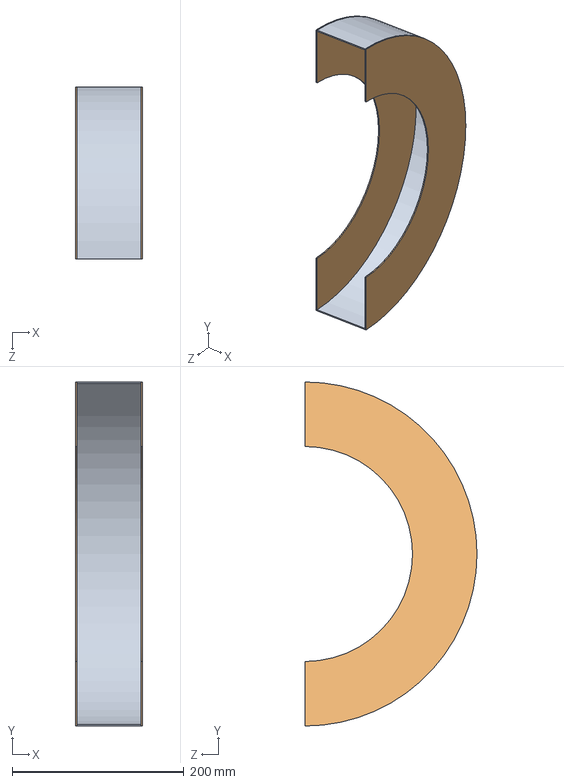
[picture p138: CAD file, 2012-08-11]
components/52/GuardFlat/52model.SLDASM
78.2 x 400.0 x 200.0 mm
GuardFlat
GuardSide x 2
