h4ck3rm1k3/Cold-Saw/components/53/53model.SLDASM

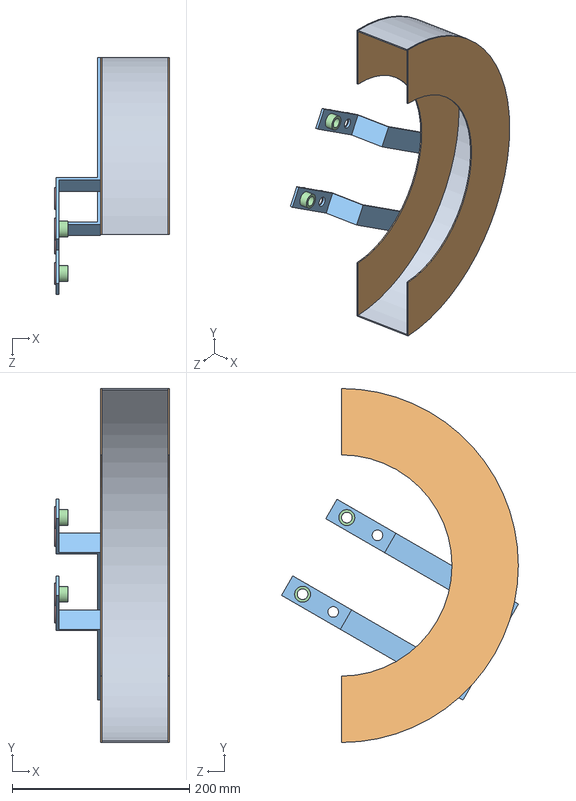
[picture p139: CAD file, 2012-08-11]
components/53/53model.SLDASM
130.2 x 400.0 x 267.8 mm
GuardFlat
GuardSide x 2
GuardSupport x 2
MediumNut x 2
87model x 4
