h4ck3rm1k3/Cold-Saw/components/54/54model.SLDASM

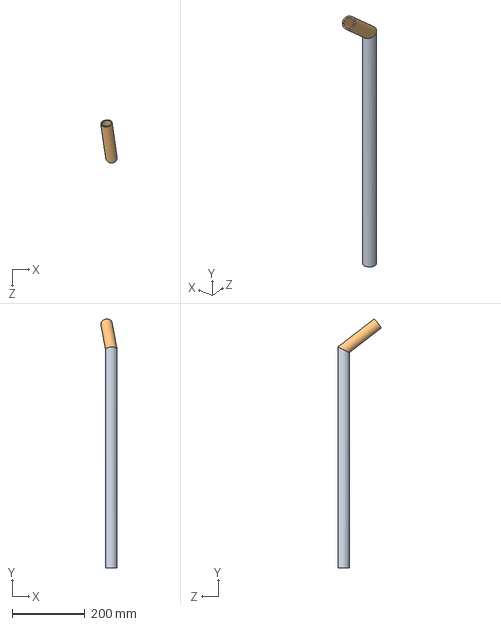
[picture p140: CAD file, 2012-08-11]
components/54/54model.SLDASM
45.2 x 686.7 x 119.3 mm
OperationHandle
OperationHandleSupport
