h4ck3rm1k3/Cold-Saw/components/55/55model.SLDASM

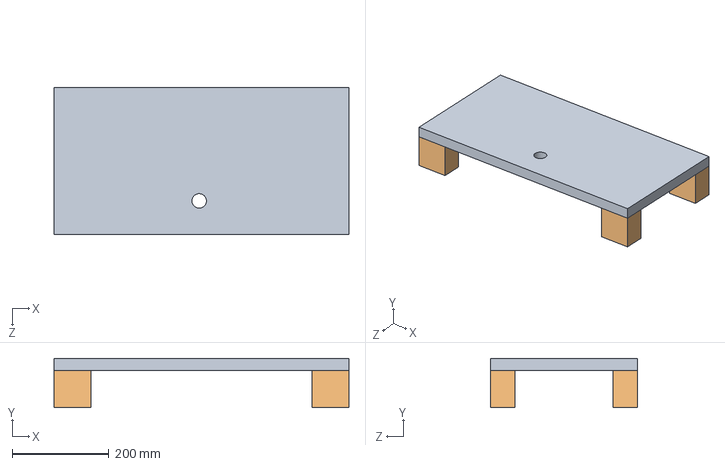
[picture p141: CAD file, 2012-08-10]
components/55/55model.SLDASM
609.6 x 101.6 x 304.8 mm
Baseplate
LongSpacer x 4
