h4ck3rm1k3/Cold-Saw/components/71/71model.SLDASM

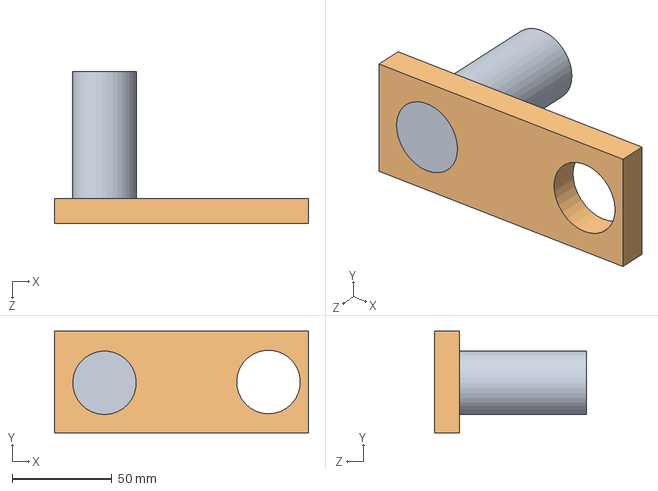
[picture p142: CAD file, 2012-08-11]
components/71/71model.SLDASM
127.0 x 50.8 x 76.2 mm
StopShaft
38model
