h4ck3rm1k3/Cold-Saw/components/76/76model.SLDASM

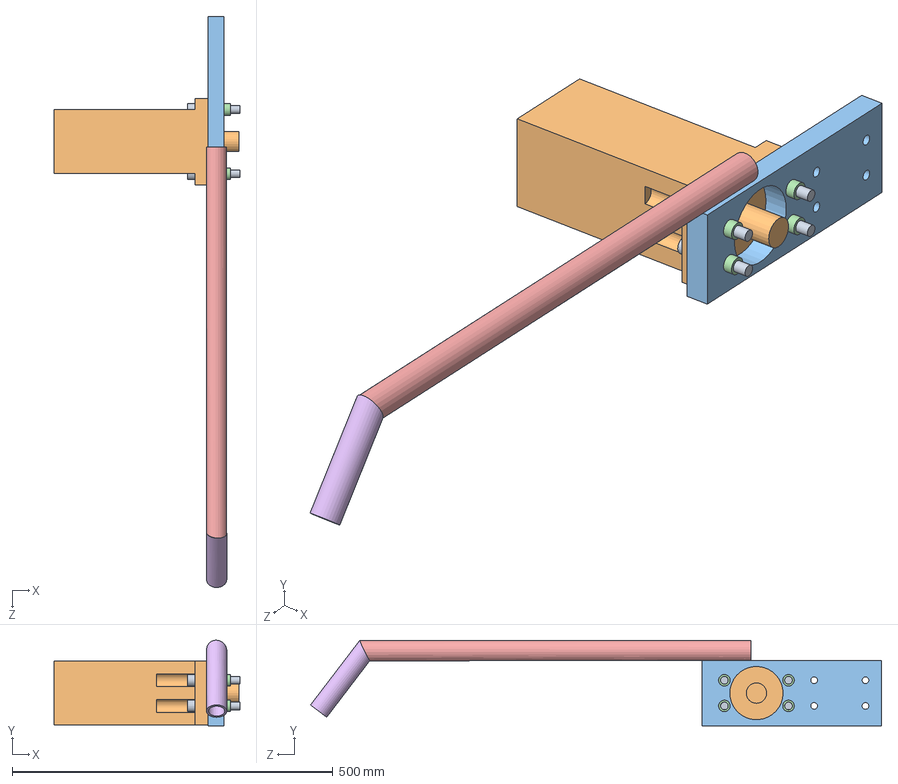
[picture p143: CAD file, 2012-08-11]
components/76/76model.SLDASM
290.0 x 133.5 x 890.5 mm
Long2Screw x 4
HydraulicMotor
RotationSupportFlat
MediumNut x 4
OperationHandle
OperationHandleSupport
