h4ck3rm1k3/Cold-Saw/components/80/80model.SLDASM

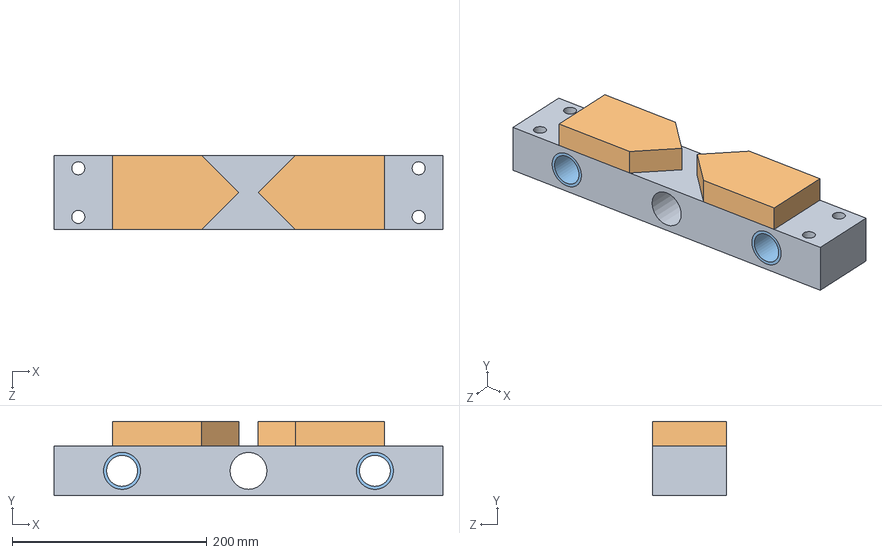
[picture p144: CAD file, 2012-08-10]
components/80/80model.SLDASM
400.0 x 76.2 x 76.2 mm
FixedBlock
Raiser x 2
67model x 2
