h4ck3rm1k3/Cold-Saw/components/81/81model.SLDASM

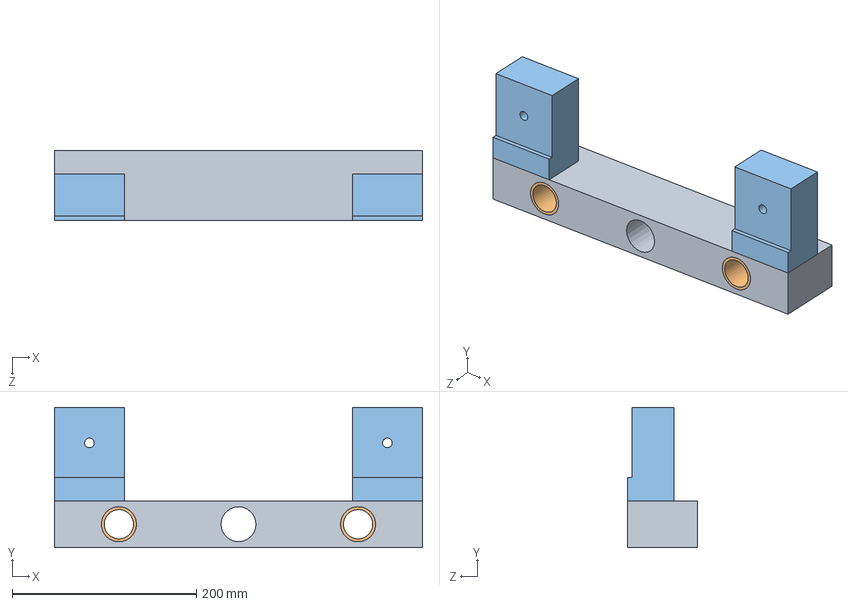
[picture p145: CAD file, 2012-08-10]
components/81/81model.SLDASM
400.0 x 152.4 x 76.2 mm
MovingBlock
67model x 2
ClampBlock x 2
