h4ck3rm1k3/Cold-Saw/components/82/82model.SLDASM

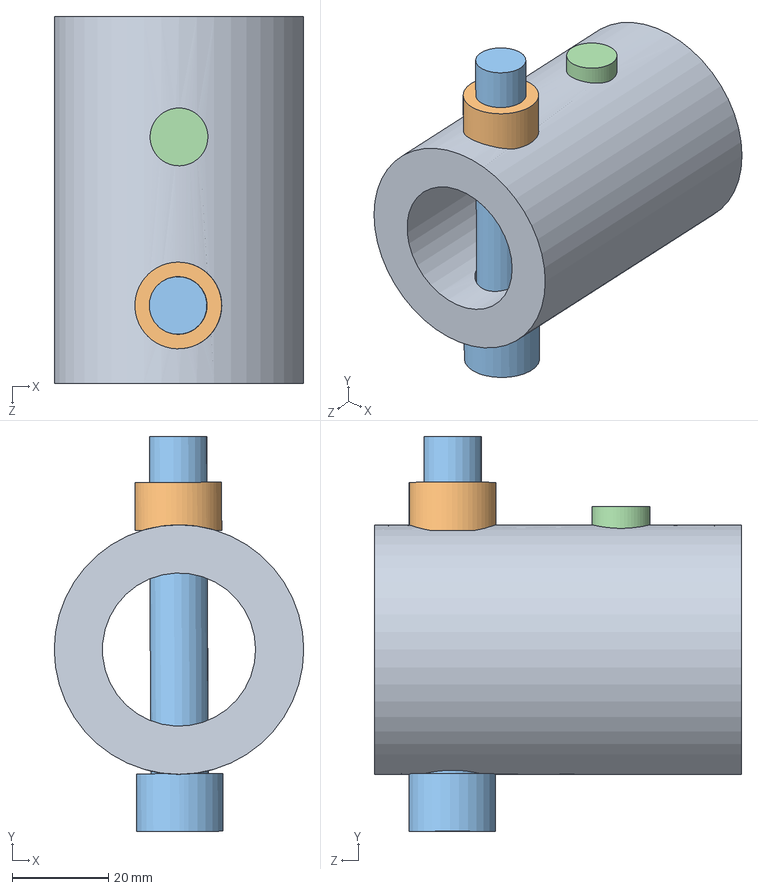
[picture p146: CAD file, 2012-08-11]
components/82/82model.SLDASM
51.8 x 82.1 x 76.2 mm
ShaftCoupling
MediumNut
Long2Screw
56model
