h4ck3rm1k3/Cold-Saw/components/83/83model.SLDASM

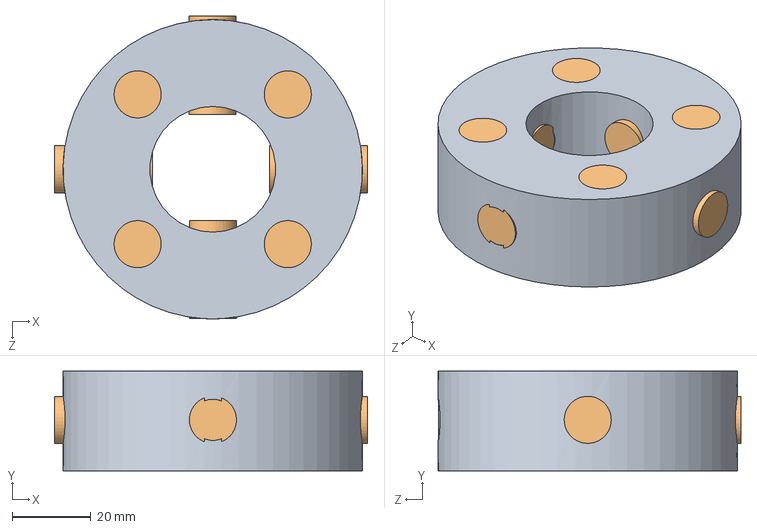
[picture p147: CAD file, 2012-08-11]
components/83/83model.SLDASM
79.7 x 25.4 x 77.1 mm
DriveCollar
57model x 8
