h4ck3rm1k3/Cold-Saw/components/85/85model.SLDASM

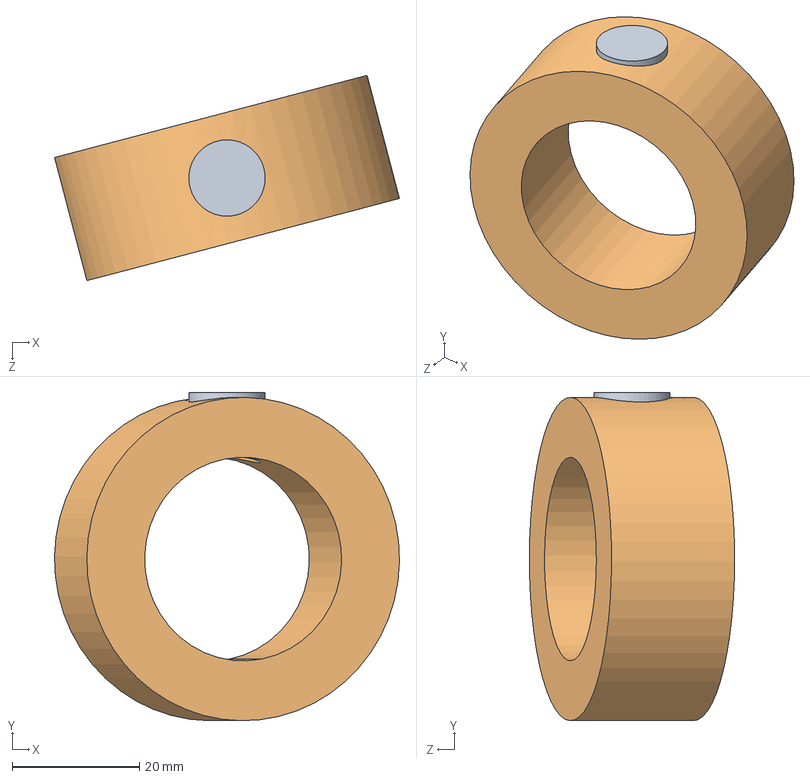
[picture p148: CAD file, 2012-08-11]
components/85/85model.SLDASM
54.2 x 51.6 x 32.3 mm
56model
44model
