h4ck3rm1k3/Cold-Saw/devtemp/Base/BaseAssembly/BaseAssembly.STEP

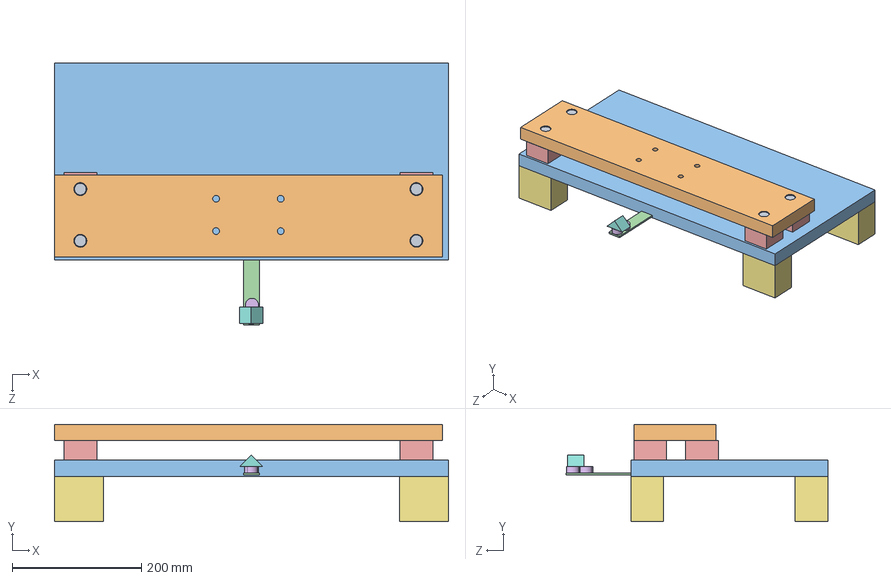
[picture p149: CAD file, 2012-07-04]
devtemp/Base/BaseAssembly/BaseAssembly.STEP
609.6 x 150.8 x 404.8 mm
LongScrew x 4
BaseFlat
Baseplate
IndicatorFlat
ShortSpacer x 4
Magnet x 2
LongSpacer x 4
AngleIndicator
