h4ck3rm1k3/Cold-Saw/devtemp/CompleteAssembly/FullAssembly.STEP

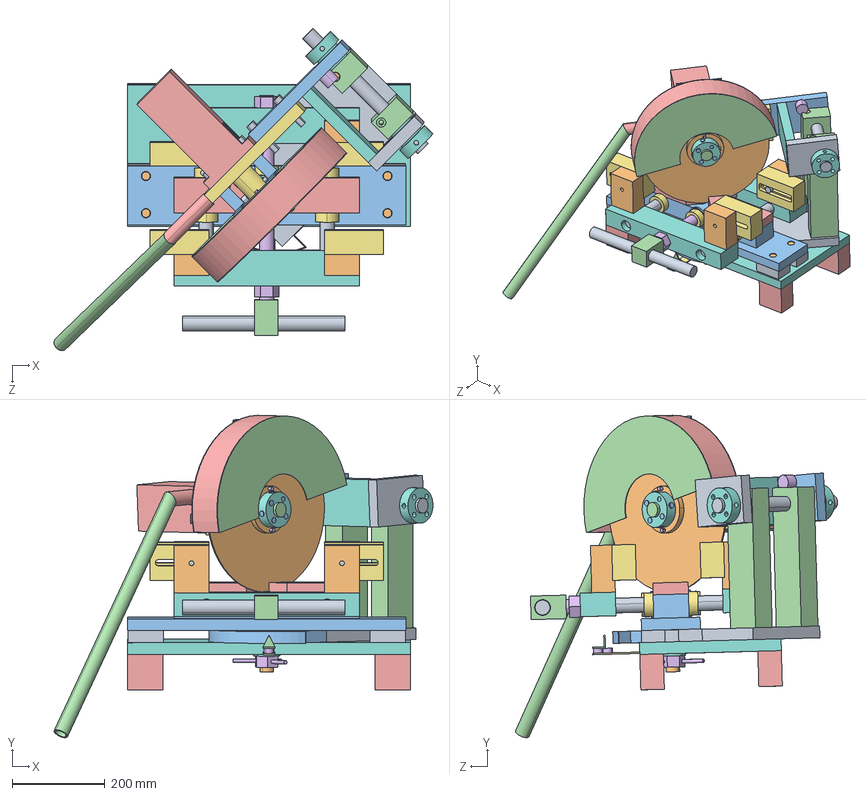
[picture p150: CAD file, 2012-07-10]
devtemp/CompleteAssembly/FullAssembly.STEP
815.7 x 694.2 x 693.2 mm
ShortSpacer x 4
LongScrew x 5
BaseFlat
AngleIndicator
LongSpacer x 4
Magnet x 2
IndicatorFlat
Baseplate
Long2Screw x 17
MediumNut x 5
LongSupportFlat
OperationHandle
OperationHandleSupport
StopShaft
RotationSupportFlat
BridgeFlat
ShortSupportFlat
MountDisc x 2
CollarSetscrew x 8
Spindle
HydraulicMotor
Pin x 5
ShaftCoupling
DriveCollar x 3
CouplingSetscrew x 7
Blade
GuardSupport x 2
GuardSide x 2
GuardFlat
ThreadedRod
ClampJaw x 4
SupportThrustWasher x 7
SupportShaft x 4
ClampBlock x 4
FixedBlock
HandleBlock
Raiser x 2
LargeLHNut x 2
MediumShaftCollar x 6
MovingBlock x 2
SwivelPlate
LargeNut
ShortThreadedRod
MeasureFlat
ShaftBlock x 2
