h4ck3rm1k3/Cold-Saw/devtemp/Rotation/DriveAssembly/DriveAssembly.STEP

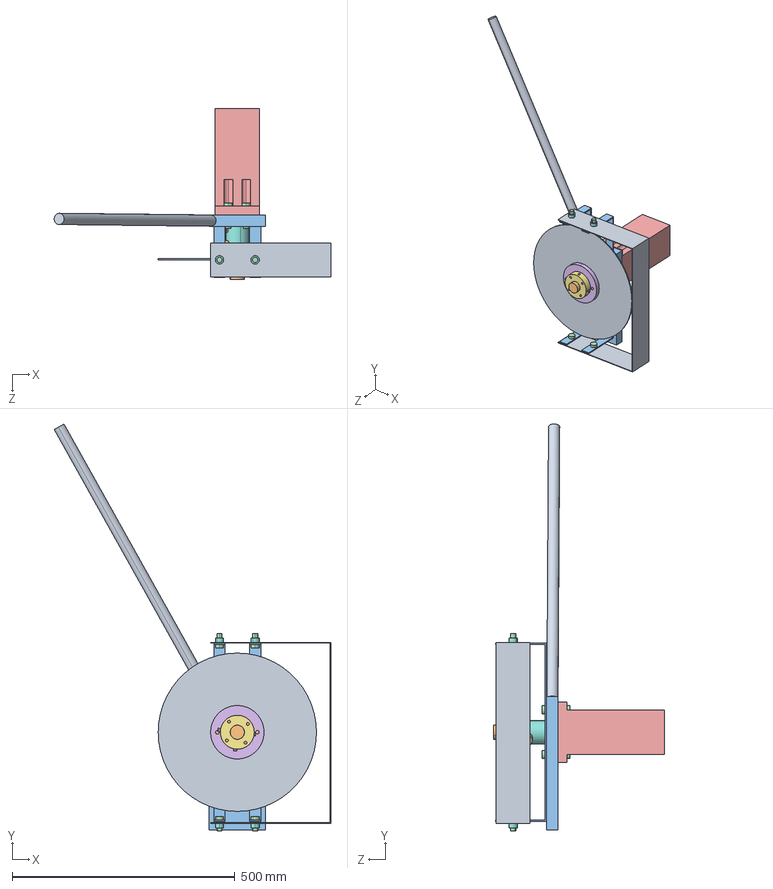
[picture p151: CAD file, 2012-07-04]
devtemp/Rotation/DriveAssembly/DriveAssembly.STEP
621.4 x 914.1 x 385.0 mm
Blade
PinCollar x 2
BladeGuardSupport x 2
BladeGuardBolt x 8
CollarSetscrew x 8
MountDisc x 2
CouplingSetscrew x 3
BladeGuardNut x 4
BladeGuard
Pin x 2
InterfacePlate
InterfaceBolt x 4
HydraulicMotor
CouplingPin
DriveCollar
ShaftCoupling
OperationHandle
Spindle
