h4ck3rm1k3/Cold-Saw/devtemp/Shaft Accessories/MediumShaftCollarAssem/MediumShaftCollarAssem.SLDASM

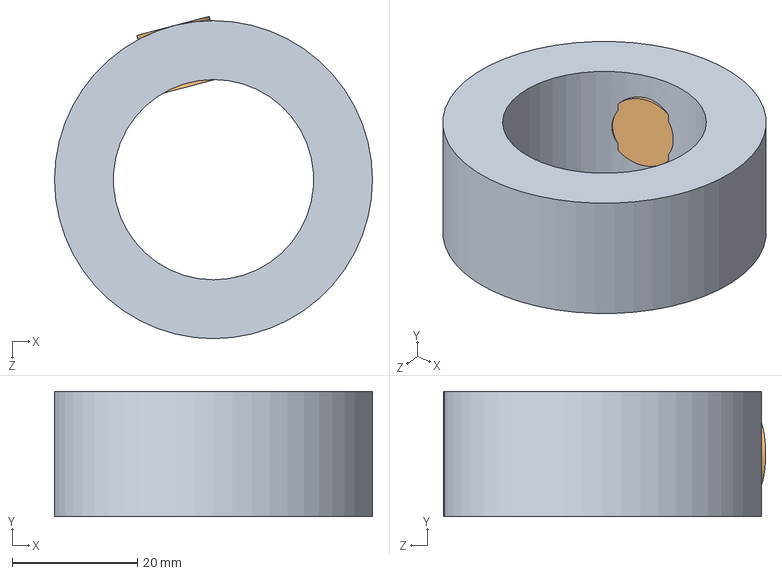
[picture p152: CAD file, 2012-07-10]
devtemp/Shaft Accessories/MediumShaftCollarAssem/MediumShaftCollarAssem.SLDASM
50.8 x 20.0 x 51.5 mm
MediumShaftCollar
CouplingSetscrew
