h4ck3rm1k3/Cold-Saw/devtemp/Support/SupportSystem/SupportAssembly.STEP

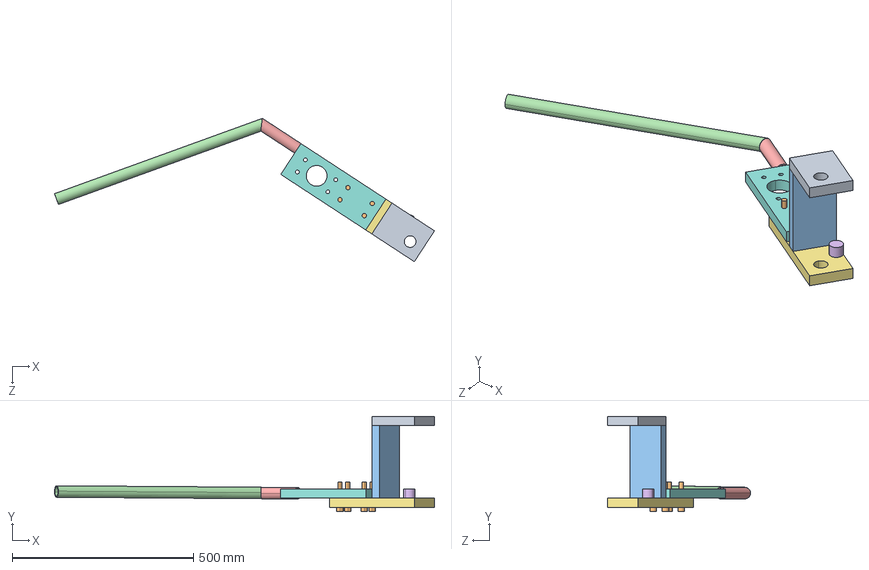
[picture p153: CAD file, 2012-07-10]
devtemp/Support/SupportSystem/SupportAssembly.STEP
1047.7 x 262.8 x 395.4 mm
ShortSupportFlat
Long2Screw x 4
BridgeFlat
OperationHandle
OperationHandleSupport
StopShaft
LongSupportFlat
RotationSupportFlat
