h4ck3rm1k3/Cold-Saw/devtemp/Swivel/SwivelAssembly/SwivelAssembly.STEP

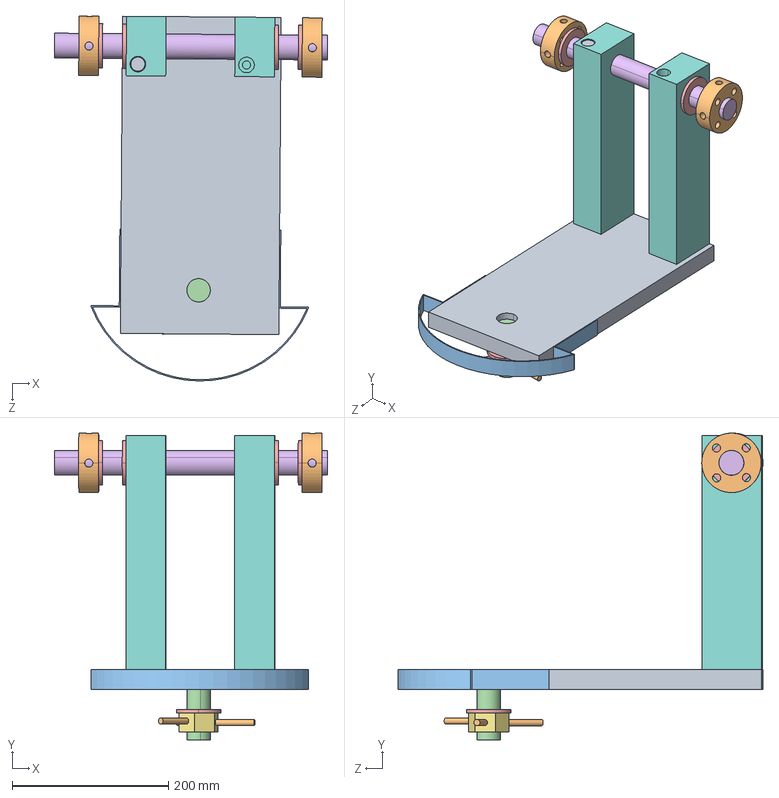
[picture p154: CAD file, 2012-07-10]
devtemp/Swivel/SwivelAssembly/SwivelAssembly.STEP
350.2 x 393.1 x 467.7 mm
LongScrew
Pin x 3
MeasureFlat
ShortThreadedRod
SupportThrustWasher x 5
SupportShaft
LargeNut
ShaftBlock x 2
SwivelPlate
DriveCollar x 2
