h4ck3rm1k3/Cold-Saw/devtemp/Vise/ViseAssembly/ViseAssembly.STEP

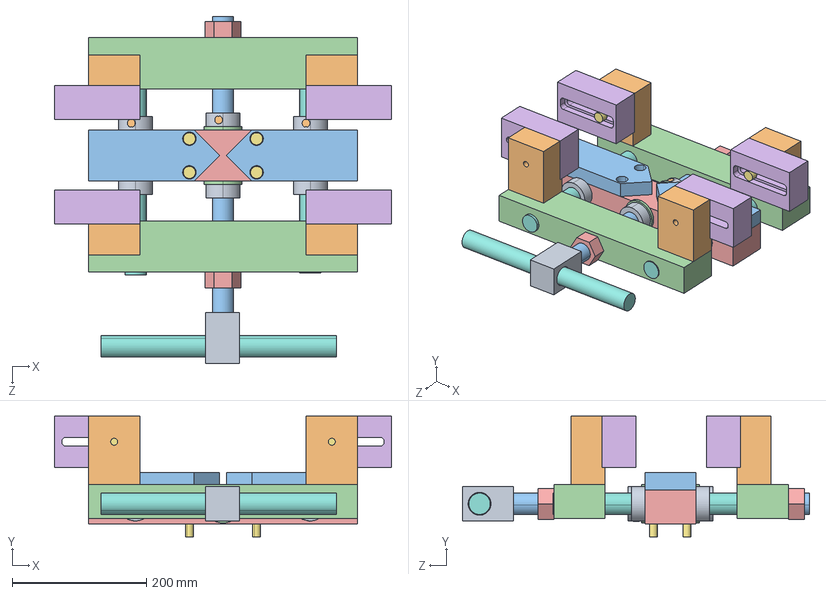
[picture p155: CAD file, 2012-07-10]
devtemp/Vise/ViseAssembly/ViseAssembly.STEP
501.6 x 179.6 x 516.2 mm
HandleBlock
ClampBlock x 4
ThreadedRod
MovingBlock x 2
LargeLHNut x 2
ClampJaw x 4
Long2Screw x 8
SupportShaft x 3
MediumShaftCollar x 6
CouplingSetscrew x 6
Raiser x 2
SupportThrustWasher x 2
FixedBlock
