h4ck3rm1k3/Cold-Saw/devtemp/Vise/ViseAssembly/ViseAssemblyEX.SLDASM

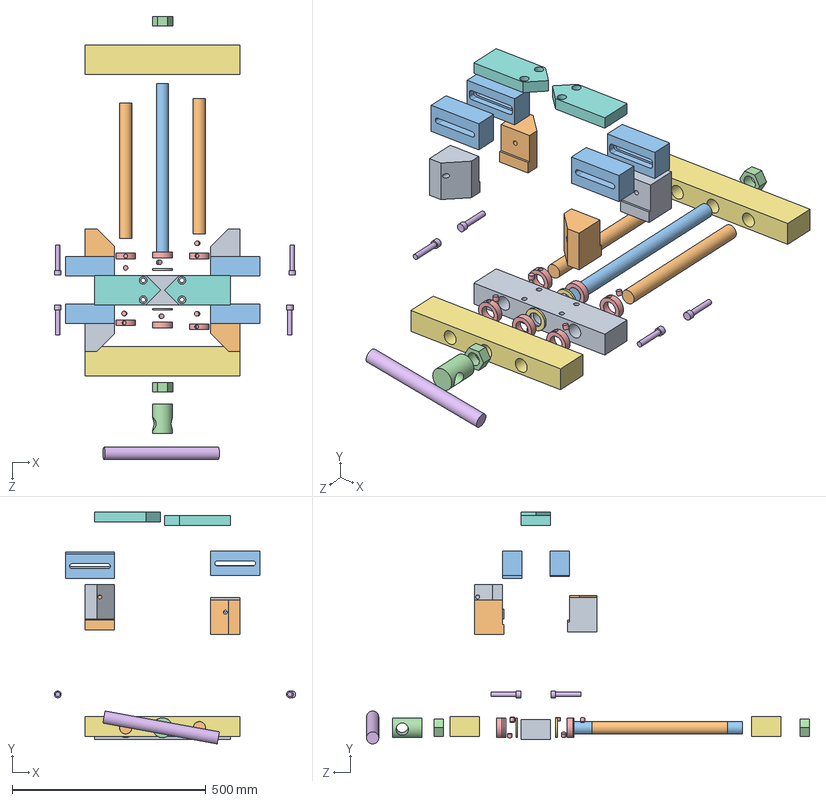
[picture p156: CAD file, 2012-07-04]
devtemp/Vise/ViseAssembly/ViseAssemblyEX.SLDASM
622.8 x 598.2 x 1142.7 mm
FixedBlock
SupportShaft x 2
ThreadedRod
LargeLHNut x 2
CouplingSetscrew x 6
Long2Screw x 4
MovingBlock x 2
Raiser x 2
OtherClampBlock x 2
ClampBlock x 2
ClampJaw x 4
HandleCollar
MediumShaftCollar x 6
Handle
SupportThrustWasher x 2
