h4ck3rm1k3/Cold-Saw/components/18/HydraulicMotor.STEP

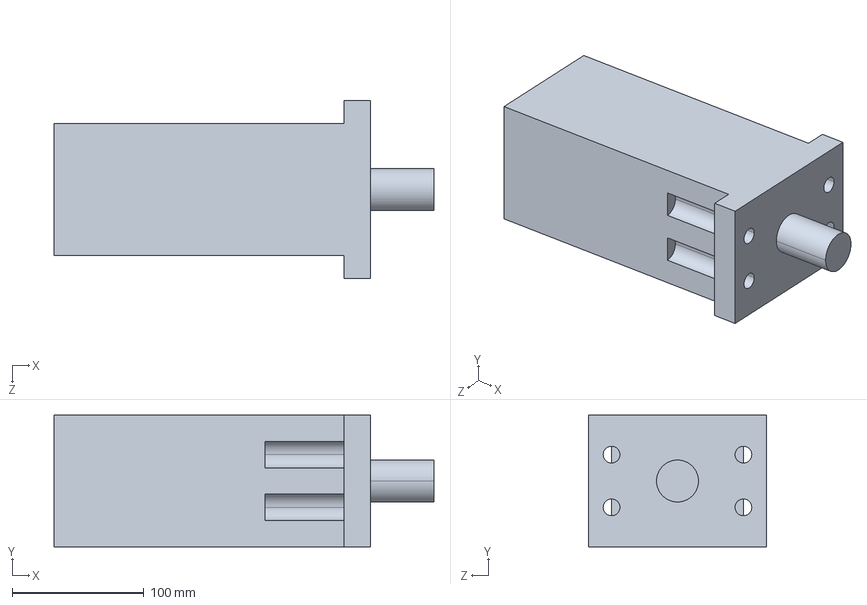
[picture p157: CAD file, 2012-07-04]
components/18/HydraulicMotor.STEP
288.3 x 100.0 x 135.0 mm
