h4ck3rm1k3/Cold-Saw/components/21/Baseplate.STEP

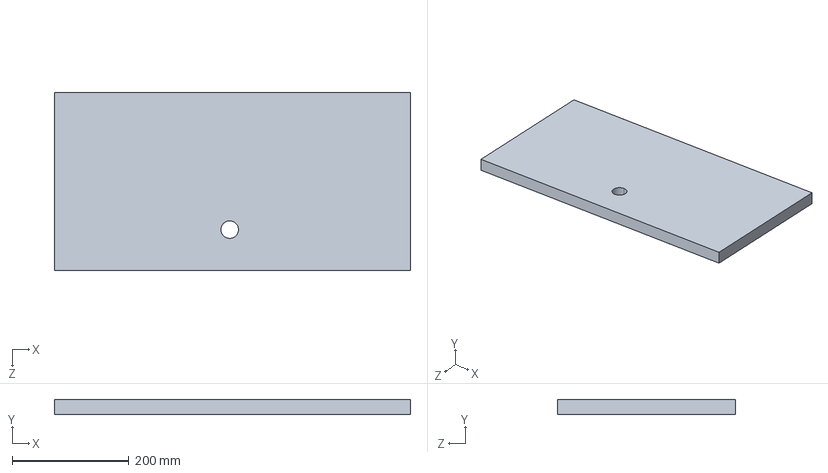
[picture p158: CAD file, 2012-07-04]
components/21/Baseplate.STEP
609.6 x 25.4 x 304.8 mm
