h4ck3rm1k3/Cold-Saw/components/22/2-2model.SLDPRT

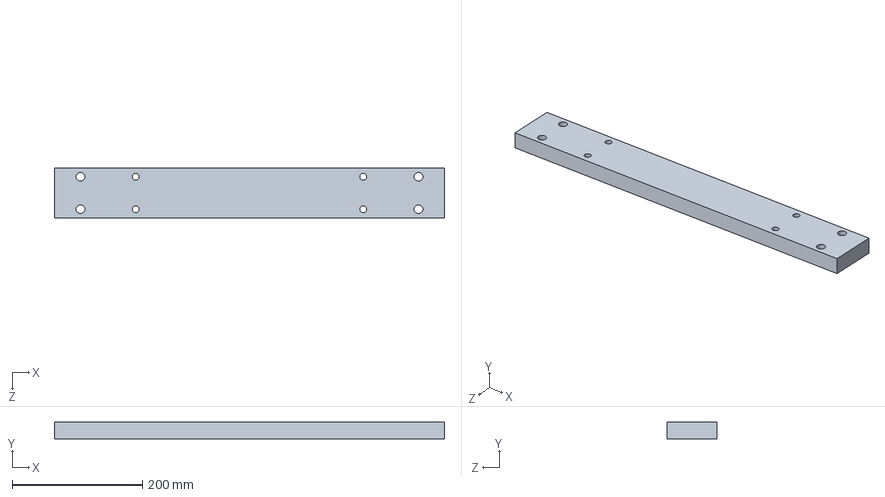
[picture p159: CAD file, 2012-08-02]
components/22/2-2model.SLDPRT
600.0 x 25.4 x 76.2 mm
