h4ck3rm1k3/Cold-Saw/components/23/Raiser.STEP

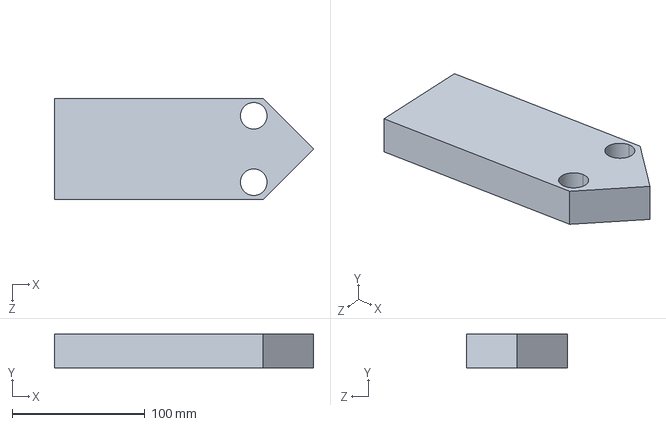
[picture p160: CAD file, 2012-07-11]
components/23/Raiser.STEP
195.0 x 25.4 x 76.2 mm
