h4ck3rm1k3/Cold-Saw/components/24/SwivelPlate.STEP

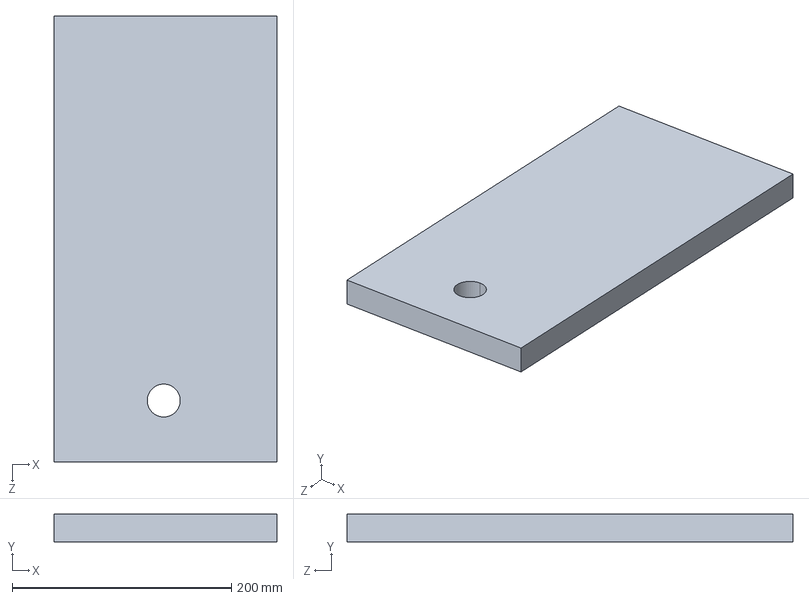
[picture p161: CAD file, 2012-07-04]
components/24/SwivelPlate.STEP
203.2 x 25.4 x 406.4 mm
