h4ck3rm1k3/Cold-Saw/components/25/ShortSupportFlat.STEP

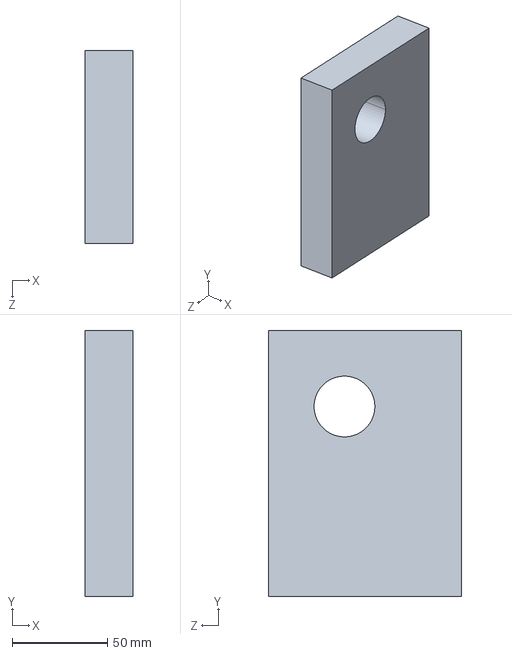
[picture p162: CAD file, 2012-07-05]
components/25/ShortSupportFlat.STEP
25.4 x 140.0 x 101.6 mm
