h4ck3rm1k3/Cold-Saw/components/26/26model.SLDPRT

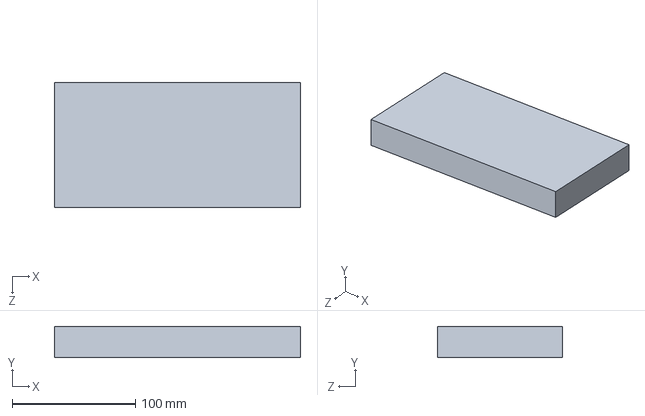
[picture p163: CAD file, 2012-07-05]
components/26/26model.SLDPRT
200.0 x 25.4 x 101.6 mm
