h4ck3rm1k3/Cold-Saw/components/27/LongSupportFlat.STEP

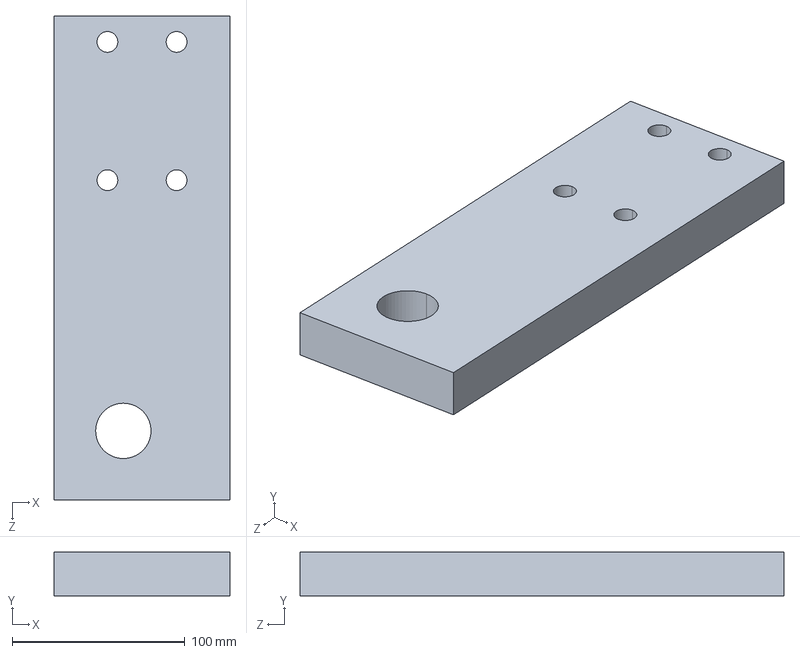
[picture p164: CAD file, 2012-07-11]
components/27/LongSupportFlat.STEP
101.6 x 25.4 x 280.0 mm
