h4ck3rm1k3/Cold-Saw/components/28/RotationSupportFlat.STEP

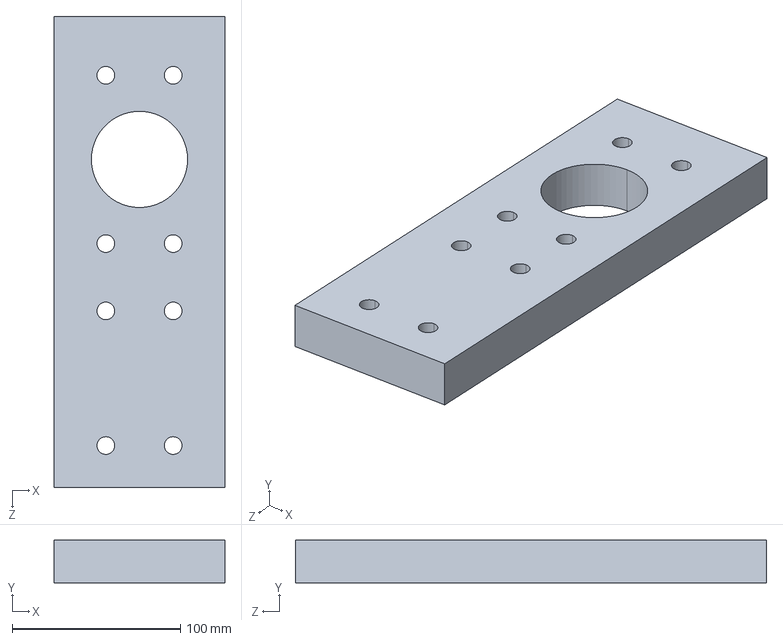
[picture p165: CAD file, 2012-07-10]
components/28/RotationSupportFlat.STEP
101.6 x 25.4 x 280.0 mm
