h4ck3rm1k3/Cold-Saw/components/29/GuardSupport.STEP

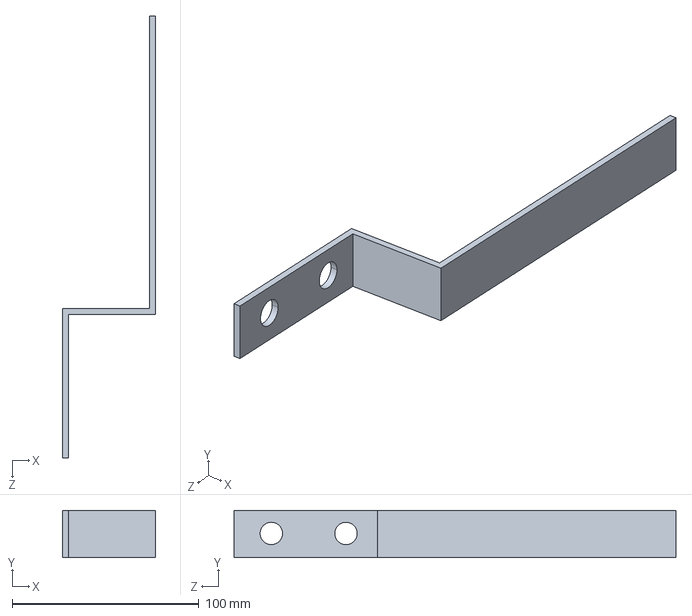
[picture p166: CAD file, 2012-07-04]
components/29/GuardSupport.STEP
50.0 x 25.4 x 236.8 mm
