h4ck3rm1k3/Cold-Saw/components/30/GuardSide.STEP

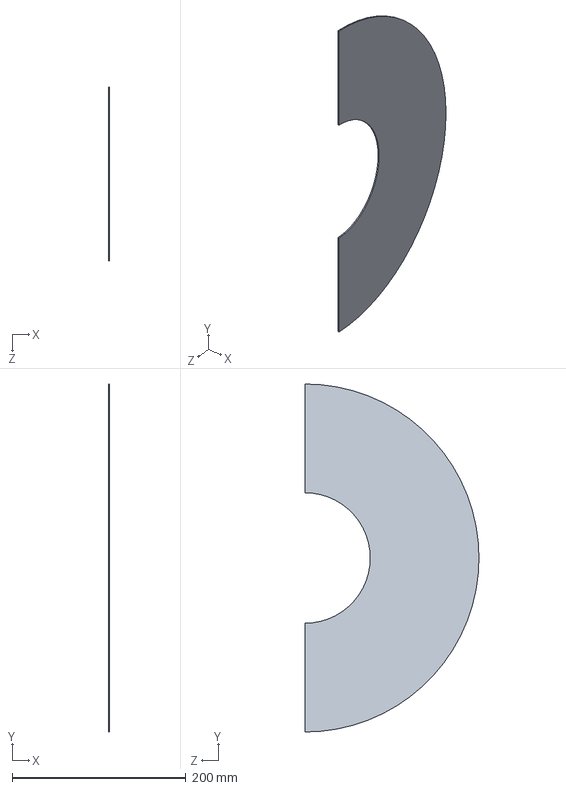
[picture p167: CAD file, 2012-07-04]
components/30/GuardSide.STEP
1.59 x 400.0 x 200.0 mm
