h4ck3rm1k3/Cold-Saw/components/31/HandleBlock.STEP

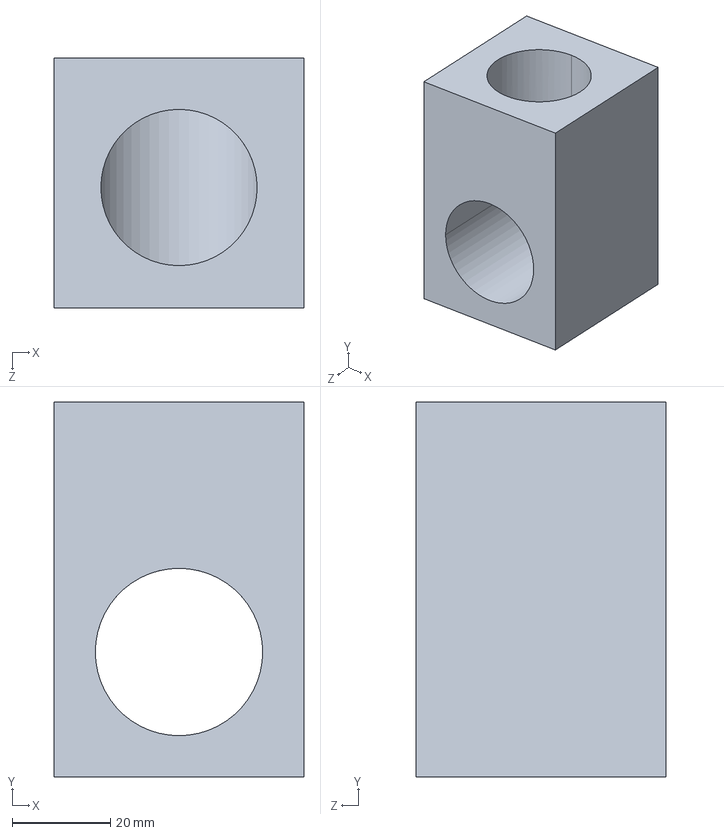
[picture p168: CAD file, 2012-07-07]
components/31/HandleBlock.STEP
50.8 x 76.2 x 50.8 mm
