h4ck3rm1k3/Cold-Saw/components/32/LongSpacer.STEP

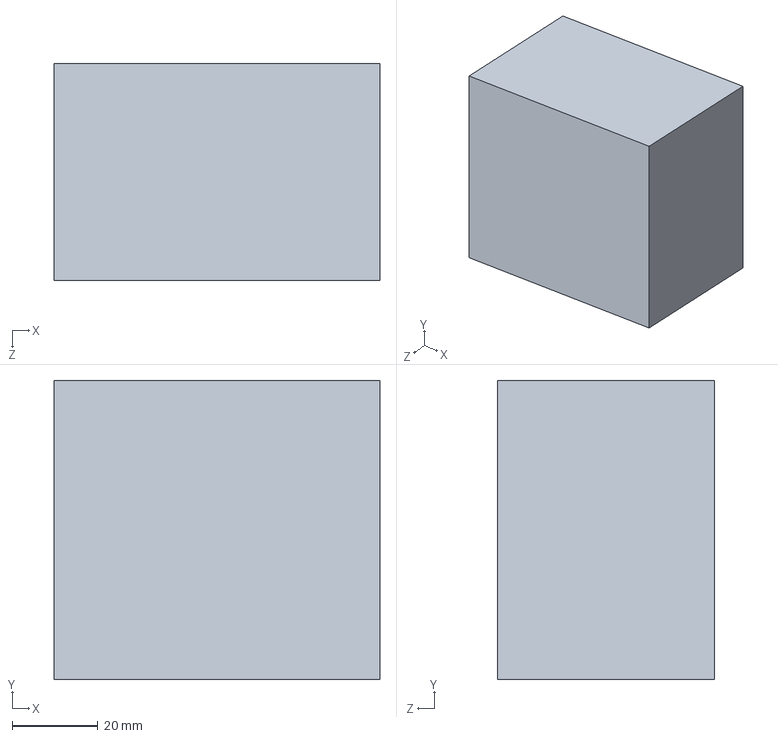
[picture p169: CAD file, 2012-07-04]
components/32/LongSpacer.STEP
76.2 x 70.0 x 50.8 mm
