h4ck3rm1k3/Cold-Saw/components/33/ClampBlock.STEP

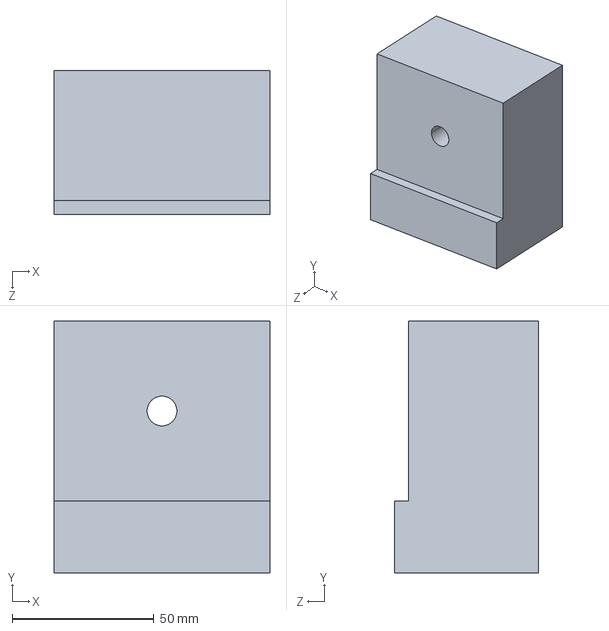
[picture p170: CAD file, 2012-07-09]
components/33/ClampBlock.STEP
76.2 x 88.9 x 50.8 mm
