h4ck3rm1k3/Cold-Saw/components/34/ClampJaw.STEP

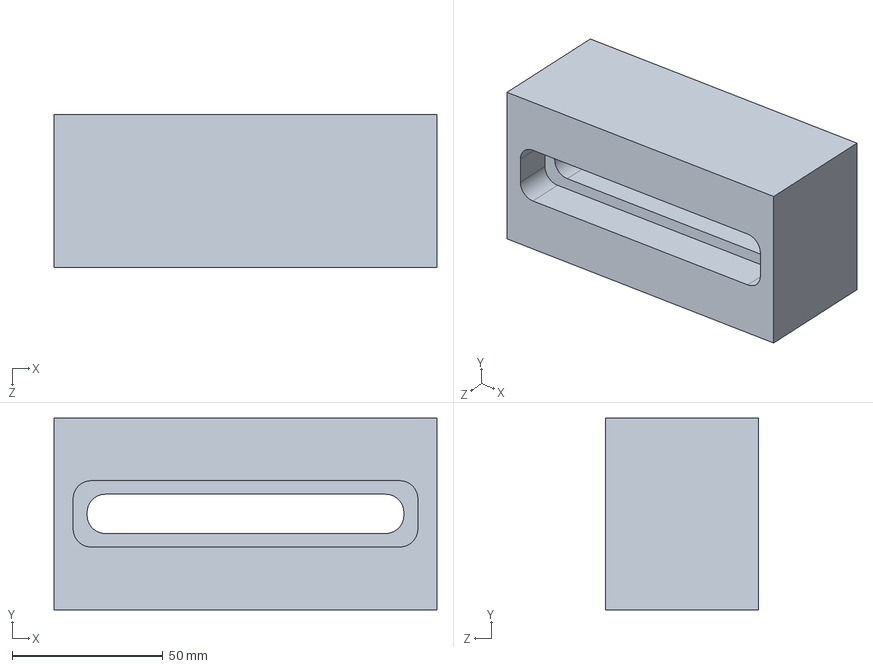
[picture p171: CAD file, 2012-07-04]
components/34/ClampJaw.STEP
127.0 x 63.5 x 50.8 mm
