h4ck3rm1k3/Cold-Saw/components/35/ShaftBlock2.SLDPRT

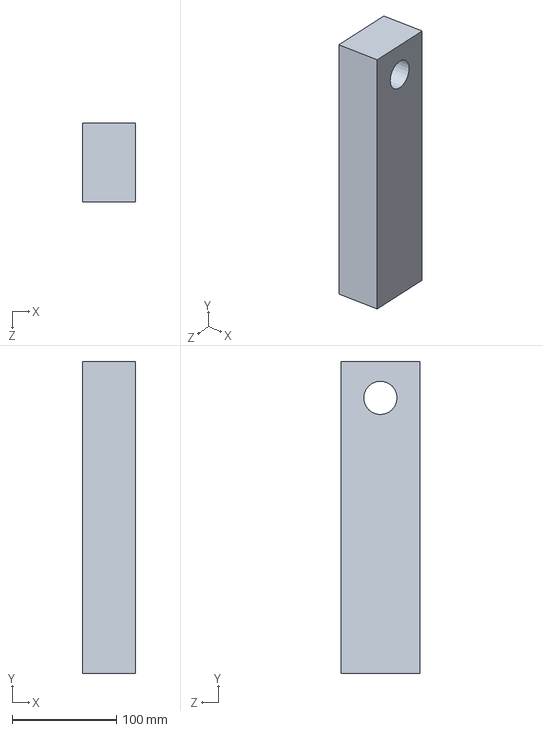
[picture p172: CAD file, 2012-07-17]
components/35/ShaftBlock2.SLDPRT
50.8 x 300.0 x 76.2 mm
