h4ck3rm1k3/Cold-Saw/components/36/FixedBlock.STEP

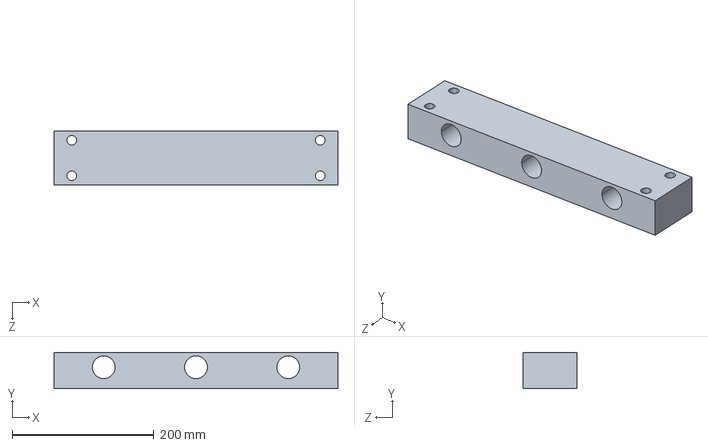
[picture p173: CAD file, 2012-07-14]
components/36/FixedBlock.STEP
400.0 x 50.8 x 76.2 mm
