h4ck3rm1k3/Cold-Saw/components/38/38model.SLDPRT

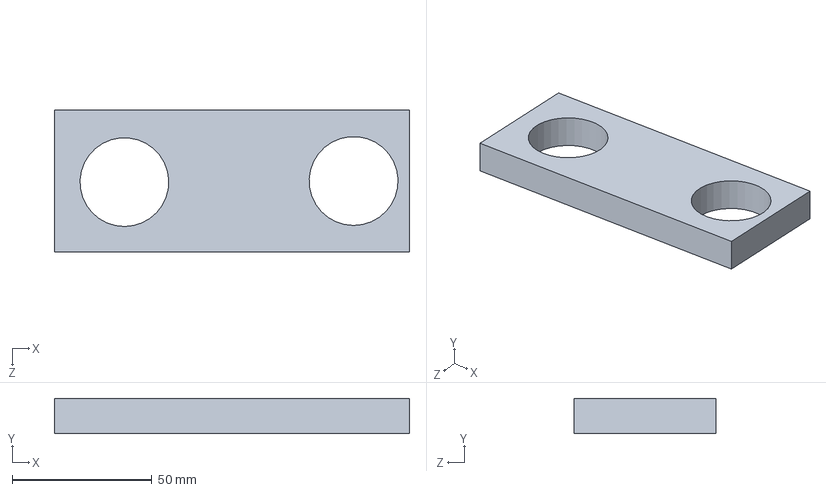
[picture p174: CAD file, 2012-08-02]
components/38/38model.SLDPRT
127.0 x 12.7 x 50.8 mm
