h4ck3rm1k3/Cold-Saw/components/41/DriveCollar.STEP

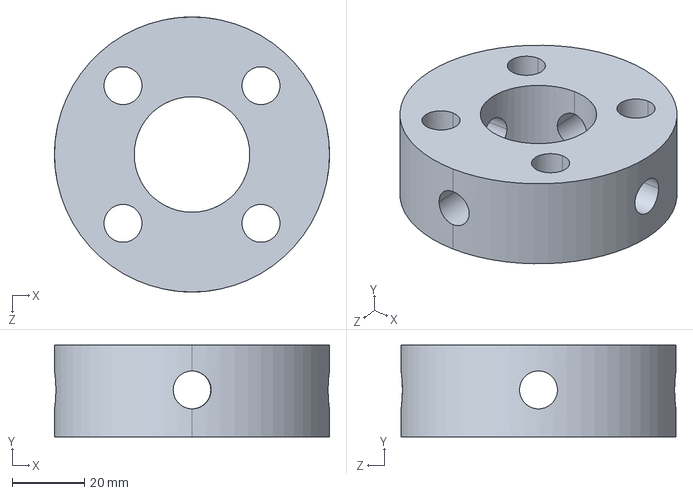
[picture p175: CAD file, 2012-07-04]
components/41/DriveCollar.STEP
76.2 x 25.4 x 76.2 mm
