h4ck3rm1k3/Cold-Saw/components/42/MountDisc.STEP

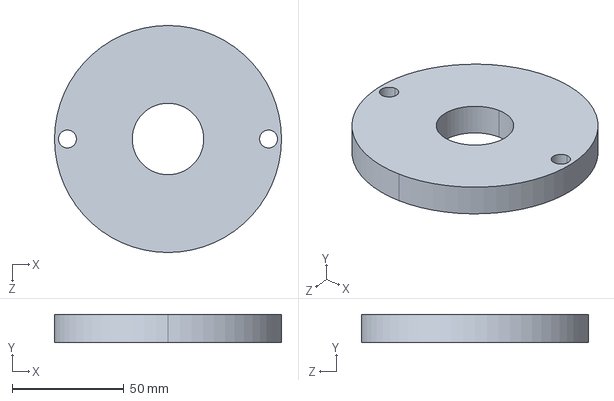
[picture p176: CAD file, 2012-07-04]
components/42/MountDisc.STEP
101.6 x 12.7 x 101.6 mm
