h4ck3rm1k3/Cold-Saw/components/43/ShaftCoupling.STEP

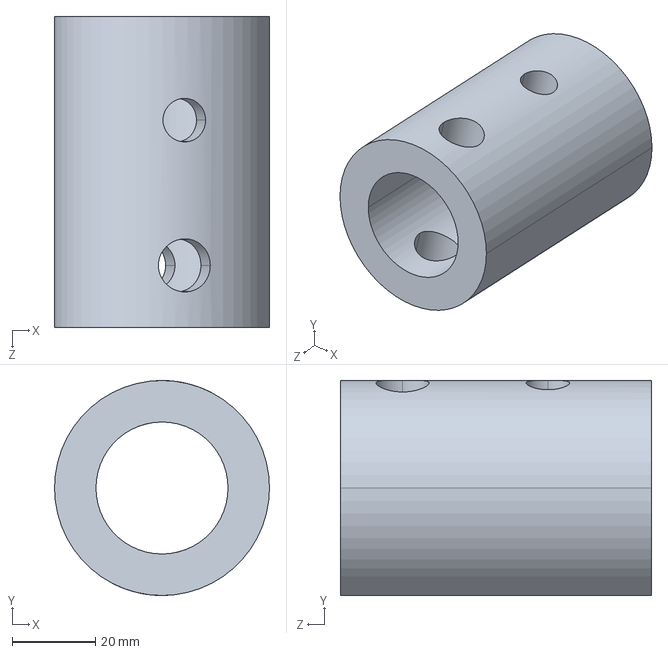
[picture p177: CAD file, 2012-07-04]
components/43/ShaftCoupling.STEP
51.8 x 51.8 x 75.0 mm
