h4ck3rm1k3/Cold-Saw/components/44/MediumShaftCollar.STEP

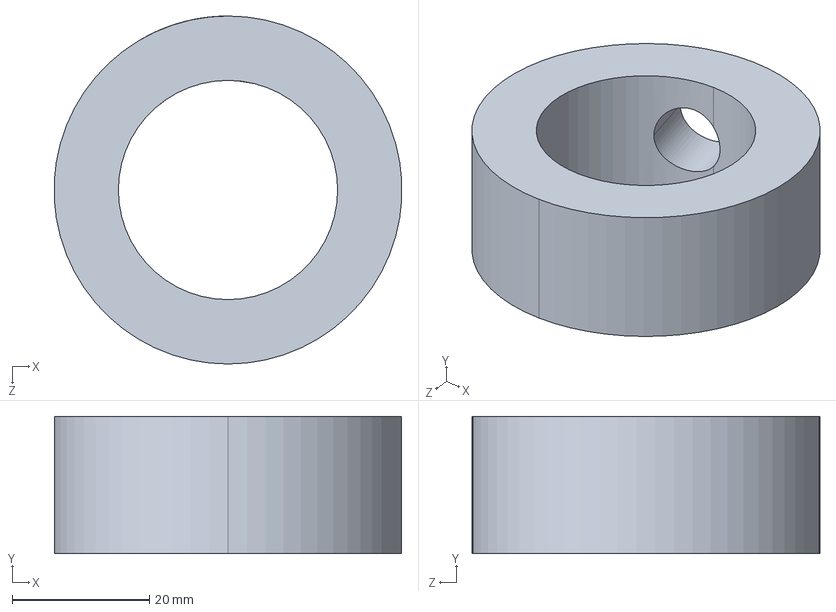
[picture p178: CAD file, 2012-07-10]
components/44/MediumShaftCollar.STEP
50.7 x 20.0 x 50.8 mm
