h4ck3rm1k3/Cold-Saw/components/45/SupportShaft.STEP

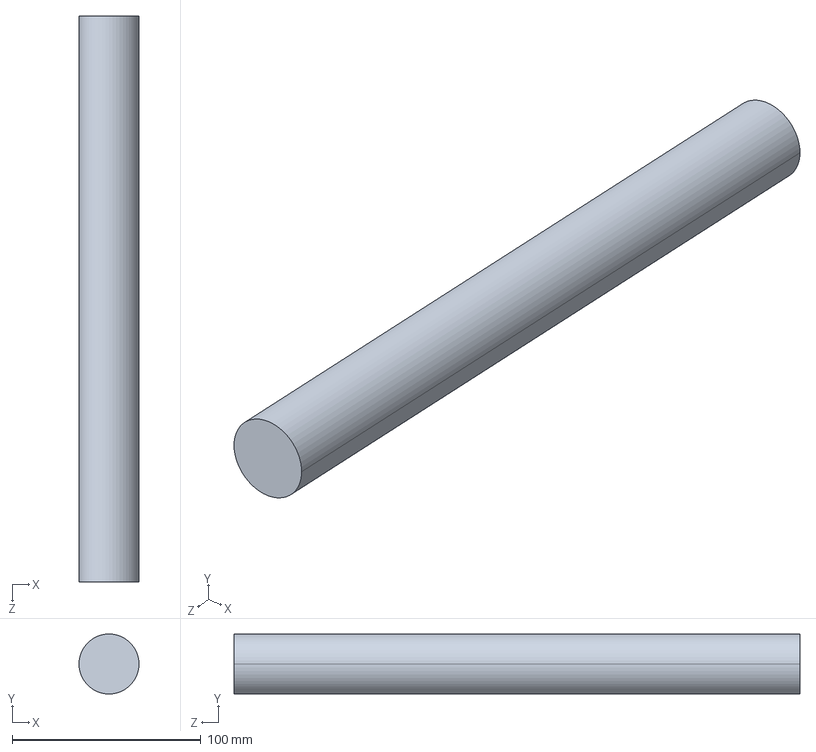
[picture p179: CAD file, 2012-07-04]
components/45/SupportShaft.STEP
31.8 x 31.8 x 300.0 mm
