h4ck3rm1k3/Cold-Saw/components/46/Spindle.STEP

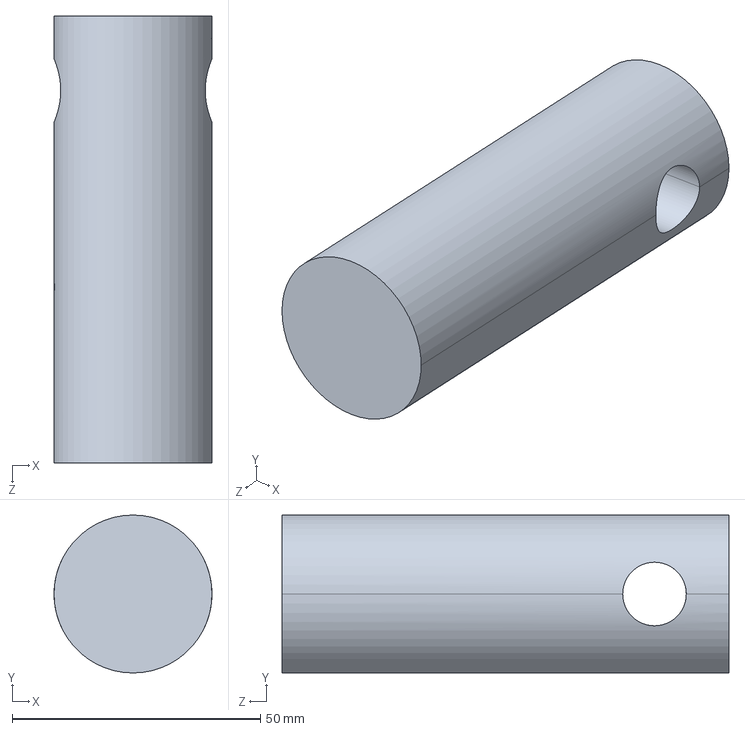
[picture p180: CAD file, 2012-07-06]
components/46/Spindle.STEP
31.8 x 31.8 x 90.0 mm
