h4ck3rm1k3/Cold-Saw/components/47/StopShaft.SLDPRT

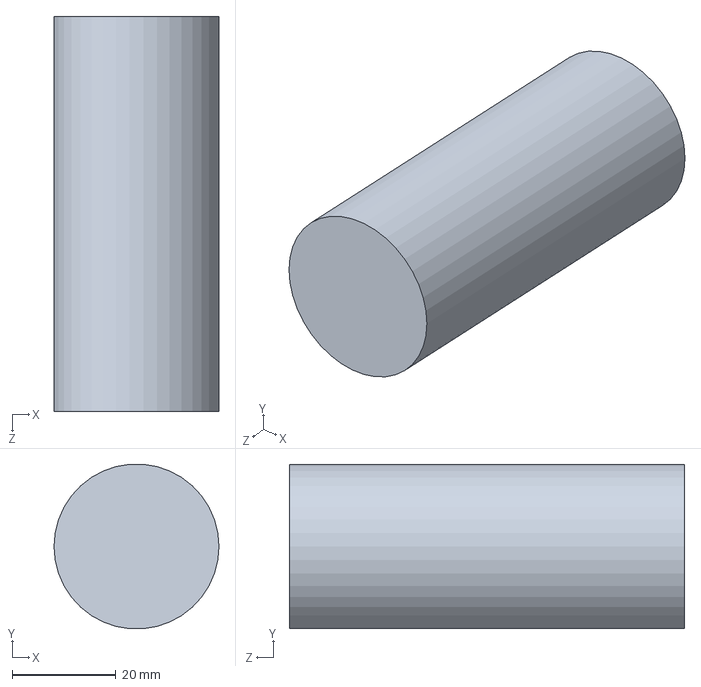
[picture p181: CAD file, 2012-08-11]
components/47/StopShaft.SLDPRT
31.8 x 31.7 x 76.2 mm
