h4ck3rm1k3/Cold-Saw/components/48/48model.SLDPRT

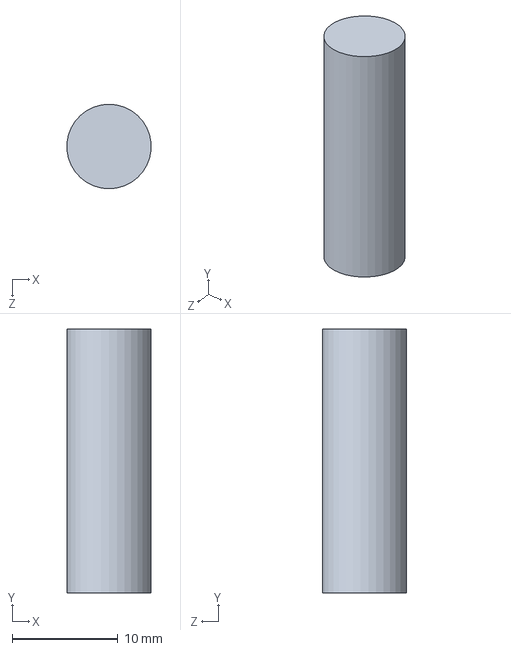
[picture p182: CAD file, 2012-08-11]
components/48/48model.SLDPRT
7.97 x 25.0 x 8.00 mm
