h4ck3rm1k3/Cold-Saw/components/49/49model.SLDPRT

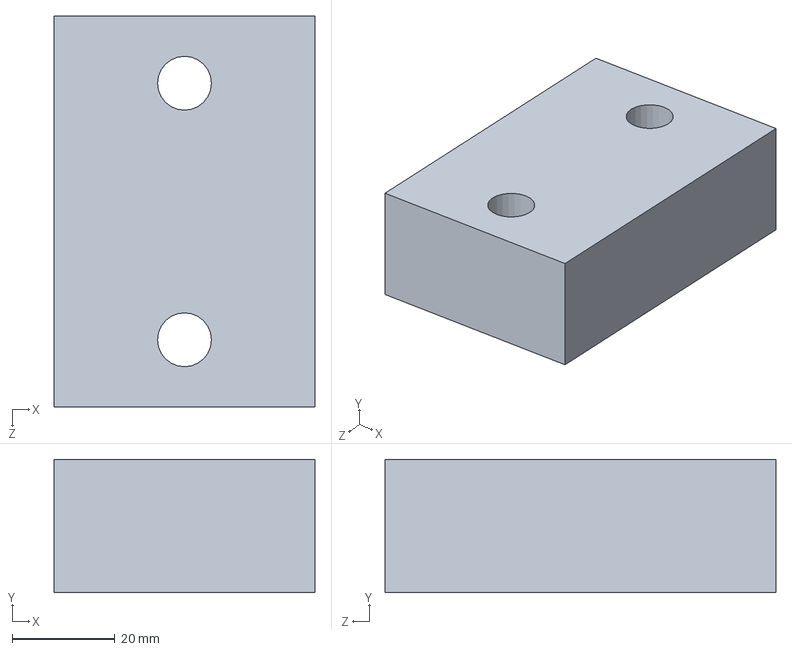
[picture p183: CAD file, 2012-08-10]
components/49/49model.SLDPRT
50.8 x 26.0 x 76.2 mm
