h4ck3rm1k3/Cold-Saw/components/54/OperationHandle/OperationHandle.SLDPRT

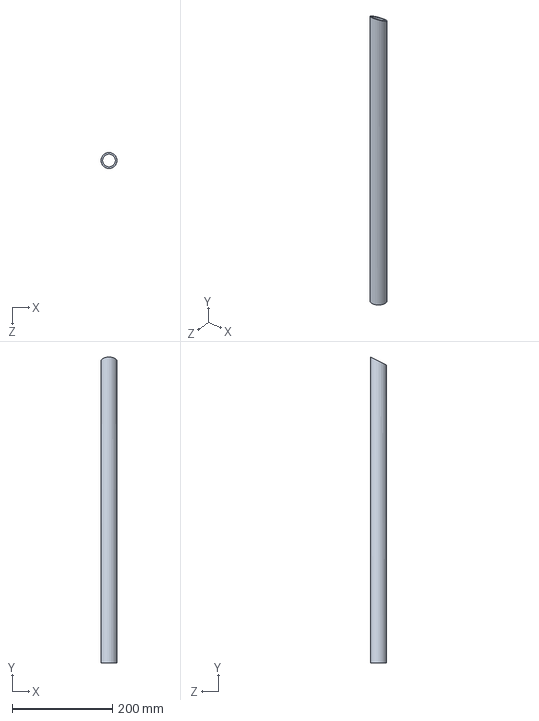
[picture p184: CAD file, 2012-07-10]
components/54/OperationHandle/OperationHandle.SLDPRT
31.8 x 609.6 x 31.8 mm
