h4ck3rm1k3/Cold-Saw/components/54/OperationHandleSupport/OperationHandleSupport.SLDPRT

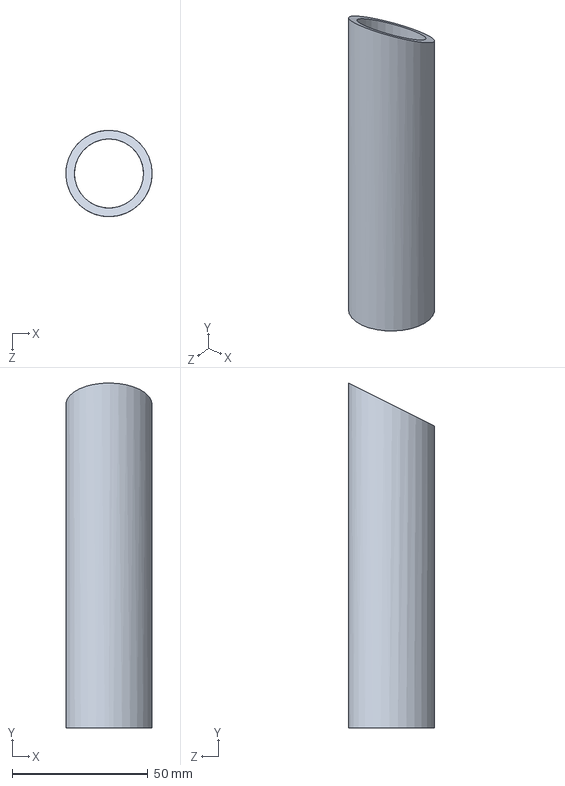
[picture p185: CAD file, 2012-07-10]
components/54/OperationHandleSupport/OperationHandleSupport.SLDPRT
31.8 x 127.0 x 31.8 mm
