h4ck3rm1k3/Cold-Saw/components/56/56model.SLDPRT

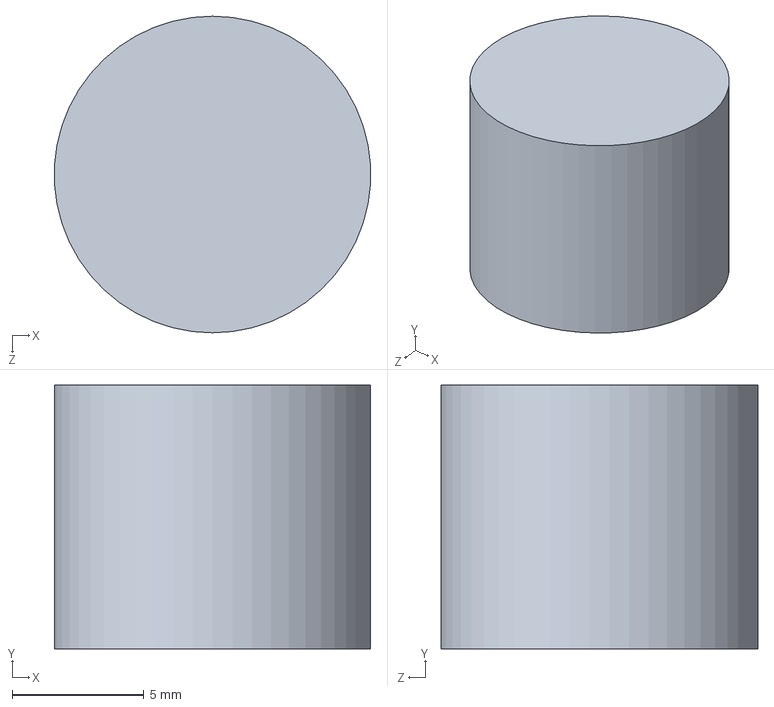
[picture p186: CAD file, 2012-07-04]
components/56/56model.SLDPRT
12.0 x 10.0 x 12.0 mm
