h4ck3rm1k3/Cold-Saw/components/57/57model.SLDPRT

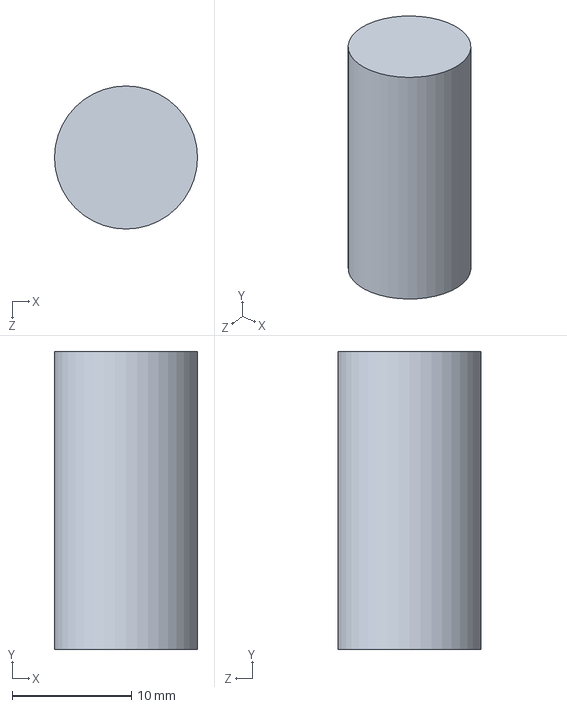
[picture p187: CAD file, 2012-07-04]
components/57/57model.SLDPRT
12.0 x 25.0 x 12.0 mm
