h4ck3rm1k3/Cold-Saw/components/60/MediumNut.SLDPRT

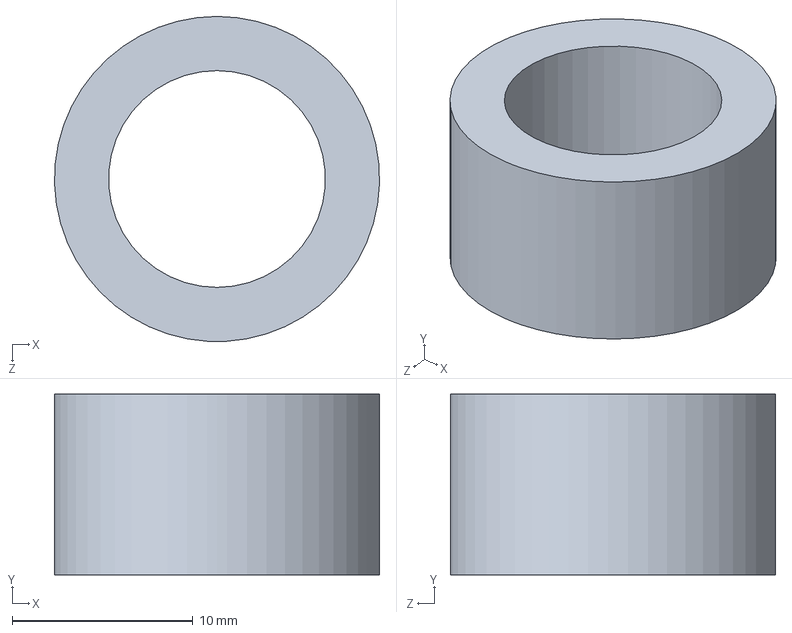
[picture p188: CAD file, 2012-07-04]
components/60/MediumNut.SLDPRT
18.0 x 10.0 x 18.0 mm
