h4ck3rm1k3/Cold-Saw/components/61/LargeNut.STEP

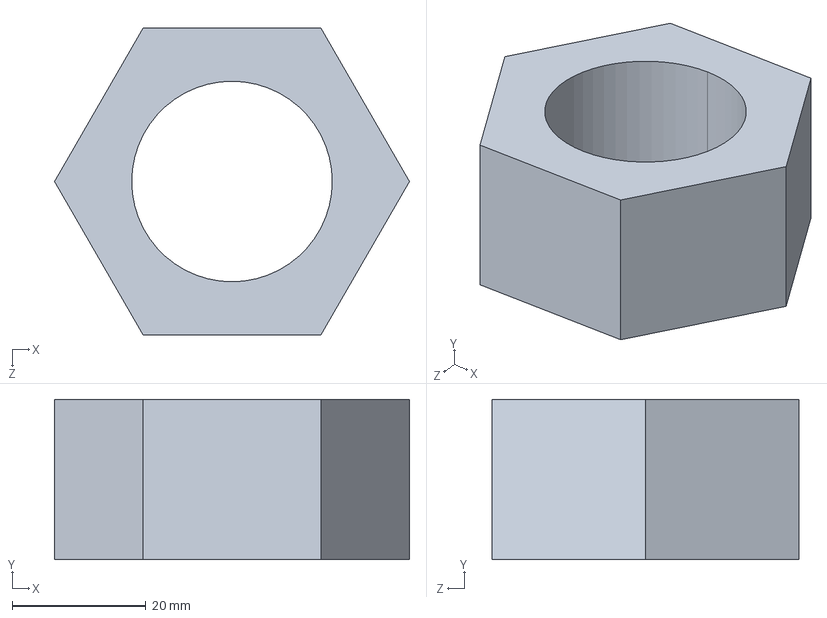
[picture p189: CAD file, 2012-07-04]
components/61/LargeNut.STEP
53.1 x 24.0 x 46.0 mm
