h4ck3rm1k3/Cold-Saw/components/62/LargeLHNut.STEP

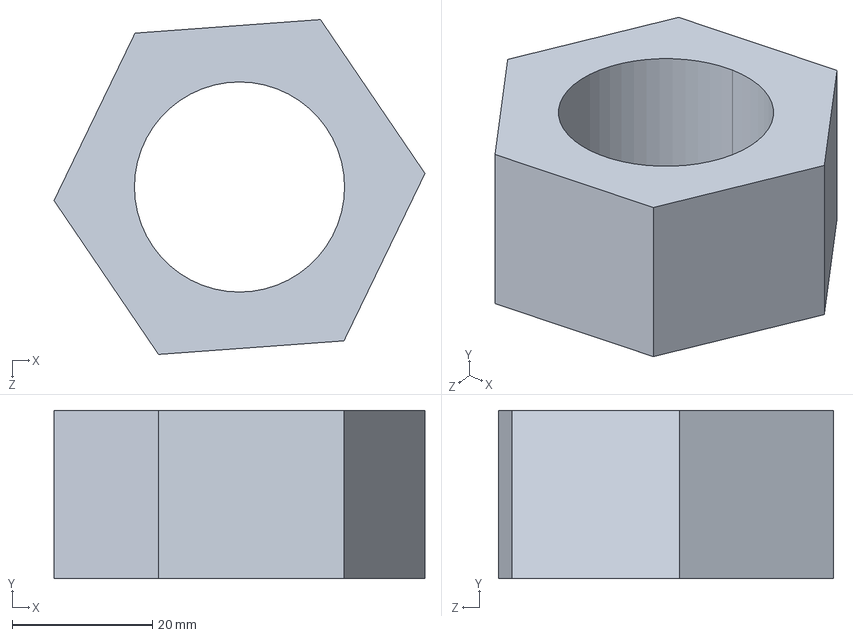
[picture p190: CAD file, 2012-07-04]
components/62/LargeLHNut.STEP
53.0 x 24.0 x 47.8 mm
