h4ck3rm1k3/Cold-Saw/components/67/67model.SLDPRT

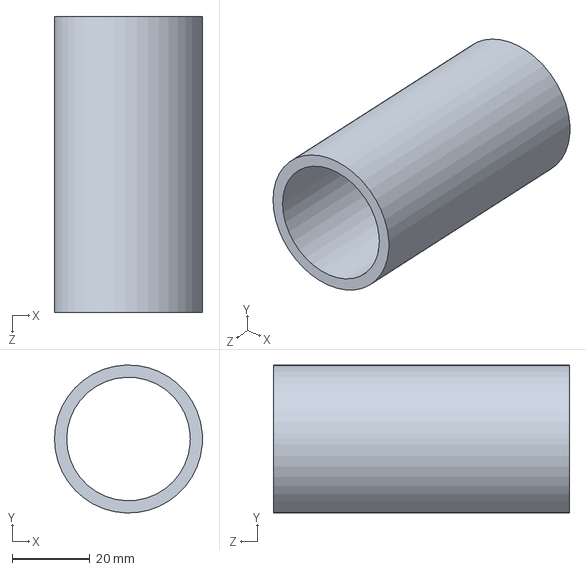
[picture p191: CAD file, 2012-08-10]
components/67/67model.SLDPRT
38.1 x 38.1 x 76.2 mm
