h4ck3rm1k3/Cold-Saw/components/68/68model.SLDPRT

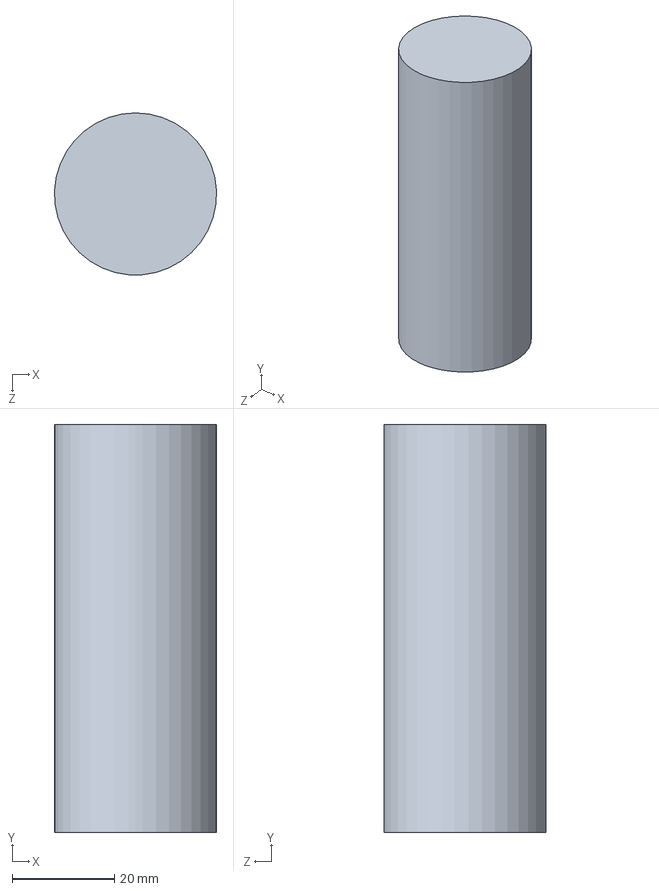
[picture p192: CAD file, 2012-08-10]
components/68/68model.SLDPRT
31.8 x 80.0 x 31.8 mm
