h4ck3rm1k3/Cold-Saw/components/69/69model.SLDPRT

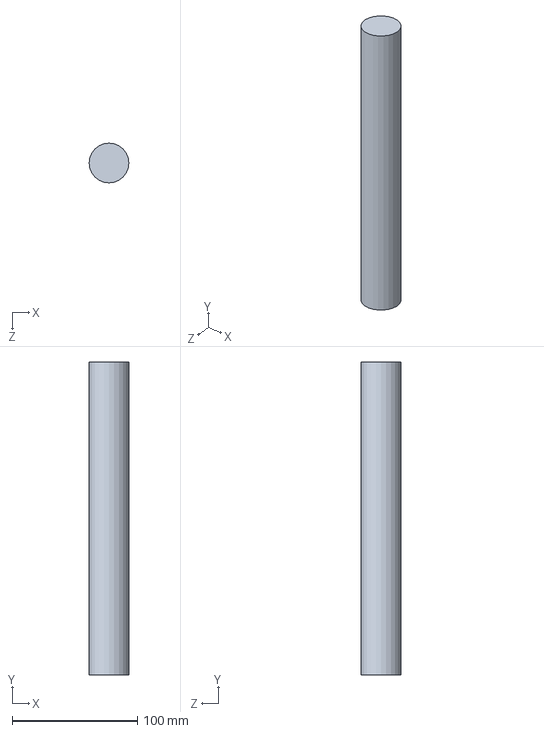
[picture p193: CAD file, 2012-08-10]
components/69/69model.SLDPRT
31.8 x 250.0 x 31.8 mm
