h4ck3rm1k3/Cold-Saw/components/84/84model.STEP

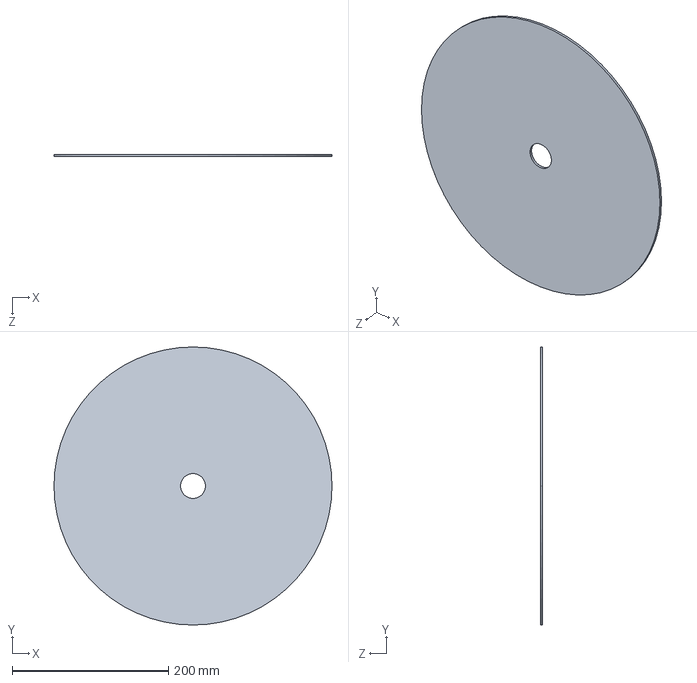
[picture p194: CAD file, 2012-07-04]
components/84/84model.STEP
355.6 x 355.6 x 3.00 mm
