h4ck3rm1k3/Cold-Saw/components/86/86model.SLDPRT

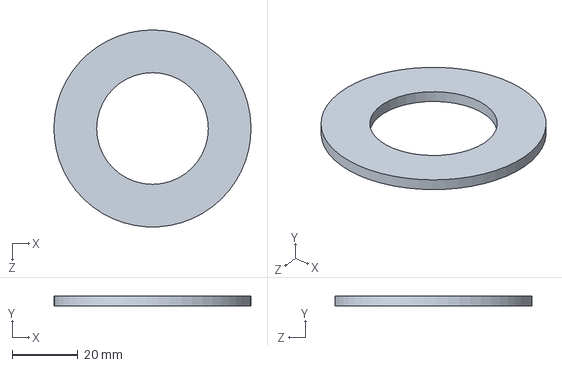
[picture p195: CAD file, 2012-08-11]
components/86/86model.SLDPRT
60.0 x 3.00 x 60.0 mm
