h4ck3rm1k3/Cold-Saw/components/87/87model.SLDPRT

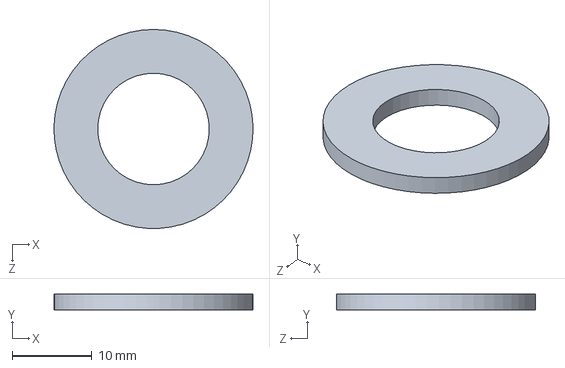
[picture p196: CAD file, 2012-08-11]
components/87/87model.SLDPRT
25.0 x 2.00 x 25.0 mm
