h4ck3rm1k3/Cold-Saw/components/89/89model.SLDPRT

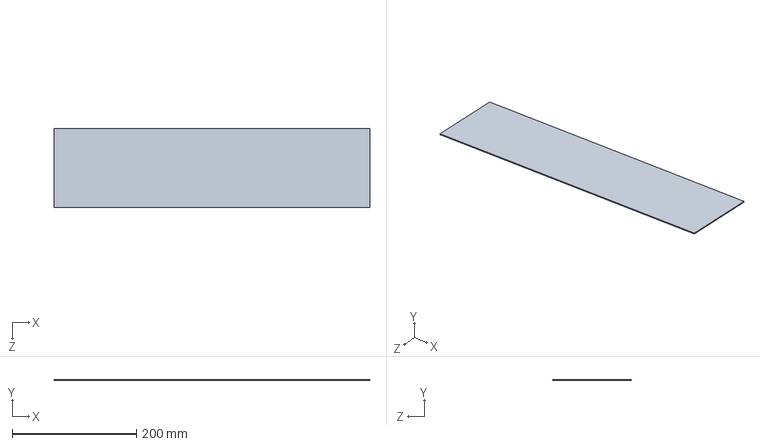
[picture p197: CAD file, 2012-08-14]
components/89/89model.SLDPRT
508.0 x 1.60 x 127.0 mm
