h4ck3rm1k3/Cold-Saw/components/90/90model.SLDPRT

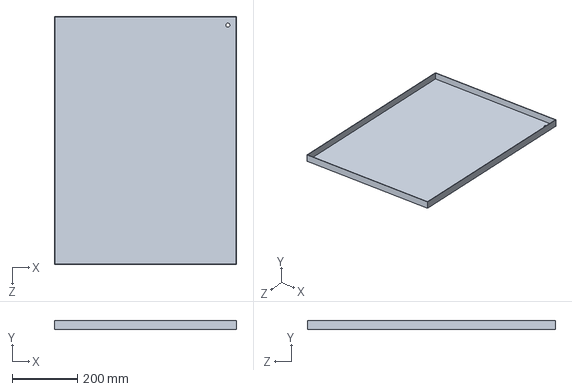
[picture p198: CAD file, 2012-08-14]
components/90/90model.SLDPRT
559.0 x 26.6 x 762.0 mm
