h4ck3rm1k3/Cold-Saw/components/91/91model.STEP

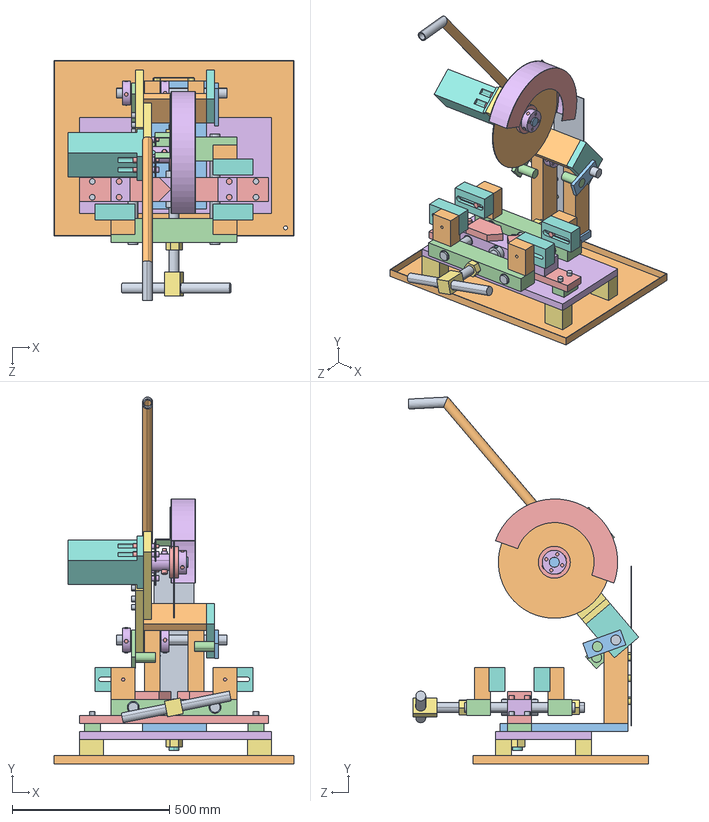
[picture p199: CAD file, 2012-08-20]
components/91/91model.STEP
762.0 x 1165.9 x 764.0 mm
89model
90model
40model
StopShaft x 2
Long2Screw x 13
MediumNut x 7
RotationSupportFlat
HydraulicMotor
OperationHandleSupport
OperationHandle
87model x 4
GuardSupport x 2
GuardSide x 2
GuardFlat
LongSupportFlat
ShortSupportFlat
LongScrew x 8
26model
86model x 3
38model
57model x 24
DriveCollar x 3
LargeNut x 2
68model
SupportShaft x 4
ShaftBlock2 x 2
SwivelPlate
49model x 2
2-2model
Baseplate
LongSpacer x 4
ClampJaw x 4
69model
ClampBlock x 4
67model x 6
MovingBlock x 2
Raiser x 2
FixedBlock
HandleBlock
LargeLHNut
56model x 3
44model x 2
84model
Spindle
48model x 2
MountDisc x 2
ShaftCoupling
Magnet x 6
