h4ck3rm1k3/Cold-Saw/components/92/Magnet.SLDPRT

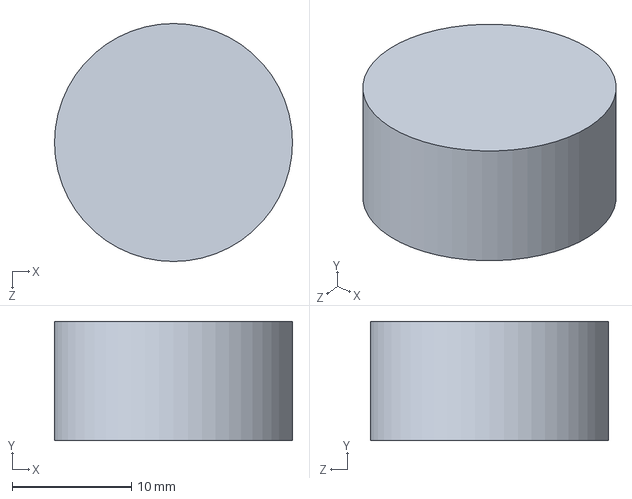
[picture p200: CAD file, 2012-07-04]
components/92/Magnet.SLDPRT
20.0 x 10.0 x 20.0 mm
