h4ck3rm1k3/Cold-Saw/devtemp/Base/AngleIndicator/AngleIndicator.STEP

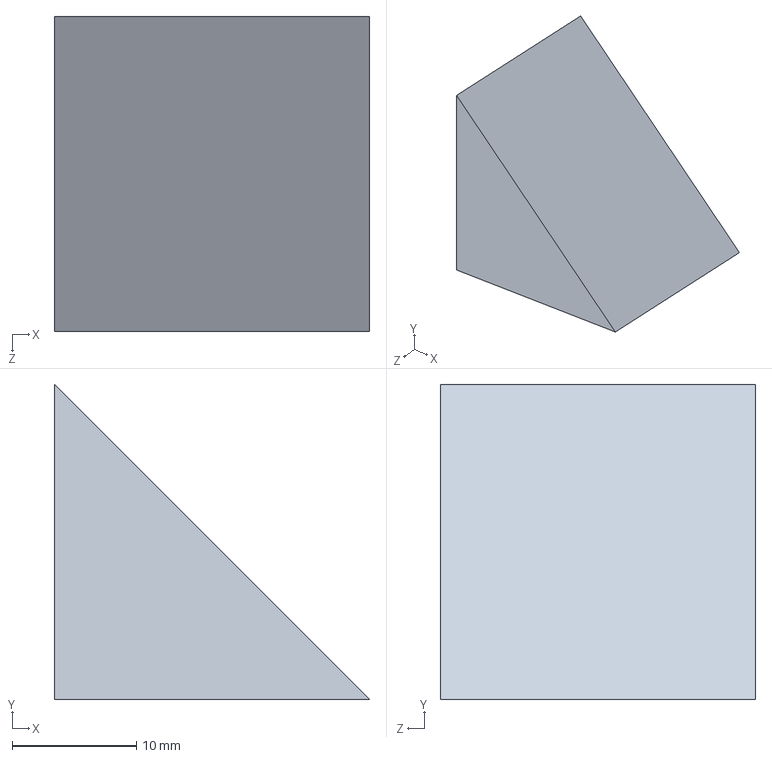
[picture p201: CAD file, 2012-07-04]
devtemp/Base/AngleIndicator/AngleIndicator.STEP
25.4 x 25.4 x 25.4 mm
