h4ck3rm1k3/Cold-Saw/devtemp/Base/BaseFlat/BaseFlat.STEP

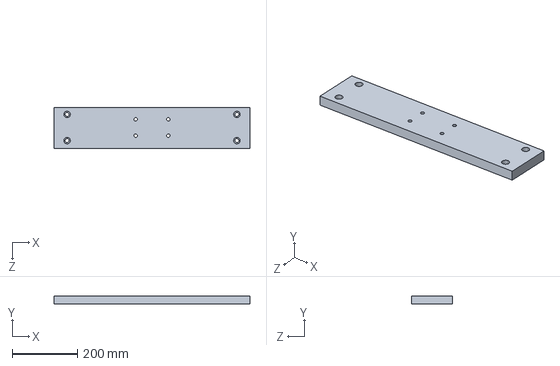
[picture p202: CAD file, 2012-07-04]
devtemp/Base/BaseFlat/BaseFlat.STEP
600.0 x 25.4 x 127.0 mm
