h4ck3rm1k3/Cold-Saw/devtemp/Base/IndicatorFlat/IndicatorFlat.STEP

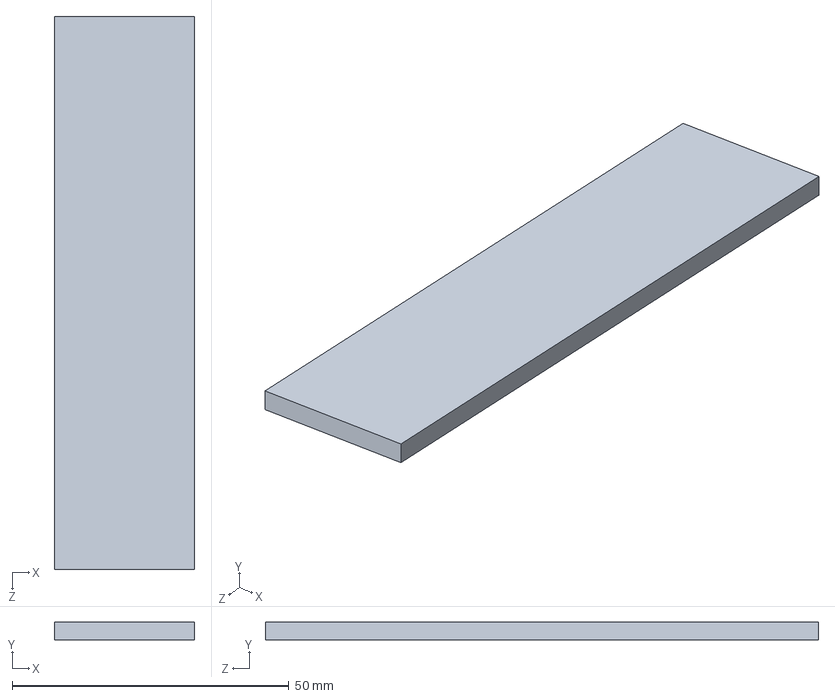
[picture p203: CAD file, 2012-07-04]
devtemp/Base/IndicatorFlat/IndicatorFlat.STEP
25.4 x 3.17 x 100.0 mm
