h4ck3rm1k3/Cold-Saw/devtemp/Base/ShortSpacer/ShortSpacer.STEP

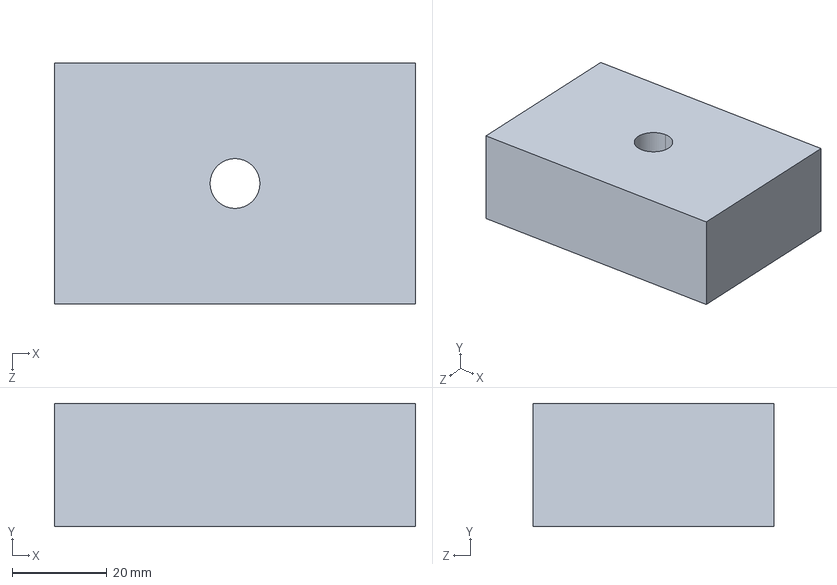
[picture p204: CAD file, 2012-07-09]
devtemp/Base/ShortSpacer/ShortSpacer.STEP
76.2 x 26.0 x 50.8 mm
