h4ck3rm1k3/Cold-Saw/devtemp/BladeGuard/GuardFlat/GuardFlat.STEP

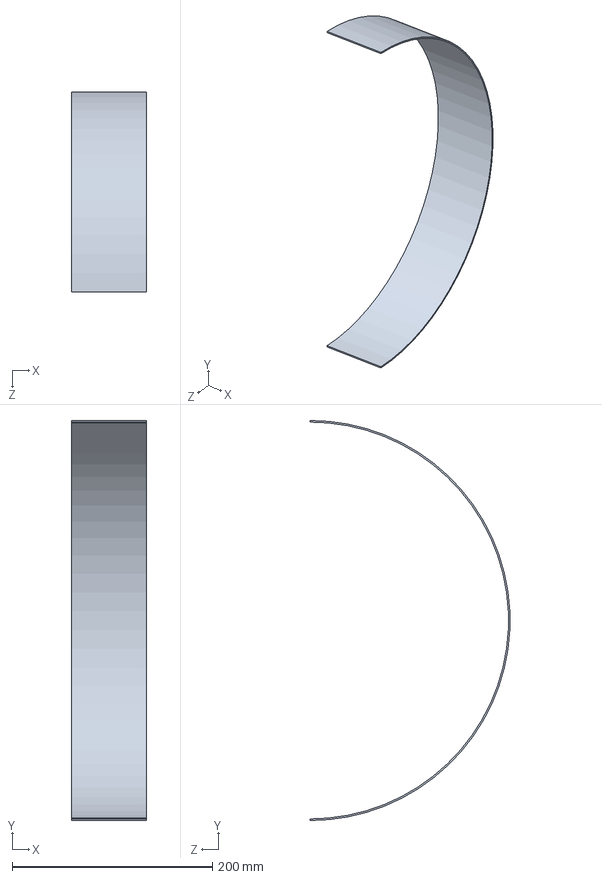
[picture p205: CAD file, 2012-07-04]
devtemp/BladeGuard/GuardFlat/GuardFlat.STEP
75.0 x 400.0 x 199.8 mm
