h4ck3rm1k3/Cold-Saw/devtemp/Rotation/Pin/Pin.STEP

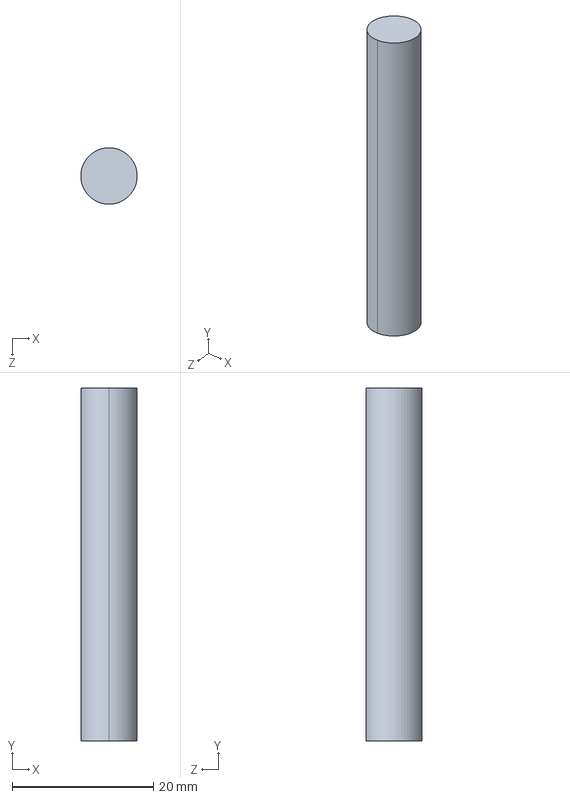
[picture p206: CAD file, 2012-07-04]
devtemp/Rotation/Pin/Pin.STEP
8.00 x 50.0 x 8.00 mm
