h4ck3rm1k3/Cold-Saw/devtemp/Shaft Accessories/PinCollar/PinCollar.STEP

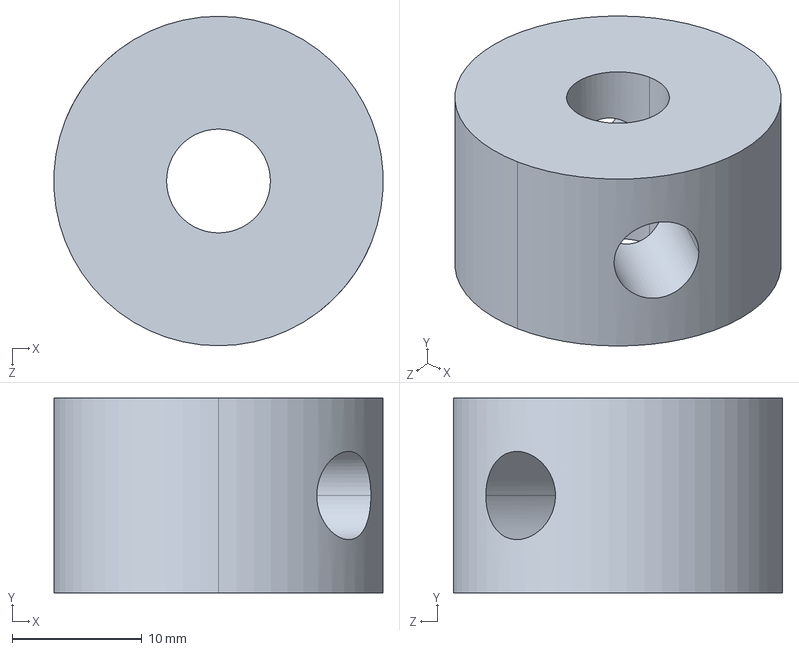
[picture p207: CAD file, 2012-07-04]
devtemp/Shaft Accessories/PinCollar/PinCollar.STEP
25.4 x 15.0 x 25.4 mm
