h4ck3rm1k3/Cold-Saw/devtemp/Swivel/MeasureFlat/MeasureFlat.SLDPRT

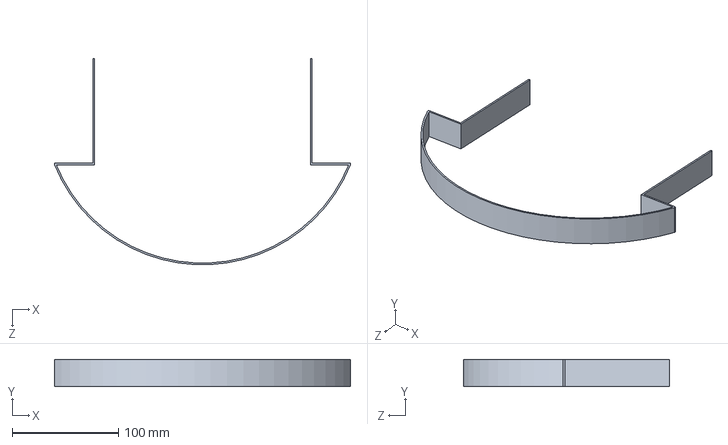
[picture p208: CAD file, 2012-07-05]
devtemp/Swivel/MeasureFlat/MeasureFlat.SLDPRT
278.3 x 25.4 x 193.8 mm
