h4ck3rm1k3/Cold-Saw/devtemp/Swivel/ShaftBlock/ShaftBlock.STEP

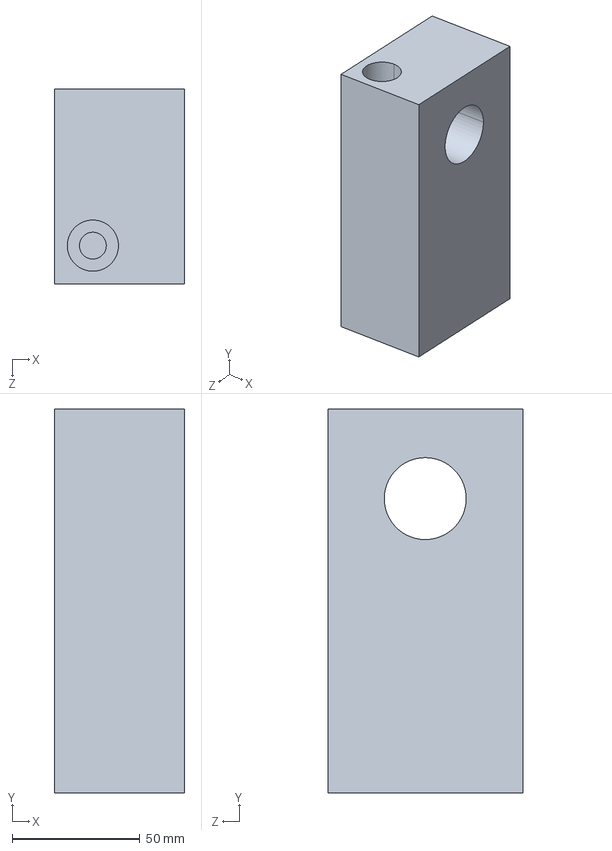
[picture p209: CAD file, 2012-07-04]
devtemp/Swivel/ShaftBlock/ShaftBlock.STEP
50.8 x 150.0 x 76.2 mm
