h4ck3rm1k3/Cold-Saw/(list of files, cad)

Other CAD files:
components/73/73model.SLDASM
components/37/MovingBlock.STEP
components/40/40model.SLDPRT
components/74/74.SLDPRT
devtemp/Magnet/Magnet.STEP
devtemp/Support/BridgeFlat/BridgeFlat.STEP
components/44/44model.SLDPRT
components/52/GuardFlat/GuardFlat.SLDPRT
components/17/17model.SLDDRW
components/18/HydraulicMotor.SLDPRT
components/21/Baseplate.SLDDRW
components/21/Baseplate.SLDPRT
components/21/BaseplateFab.SLDDRW
components/22/2-2drawing.SLDDRW
components/23/Raiser.SLDDRW
components/23/Raiser.SLDPRT
components/23/RaiserFab.SLDDRW
components/24/SwivelPlate.SLDDRW
components/24/SwivelPlate.SLDPRT
components/25/ShortSupportFlat.SLDDRW
components/25/ShortSupportFlat.SLDPRT
components/26/26model.SLDDRW
components/27/LongSupportFlat.SLDDRW
components/27/LongSupportFlat.SLDPRT
components/27/LongSupportFlatFab.SLDDRW
components/28/RotationSupportFlat.SLDDRW
components/28/RotationSupportFlat.SLDPRT
components/28/RotationSupportFlatFab.SLDDRW
components/29/GuardSupport.SLDDRW
components/29/GuardSupport.SLDPRT
components/30/GuardSide.SLDDRW
components/30/GuardSide.SLDPRT
components/31/HandleBlock.SLDDRW
components/31/HandleBlock.SLDPRT
components/32/LongSpacer.SLDDRW
components/32/LongSpacer.SLDPRT
components/33/ClampBlock.SLDDRW
components/33/ClampBlock.SLDPRT
components/33/ClampBlockFab.SLDDRW
components/34/ClampJaw.SLDDRW
components/34/ClampJaw.SLDPRT
components/35/ShaftBlock2.SLDDRW
components/36/36model.SLDDRW
components/36/FixedBlock.SLDDRW
components/36/FixedBlock.SLDPRT
components/36/FixedBlockFab.SLDDRW
components/37/MovingBlock.SLDDRW
components/37/MovingBlock.SLDPRT
components/37/MovingBlockFab.SLDDRW
components/38/38model.SLDDRW
components/40/40model.SLDDRW
components/41/DriveCollar.SLDDRW
components/41/DriveCollar.SLDPRT
components/42/MountDisc.SLDDRW
components/42/MountDisc.SLDPRT
components/42/MountDiscFab.SLDDRW
components/43/ShaftCoupling.SLDDRW
components/43/ShaftCoupling.SLDPRT
components/44/MediumShaftCollar.SLDDRW
components/45/SupportShaft.SLDDRW
components/45/SupportShaft.SLDPRT
components/46/Spindle.SLDDRW
components/46/Spindle.SLDPRT
components/47/StopShaft.SLDDRW
components/48/48model.SLDDRW
components/49/49model.SLDDRW
components/51/51model.SLDDRW
components/51/SupportAssemblyFab.SLDDRW
components/52/GuardFlat/GuardFlat.SLDDRW
components/53/53model.SLDDRW
components/54/54model.SLDDRW
components/55/55model.SLDDRW
components/58/LongScrew.SLDDRW
components/58/LongScrew.SLDPRT
components/58/LongScrew.STEP
components/59/Long2Screw.SLDDRW
components/59/Long2Screw.SLDPRT
components/59/Long2Screw.STEP
components/61/LargeNut.SLDDRW
components/61/LargeNut.SLDPRT
components/62/LargeLHNut.SLDDRW
components/62/LargeLHNut.SLDPRT
components/67/67model.SLDDRW
components/68/68model.SLDDRW
components/69/69model.SLDDRW
components/70/70model.SLDDRW
components/74/74model.SLDDRW
components/75/75model.SLDDRW
components/77/77model.SLDDRW
components/80/80model.SLDDRW
components/81/81model.SLDDRW
components/84/84model.SLDPRT
components/90/90model.SLDDRW
components/91/91model.SLDASM
components/91/91model.SLDDRW
devtemp/Base/AngleIndicator/AngleIndicator.SLDDRW
devtemp/Base/AngleIndicator/AngleIndicator.SLDPRT
devtemp/Base/BaseAssembly/BaseAssembly.SLDASM
devtemp/Base/BaseAssembly/BaseAssemblyLongFab.SLDDRW
devtemp/Base/BaseAssembly/BaseAssemblyShortFab.SLDDRW
devtemp/Base/BaseFlat/BaseFlat.SLDDRW
devtemp/Base/BaseFlat/BaseFlat.SLDPRT
devtemp/Base/BaseFlat/BaseFlatFab.SLDDRW
devtemp/Base/IndicatorFlat/IndicatorFlat.SLDDRW
devtemp/Base/IndicatorFlat/IndicatorFlat.SLDPRT
devtemp/Base/ShortSpacer/ShortSpacer.SLDDRW
devtemp/Base/ShortSpacer/ShortSpacer.SLDPRT
devtemp/CompleteAssembly/FullAssembly.SLDASM
devtemp/Fasteners/CollarSetscrew/CollarSetscrew.STEP
devtemp/Fasteners/CouplingSetscrew/CouplingSetscrew.SLDDRW
devtemp/Fasteners/CouplingSetscrew/CouplingSetscrew.STEP
devtemp/Fasteners/ShortThreadedRod/ShortThreadedRod.SLDDRW
devtemp/Fasteners/ShortThreadedRod/ShortThreadedRod.SLDPRT
devtemp/Fasteners/ThreadedRod/ThreadedRod.SLDDRW
devtemp/Fasteners/ThreadedRod/ThreadedRod.SLDPRT
devtemp/Fasteners/ThreadedRod/ThreadedRod.STEP
devtemp/Magnet/Magnet.SLDDRW
devtemp/Rotation/DriveAssembly/DriveAssembly.SLDASM
devtemp/Rotation/Pin/Pin.SLDDRW
devtemp/Rotation/Pin/Pin.SLDPRT
devtemp/Shaft Accessories/PinCollar/PinCollar.SLDDRW
devtemp/Shaft Accessories/PinCollar/PinCollar.SLDPRT
devtemp/Shaft Accessories/SupportThrustWasher/SupportThrustWasher.SLDDRW
devtemp/Shaft Accessories/SupportThrustWasher/SupportThrustWasher.SLDPRT
devtemp/Shaft Accessories/SupportThrustWasher/SupportThrustWasher.STEP
devtemp/Support/SupportSystem/SupportAssembly.SLDASM
devtemp/Swivel/MeasureFlat/MeasureFlat.SLDDRW
devtemp/Swivel/ShaftBlock/ShaftBlock.SLDDRW
devtemp/Swivel/ShaftBlock/ShaftBlock.SLDPRT
devtemp/Swivel/SwivelAssembly/ShaftBlockWeld.SLDDRW
devtemp/Swivel/SwivelAssembly/SwivelAssembly.SLDASM
devtemp/Vise/ViseAssembly/MovingClampNut.SLDDRW
devtemp/Vise/ViseAssembly/RaiserFixed.SLDDRW
devtemp/Vise/ViseAssembly/ViseAssembly.SLDASM
