h4ck3rm1k3/Cold-Saw/components/51/SupportAssemblyFab.JPG

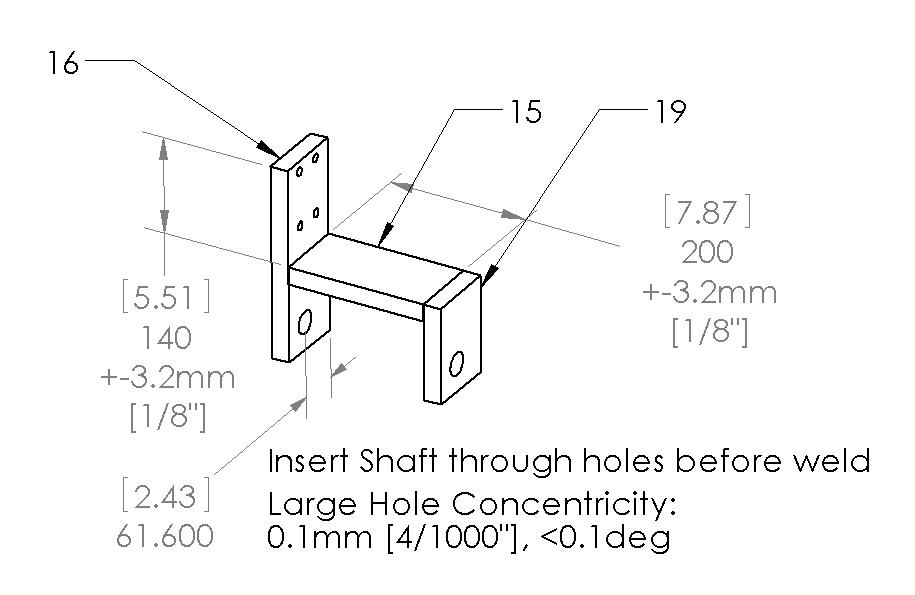
components/51/SupportAssemblyFab.JPG
