h4ck3rm1k3/Cold-Saw/devtemp/Base/BaseAssembly/BaseAssembly.JPG

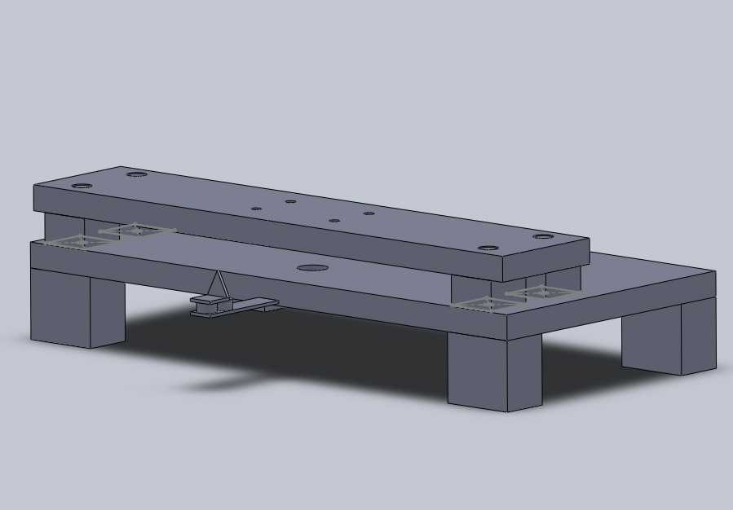
devtemp/Base/BaseAssembly/BaseAssembly.JPG
