h4ck3rm1k3/Cold-Saw/devtemp/Base/BaseAssembly/BaseAssemblyLongFab.JPG

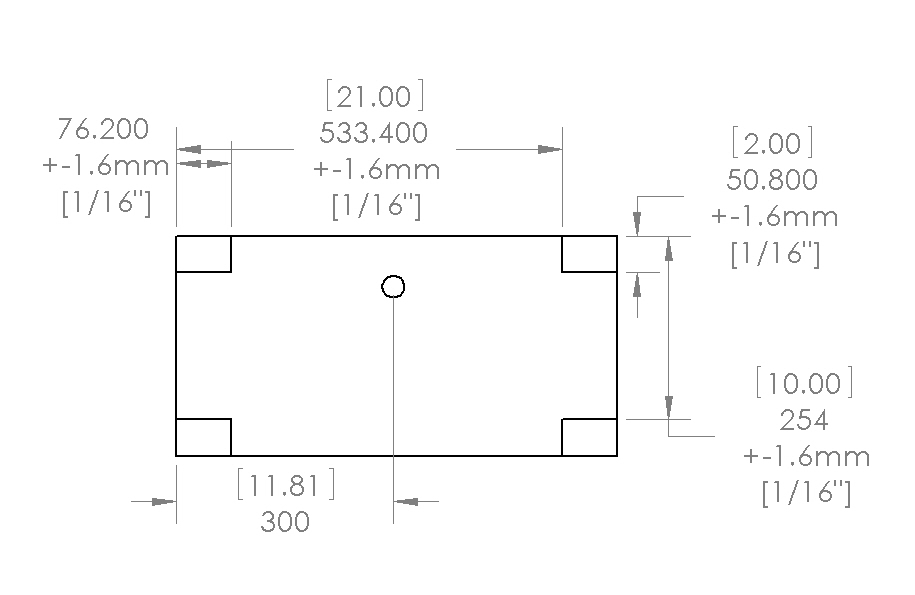
devtemp/Base/BaseAssembly/BaseAssemblyLongFab.JPG
