h4ck3rm1k3/Cold-Saw/devtemp/Base/BaseAssembly/BaseAssemblyShortFab.JPG

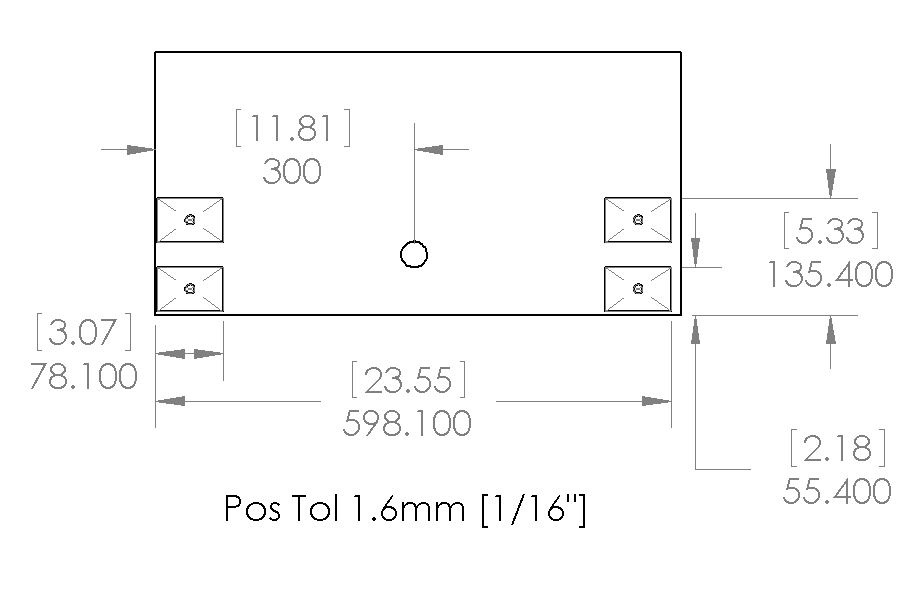
devtemp/Base/BaseAssembly/BaseAssemblyShortFab.JPG
