h4ck3rm1k3/Cold-Saw/devtemp/CompleteAssembly/FullAssembly.JPG

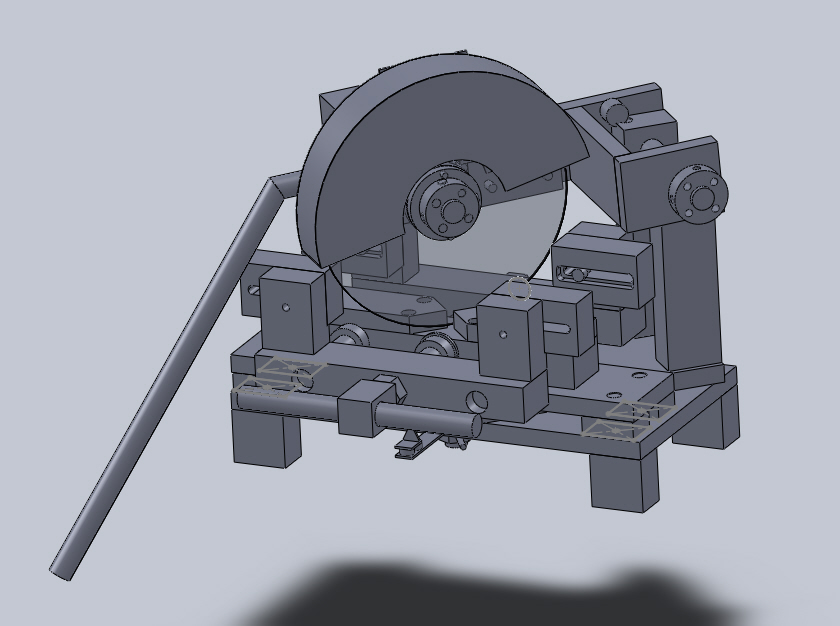
devtemp/CompleteAssembly/FullAssembly.JPG
