h4ck3rm1k3/Cold-Saw/devtemp/Rotation/DriveAssembly/DriveAssembly.JPG

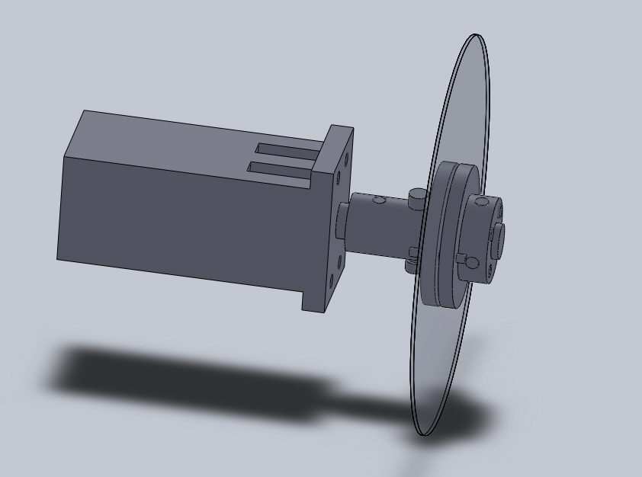
devtemp/Rotation/DriveAssembly/DriveAssembly.JPG
