h4ck3rm1k3/Cold-Saw/devtemp/Rotation/DriveAssembly/RotationDiagram.jpg

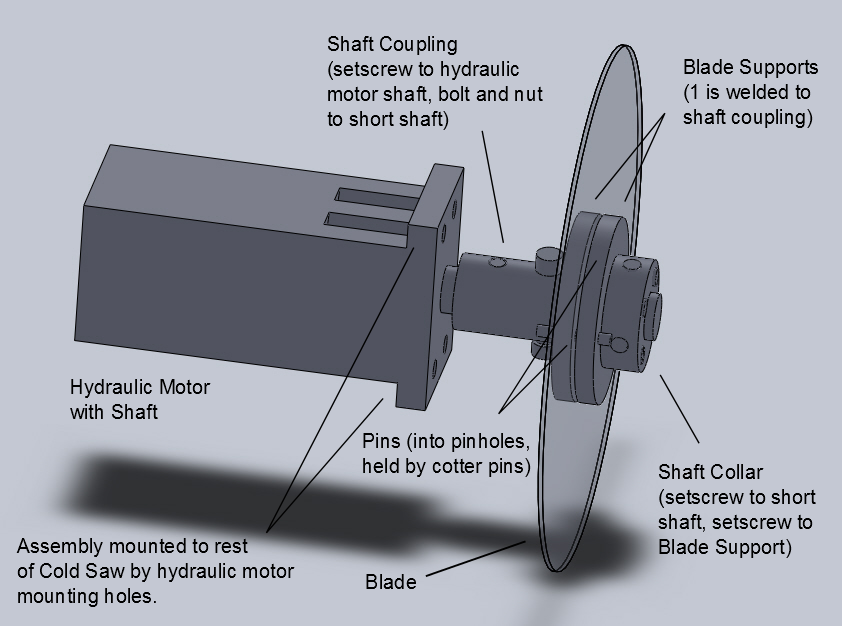
devtemp/Rotation/DriveAssembly/RotationDiagram.jpg
