h4ck3rm1k3/Cold-Saw/devtemp/Support/SupportSystem/SupportAssembly.JPG

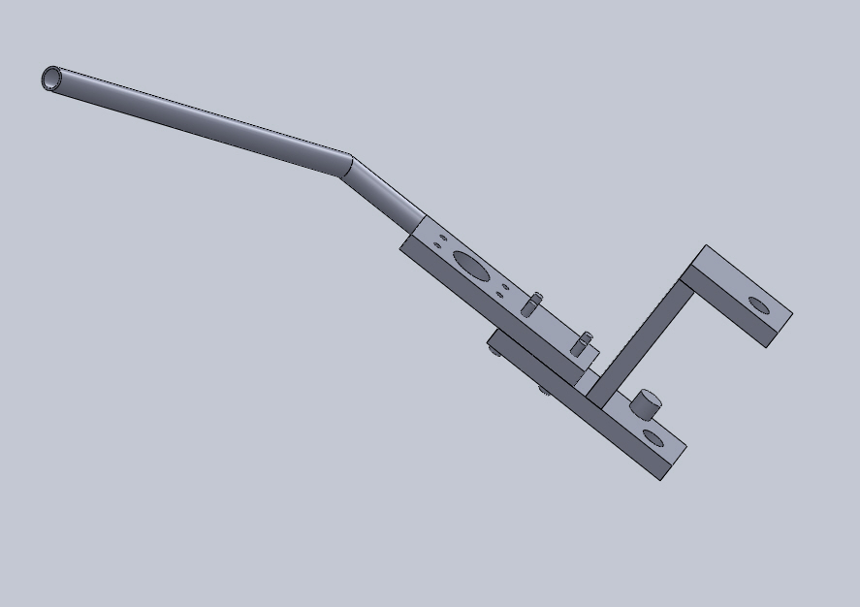
devtemp/Support/SupportSystem/SupportAssembly.JPG
