h4ck3rm1k3/Cold-Saw/devtemp/Swivel/SwivelAssembly/ShaftBlockWeld.JPG

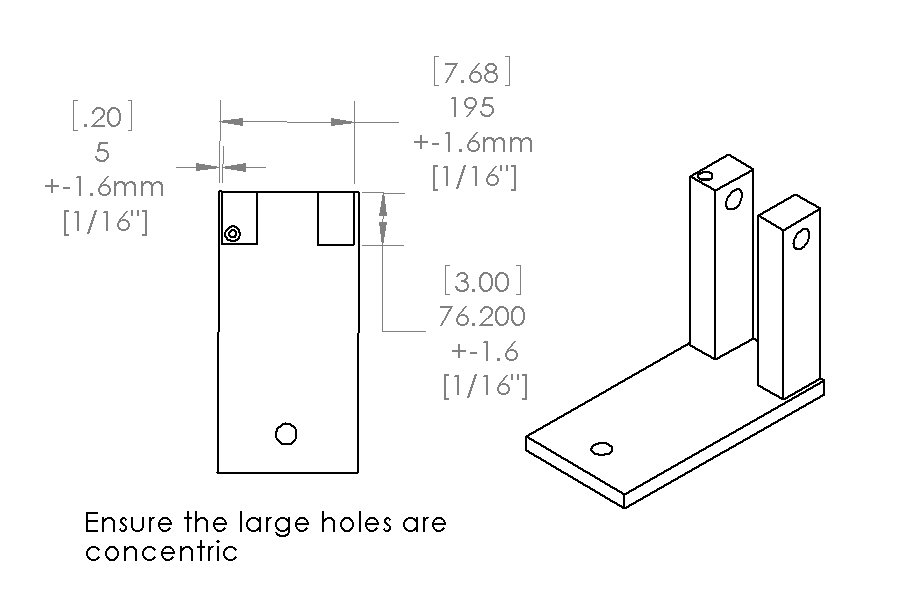
devtemp/Swivel/SwivelAssembly/ShaftBlockWeld.JPG
