h4ck3rm1k3/Cold-Saw/devtemp/Swivel/SwivelAssembly/SwivelAssembly.JPG

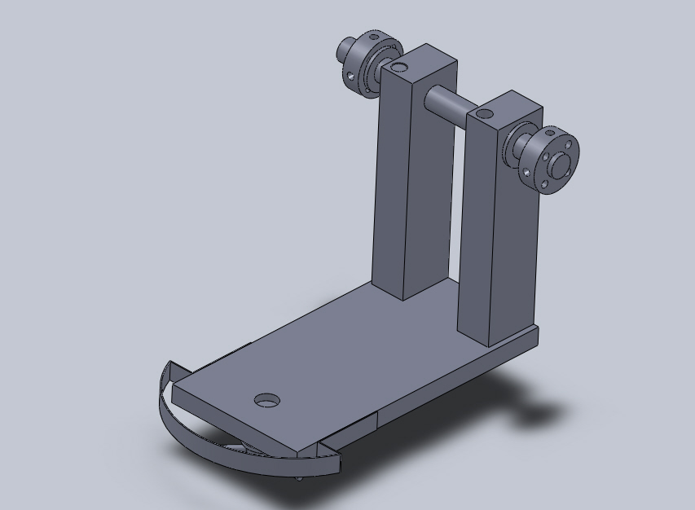
devtemp/Swivel/SwivelAssembly/SwivelAssembly.JPG
