h4ck3rm1k3/Cold-Saw/devtemp/Vise/ViseAssembly/MovingClampNut.JPG

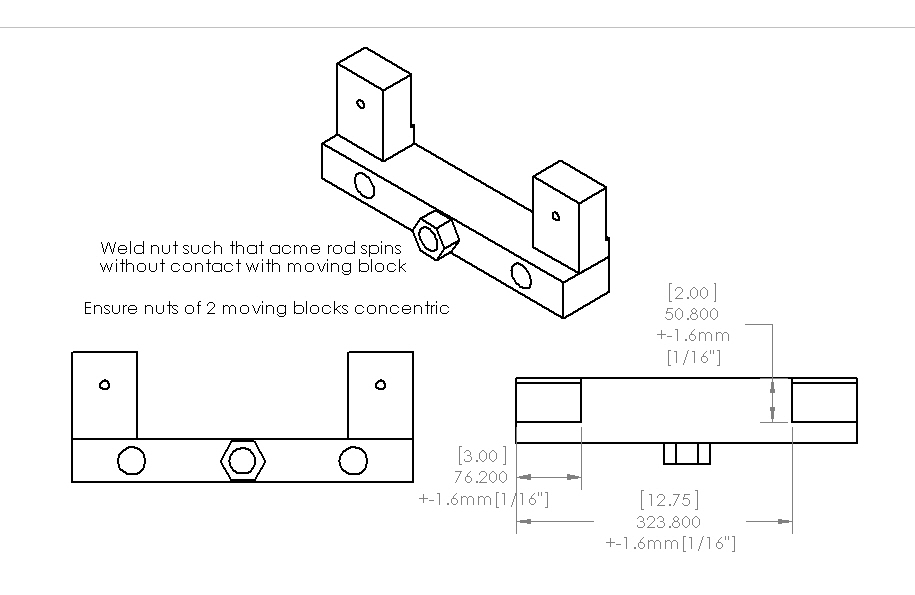
devtemp/Vise/ViseAssembly/MovingClampNut.JPG
