h4ck3rm1k3/Cold-Saw/devtemp/Vise/ViseAssembly/RaiserstoFixedBlock.JPG

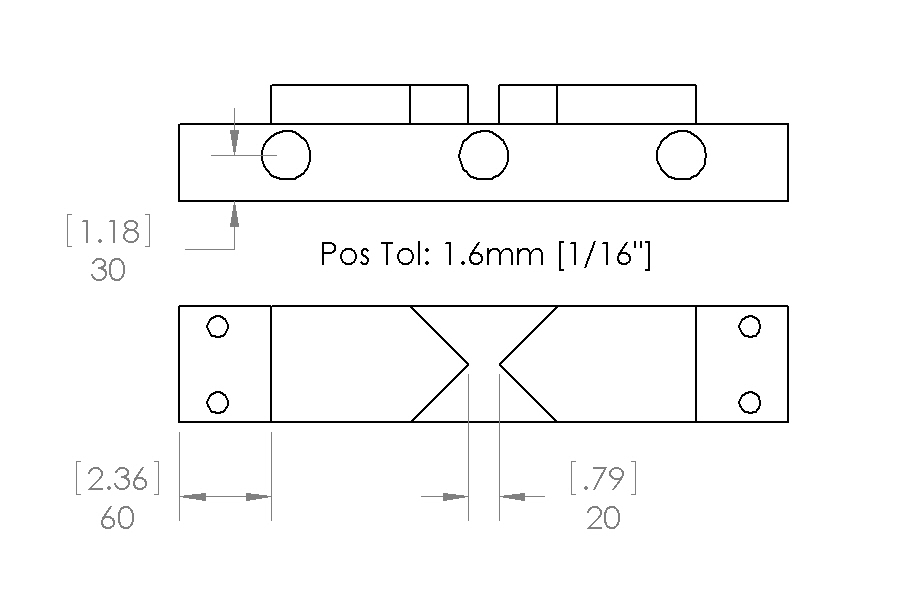
devtemp/Vise/ViseAssembly/RaiserstoFixedBlock.JPG
