h4ck3rm1k3/Cold-Saw/devtemp/Vise/ViseAssembly/ViseAssembly.JPG

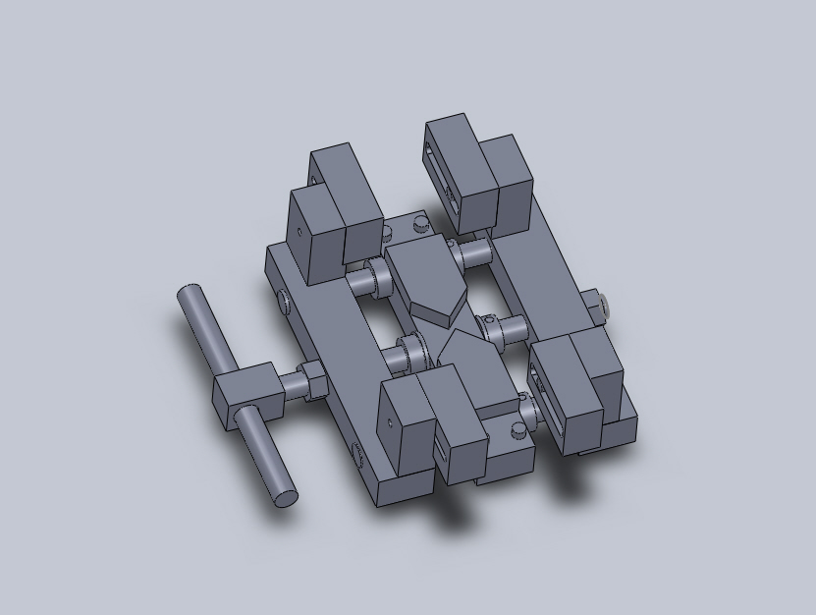
devtemp/Vise/ViseAssembly/ViseAssembly.JPG
