h4ck3rm1k3/Cold-Saw/devtemp/Swivel/MeasureFlat/MeasureFlat.JPG

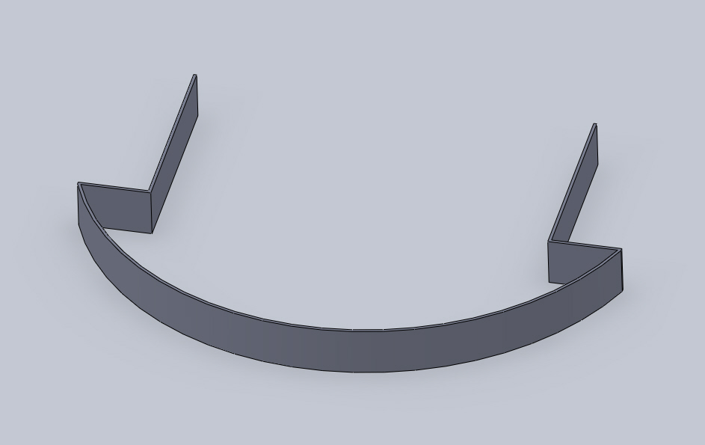
devtemp/Swivel/MeasureFlat/MeasureFlat.JPG
