h4ck3rm1k3/Cold-Saw/devtemp/Swivel/MeasureFlat/MeasureFlatD.JPG

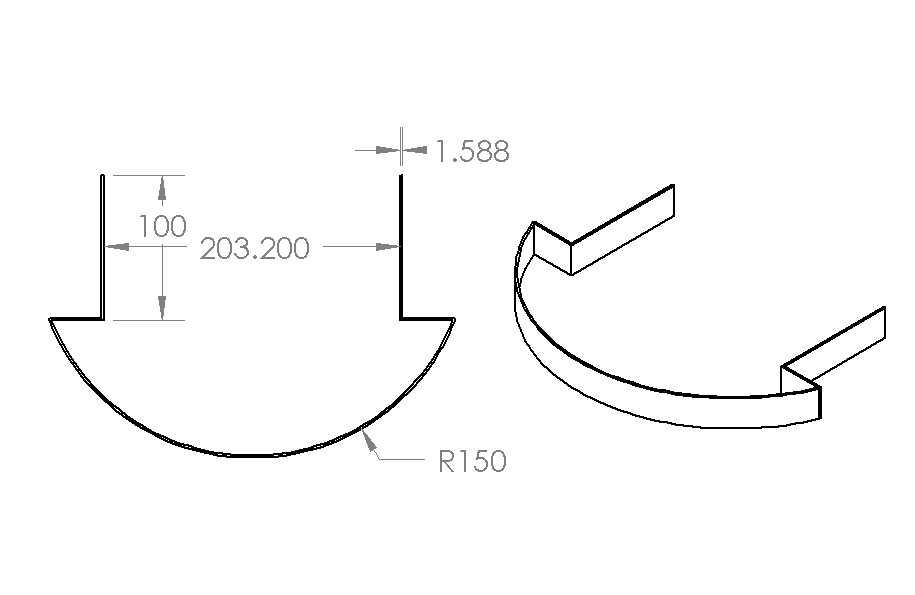
devtemp/Swivel/MeasureFlat/MeasureFlatD.JPG
