h4ck3rm1k3/Cold-Saw/components/29/GuardSupport.PDF

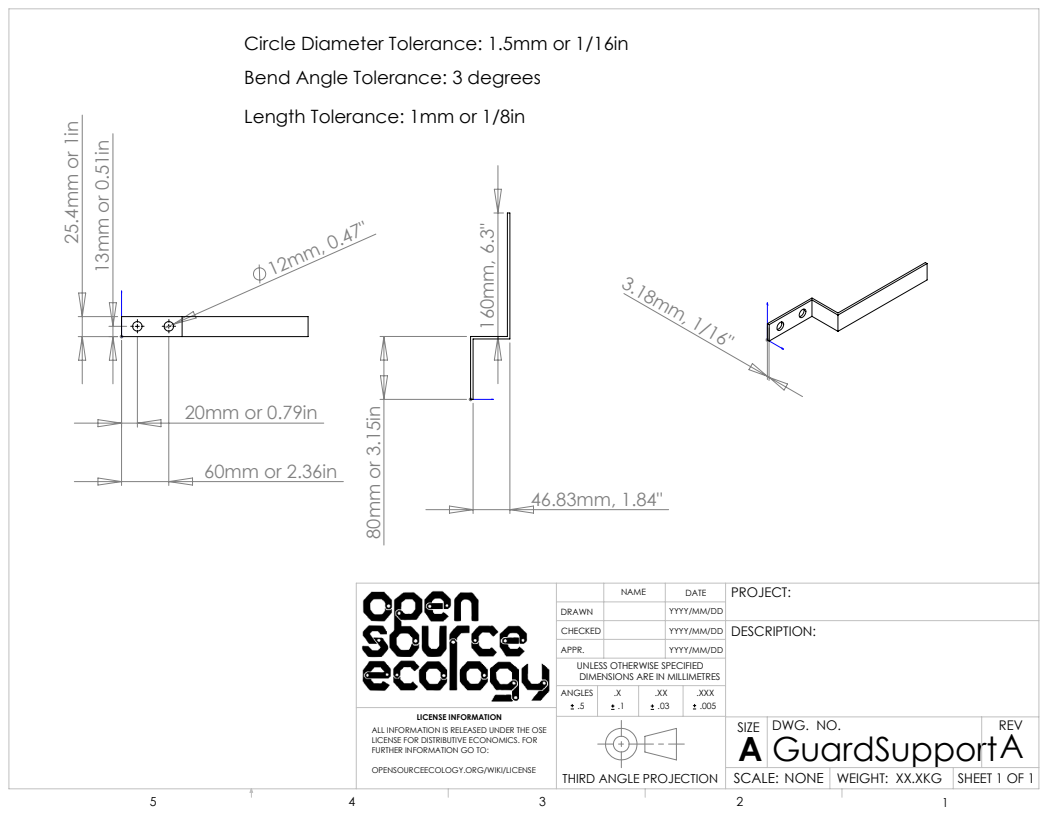
[picture p225: page 1]
DWG. NO.; THIRD ANGLE PROJECTION; NONE WEIGHT: XX.XKG; LICENSE INFORMATION; SHEET 1 OF 1

Circle Diameter Tolerance: 1.5mm or 1/16in
Bend Angle Tolerance: 3 degrees
Length Tolerance: 1mm or 1/8in

YYYY/MM/DD
GuardSupport

DRAWN
CHECKED
APPR.
UNLESS OTHERWISE SPECIFIED
DIMENSIONS ARE IN MILLIMETRES

ALL INFORMATION IS RELEASED UNDER THE OSE
LICENSE FOR DISTRIBUTIVE ECONOMICS. FOR
FURTHER INFORMATION GO TO:
OPENSOURCEECOLOGY.ORG/WIKI/LICENSE
